brbeardm/PelletPirate/zzz_documentation/pcb_schematics/PCB_V0.png

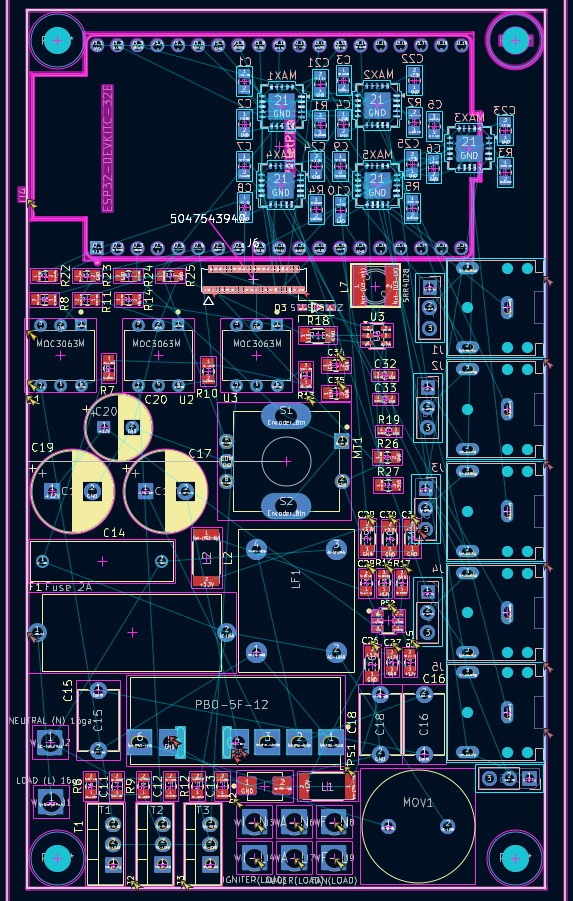
zzz_documentation/pcb_schematics/PCB_V0.png
