brbeardm/PelletPirate/KiCad/ESP_Breadboard/gerbers/PelletPirate_ESP-3D_views.pdf

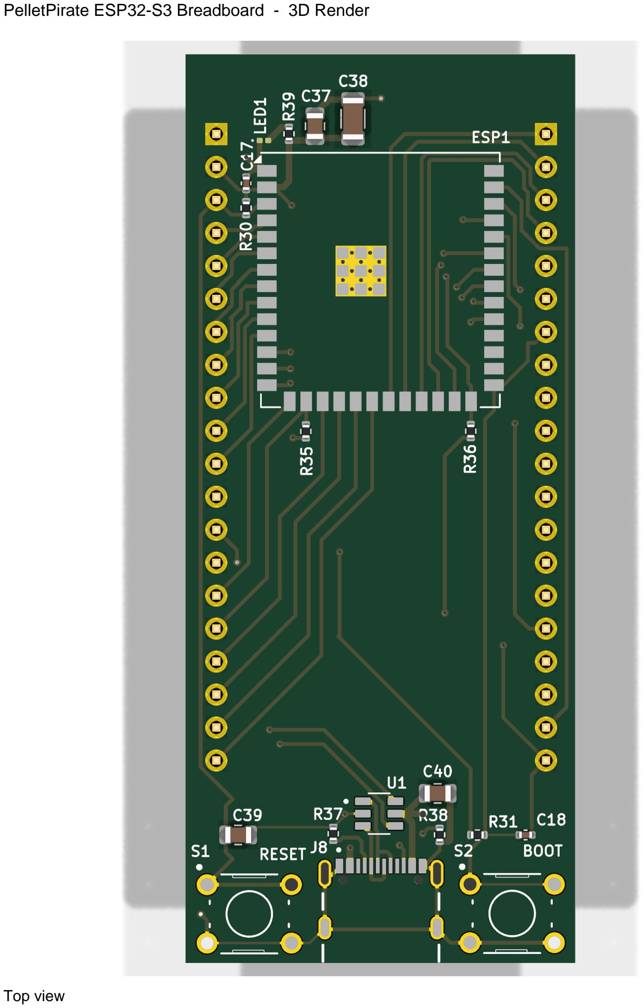
[picture p2: page 1]

PelletPirate ESP32-S3 Breadboard - 3D Render

Top view

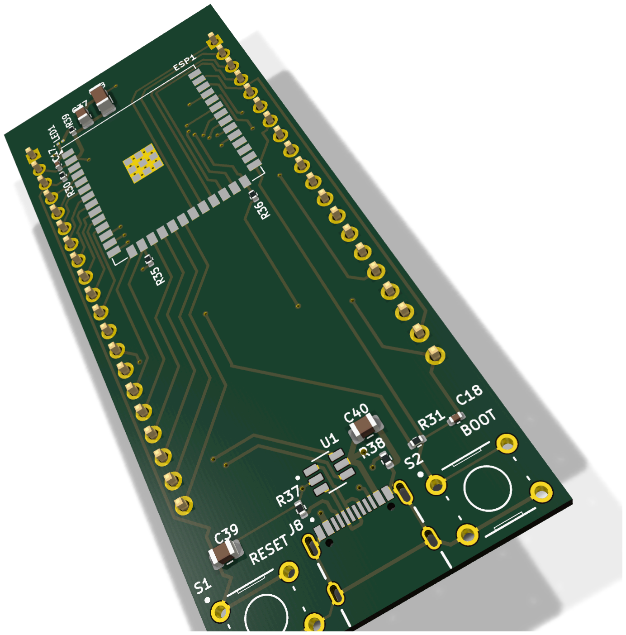
[picture p3: figure]

Perspective view

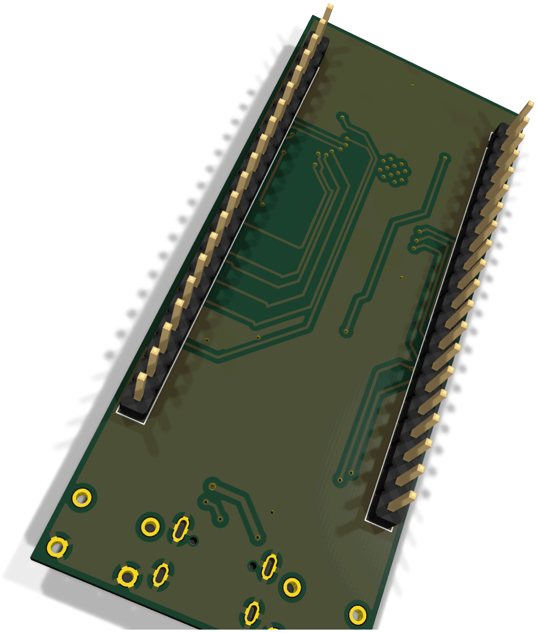
[picture p4: figure]

Bottom view - breadboard pin rails
