brbeardm/PelletPirate/KiCad/FPC_for_PCB_to_LCD_RevH/FPCWay_REV_H_Package/PCB_to_LCD_FPC_REV_H_DimensionSheet.pdf

FPC edge Y0

Finger profiles (mm) — Y0 = FPC edge, +Y toward ribbon | GOLDEN-FINGER SPECIFICATION
Connector | Hirose FH26W-39S-0.3SHW(60), bottom-contact ZIF
Positions / pitch | 39 / 0.30 mm (straight-through 1->1 .. 39->39)

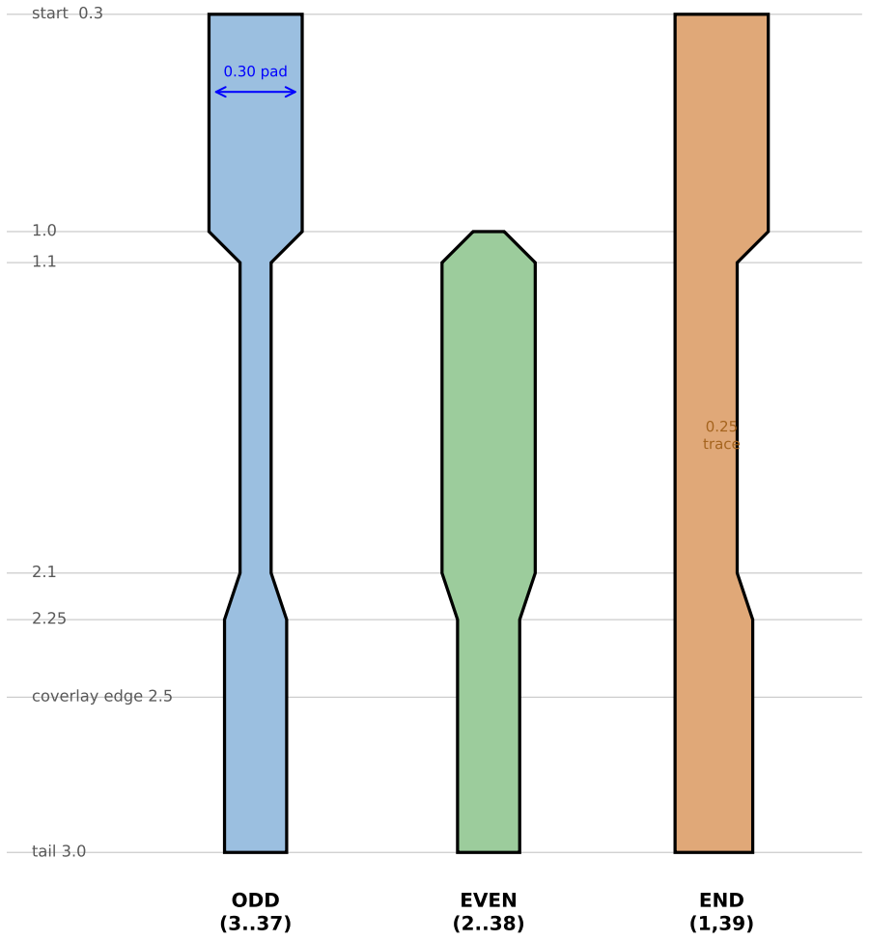
[picture p5: figure]
ODD (3..37); EVEN (2..38); END (1,39); start 0.3; coverlay edge 2.5; tail 3.0; 0.30 pad; 0.25 trace

Pattern | STAGGERED 2-row (odd short / even long) — matches datasheet
Odd (3..37) | exposed 1.1 mm; 0.30 pad -> 0.1 trace -> 0.2 ribbon
Even (2..38) | exposed 2.1 mm; 0.1 tip -> 0.30 pad -> 0.2 ribbon
Ends (1,39) | 0.30 pad -> 0.20 -> 0.25 outer trace, mirror pair
Finger setback | 0.30 mm from FPC leading edge
Edge margin | 0.15 mm (outer copper to FPC side edge)
Tongue F/C/B | 12.0 / 11.4 / 10.8 mm
Taper spacing | 0.0707 mm min (= 0.10 x cos45, per datasheet)
Tip relief | R0.2 max, two outer tongue corners
Coverlay | SINGLE window over finger bank, 12.0 x 2.5 mm (back)
Construction | 2-layer flex; 39 plated through-vias front->back
Finish / thick. | ENIG; mating thickness 0.20 +/-0.03 mm
Stiffener | 0.15 mm SUS under connector area

### NOTES

1. Finger rebuilt to Hirose Recommended-FPC STAGGERED pattern (prior comb wrong).
2. 0.0707 mm taper spacing is intentional (datasheet) — confirm process capability.
3. Coverlay = one window; per-pad mask openings in gerbers are indicative only.
PelletPirate LCD-to-Main FPC | Golden Finger — Hirose FH26W-39S-0.3SHW | REV H | 2026-08-16
