brbeardm/PelletPirate/zzz_documentation/pcb_schematics/ACtoDC.pdf

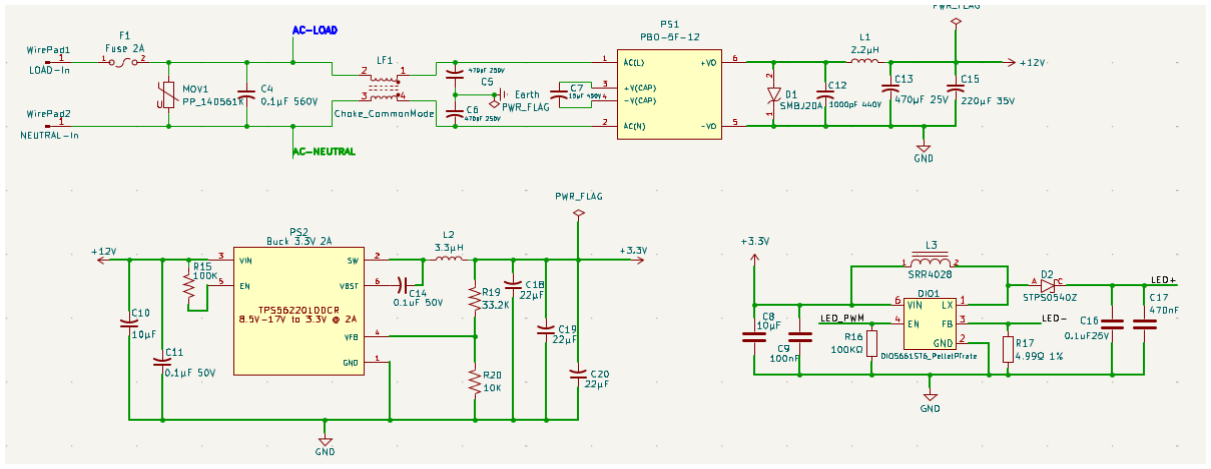
[picture p6: figure]
