brbeardm/PelletPirate/KiCad/FPC_for_PCB_to_LCD_RevF/report.txt

Info: Backing up file 'C:\DEVELOPMENT\pelletpirate\KiCad\FPC_for_PCB_to_LCD_RevF\sym-lib-table' to 'C:\DEVELOPMENT\pelletpirate\KiCad\FPC_for_PCB_to_LCD_RevF\rescue-backup\sym-lib-table-2026-08-14-11-17-50'.
Info: Backing up file '' to 'C:\DEVELOPMENT\pelletpirate\KiCad\FPC_for_PCB_to_LCD_RevF\rescue-backup\-2026-08-14-11-17-50'.
Info: Backing up file 'C:\DEVELOPMENT\pelletpirate\KiCad\FPC_for_PCB_to_LCD_RevF\PCB_to_LCD_FPC_REV_F.sch' to 'C:\DEVELOPMENT\pelletpirate\KiCad\FPC_for_PCB_to_LCD_RevF\rescue-backup\PCB_to_LCD_FPC_REV_F-2026-08-14-11-17-50.sch'.
Info: Backing up file 'C:\DEVELOPMENT\pelletpirate\KiCad\FPC_for_PCB_to_LCD_RevF\PCB_to_LCD_FPC_REV_F.kicad_pro' to 'C:\DEVELOPMENT\pelletpirate\KiCad\FPC_for_PCB_to_LCD_RevF\rescue-backup\PCB_to_LCD_FPC_REV_F-2026-08-14-11-17-50.kicad_pro'.
Info: Backing up file 'C:\DEVELOPMENT\pelletpirate\KiCad\FPC_for_PCB_to_LCD_RevF\PCB_to_LCD_FPC_REV_F-cache.lib' to 'C:\DEVELOPMENT\pelletpirate\KiCad\FPC_for_PCB_to_LCD_RevF\rescue-backup\PCB_to_LCD_FPC_REV_F-cache-2026-08-14-11-17-50.lib'.
Info: Backing up file 'C:\DEVELOPMENT\pelletpirate\KiCad\FPC_for_PCB_to_LCD_RevF\PCB_to_LCD_FPC_REV_F.cache.lib' to 'C:\DEVELOPMENT\pelletpirate\KiCad\FPC_for_PCB_to_LCD_RevF\rescue-backup\PCB_to_LCD_FPC_REV_F.cache-2026-08-14-11-17-50.lib'.
Info: Backing up file 'C:\DEVELOPMENT\pelletpirate\KiCad\FPC_for_PCB_to_LCD_RevF\PCB_to_LCD_FPC_REV_F-rescue.lib' to 'C:\DEVELOPMENT\pelletpirate\KiCad\FPC_for_PCB_to_LCD_RevF\rescue-backup\PCB_to_LCD_FPC_REV_F-rescue-2026-08-14-11-17-50.lib'.
Info: Backing up file 'C:\DEVELOPMENT\pelletpirate\KiCad\FPC_for_PCB_to_LCD_RevF\PCB_to_LCD_FPC_REV_F-rescue.dcm' to 'C:\DEVELOPMENT\pelletpirate\KiCad\FPC_for_PCB_to_LCD_RevF\rescue-backup\PCB_to_LCD_FPC_REV_F-rescue-2026-08-14-11-17-50.dcm'.
Info: Adding library 'PCB_to_LCD_FPC_REV_F-rescue', file '${KIPRJMOD}/PCB_to_LCD_FPC_REV_F-rescue.lib' to project symbol library table.
Symbol CONN_01X39 mapped to symbol library 'PCB_to_LCD_FPC_REV_F-rescue'.
Symbol CONN_01X39 mapped to symbol library 'PCB_to_LCD_FPC_REV_F-rescue'.
Info: Symbol library table mapping complete!
Info: Created project symbol library table.
