brbeardm/PelletPirate/KiCad/FPC_for_PCB_to_LCD_RevG/FPCWay_REV_H_Package/PCB_to_LCD_FPC_REV_H_DimensionSheet.pdf

FPC edge Y0

Finger profiles (mm) — Y0 = FPC edge, +Y toward ribbon | GOLDEN-FINGER SPECIFICATION
Connector | Hirose FH26W-39S-0.3SHW(60), bottom-contact ZIF

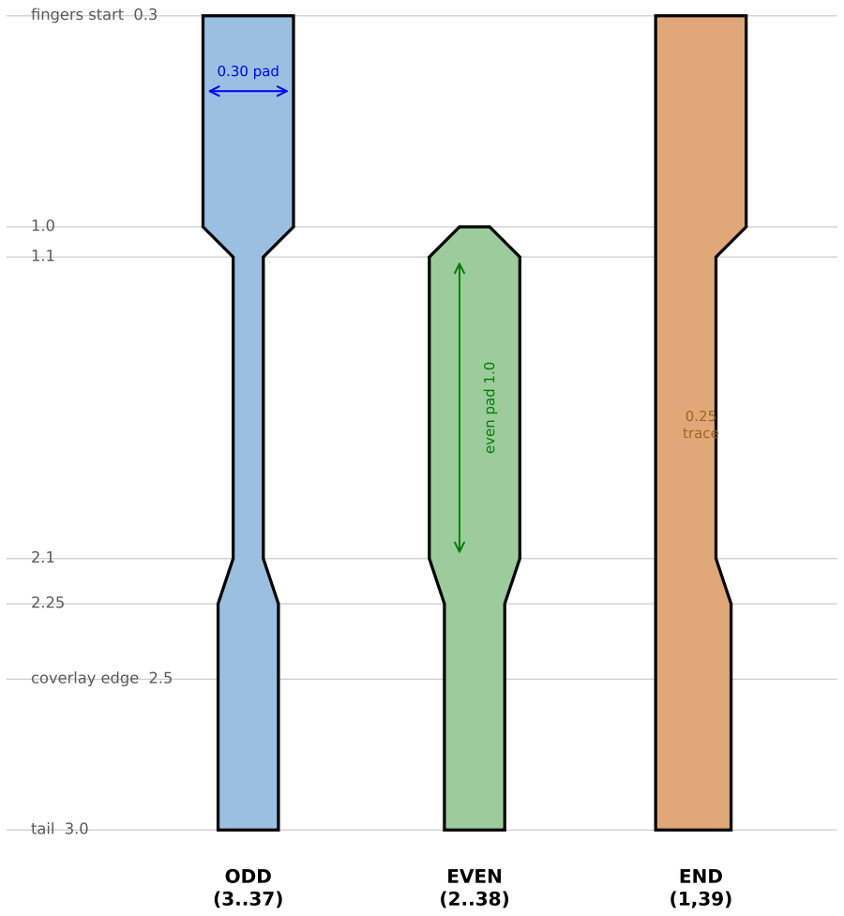
[picture p7: figure]
ODD (3..37); EVEN (2..38); END (1,39); fingers start 0.3; coverlay edge 2.5; tail 3.0; 0.30 pad; even pad 1.0; 0.25 trace

Positions / pitch | 39 / 0.30 mm (straight-through pin 1->1 .. 39->39)
Pattern | STAGGERED 2-row (odd short / even long) — matches datasheet Recommended FPC
Odd fingers (3..37) | exposed 1.1 mm; 0.30 pad -> 0.1 trace between evens -> 0.2 ribbon
Even fingers (2..38) | exposed 2.1 mm; 0.1 tip -> 0.30 pad -> 0.2 ribbon
End fingers (1,39) | 0.30 pad -> 0.20 (past finger 2) -> 0.25 outer trace, mirror pair
Finger start setback | 0.30 mm from FPC leading edge
Edge margin | 0.15 mm (outer finger copper to FPC side edge)
Tongue widths | F/C/B = 12.0 / 11.4 / 10.8 mm
Taper-zone spacing | 0.0707 mm min (= 0.10 x cos45, per datasheet geometry)
Tip relief | R0.2 max at the two outer tongue corners
Coverlay window | SINGLE opening over finger bank, 12.0 x 2.5 mm (back side)
Construction | 2-layer double-sided flex; 39 plated through-vias front->back
Finish / thickness | ENIG; finished mating thickness 0.20 +/-0.03 mm
Stiffener | 0.15 mm SUS under connector mounting area

### NOTES

1. Golden finger rebuilt to the Hirose Recommended-FPC STAGGERED pattern (prior

uniform-comb versions were incorrect).

2. The 0.0707 mm taper-zone copper spacing is intentional (datasheet geometry) —
PelletPirate LCD-to-Main FPC | Golden Finger — Hirose FH26W-39S-0.3SHW | REV H | 2026-08-16
