brbeardm/PelletPirate/KiCad/PelletPirate_V3/V3_Pinout_Conversion.xlsx

 | Left Bank of Pins |  |  |  |  | Right Bank of Pins
 | Pin | Current Function | Current I/O | New S3 I/O | Comment | Pin | Current Function | Current I/O | New S3 I/O | Comment
 | 1 | +3.3V-in / 10K-->EN | +3.3V | GND |  | 1 | GND | GND | GND
25.4 | 2 | 10KΩ-->EN-in | EN | +3.3V |  | 2 | ALL_SDI | 23 | 43 | move to pin19 - unused
-1.27 | 3 | Encoder_Btn | 36 | RST | move to pin16 - unused | 3 | -not used- | 22 | 44
-1.27 | 4 | -not used- | 39 | 4 |  | 4 | -not used- | TXDO | 1
 | 5 | Encoder_OutA | 34 | 5 |  | 5 | -not used- | RXDO | 2
 | 6 | Encoder_OutB | 35 | 6 |  | 6 | MAX5_CS | 21 | 42
 | 7 | IGNITER_IO | 32 | 7 |  | 7 | GND | GND | 41
 | 8 | AUGER_IO | 33 | 15 |  | 8 | MAX_SDO | 19 | 40
 | 9 | LCD_CS | 25 | 16 |  | 9 | ALL_SCLK | 18 | 39
 | 10 | MAX4_CS | 26 | 17 |  | 10 | MAX3_CS | 5 | 38
 | 11 | MAX1_CS | 27 | 18 |  | 11 | LED_PWM | 17 | 37
 | 12 | LCD_DC | 14 | 8 |  | 12 | LCS_RST | 16 | 36
 | 13 | 10KΩ->GND | 12 | 3 | remove 10KΩ - unused | 13 | FAN_IO | 4 | 35
 | 14 | GND | GND | 46 |  | 14 | 10KΩ to +3.3V | 0 | 0 BOOT | correct for S3 too
 | 15 | MAX2_CS | 13 | 9 |  | 15 | new 10KΩ --> GND pulldown | 2 | 45 VSPI | new 10KΩ->GND
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
