brbeardm/PelletPirate/KiCad/ESP_Breadboard/gerbers/PelletPirate_ESP-3D_top.png

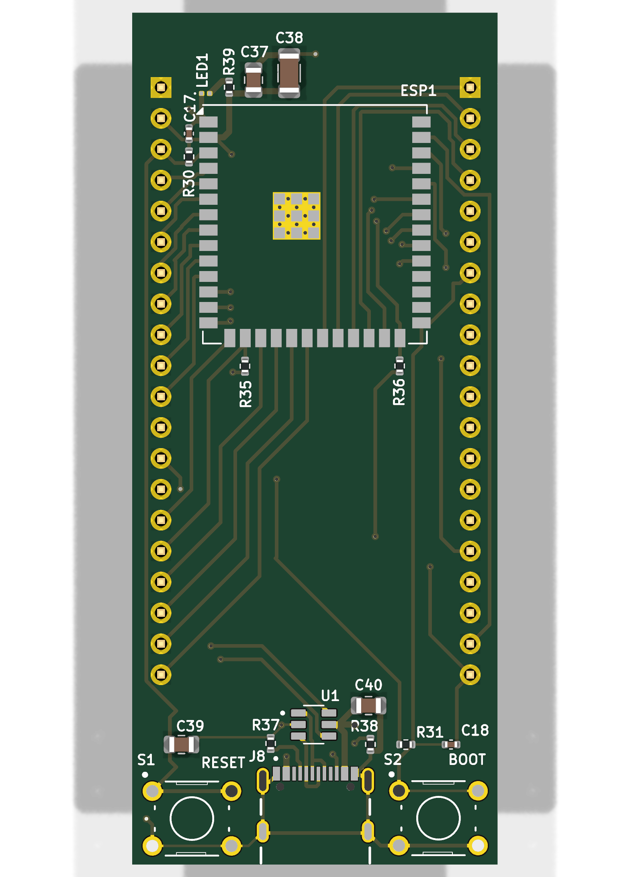
KiCad/ESP_Breadboard/gerbers/PelletPirate_ESP-3D_top.png
