brbeardm/PelletPirate/KiCad/FPC_for_PCB_to_LCD_RevH/_back_pin1top_check.png

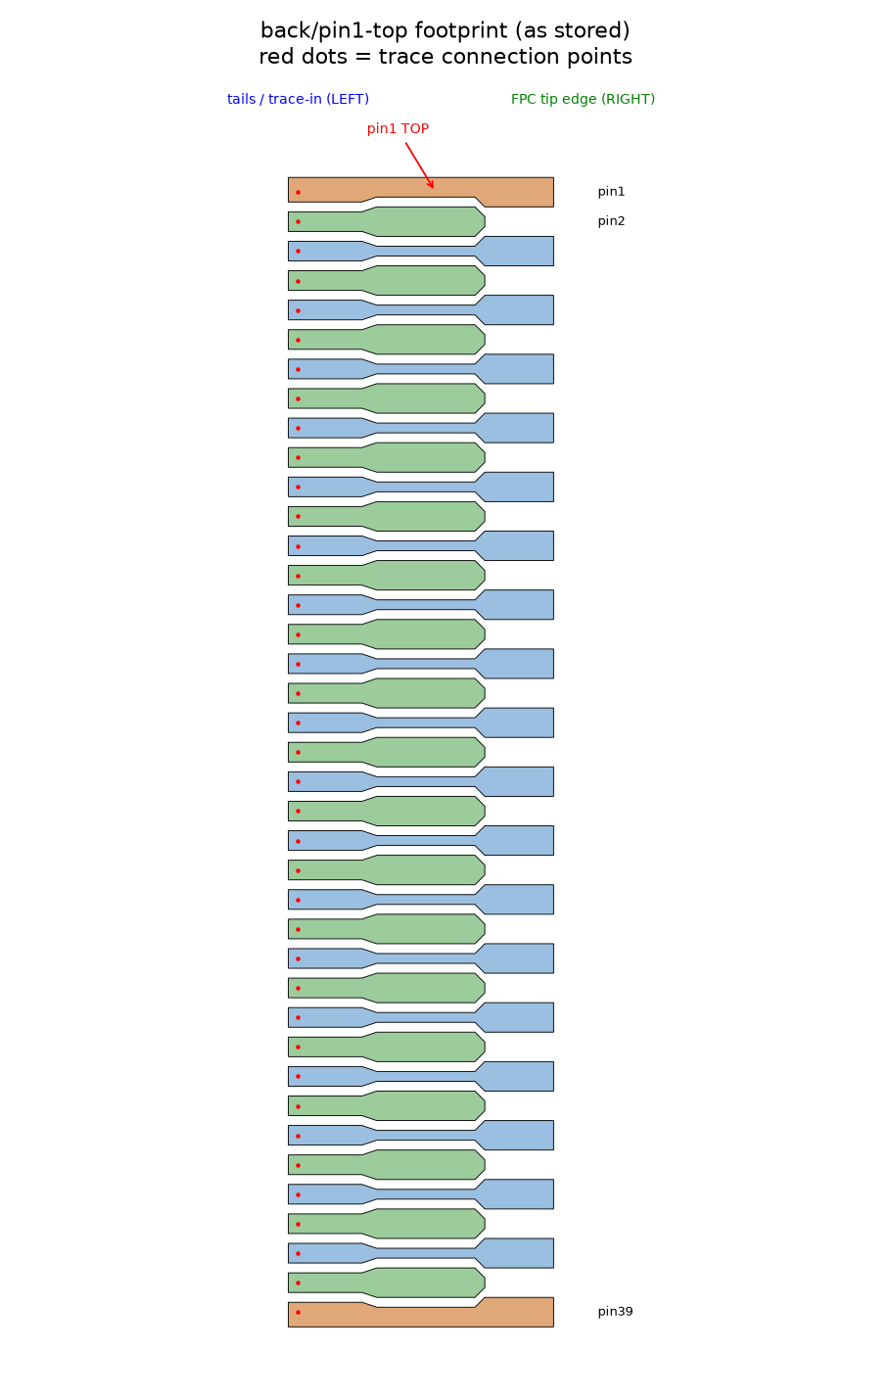
KiCad/FPC_for_PCB_to_LCD_RevH/_back_pin1top_check.png
