brbeardm/PelletPirate/KiCad/FPC_for_PCB_to_LCD_RevH/FPCWay_REV_H_Package/PCB_to_LCD_FPC_REV_H_DimensionSheet.png

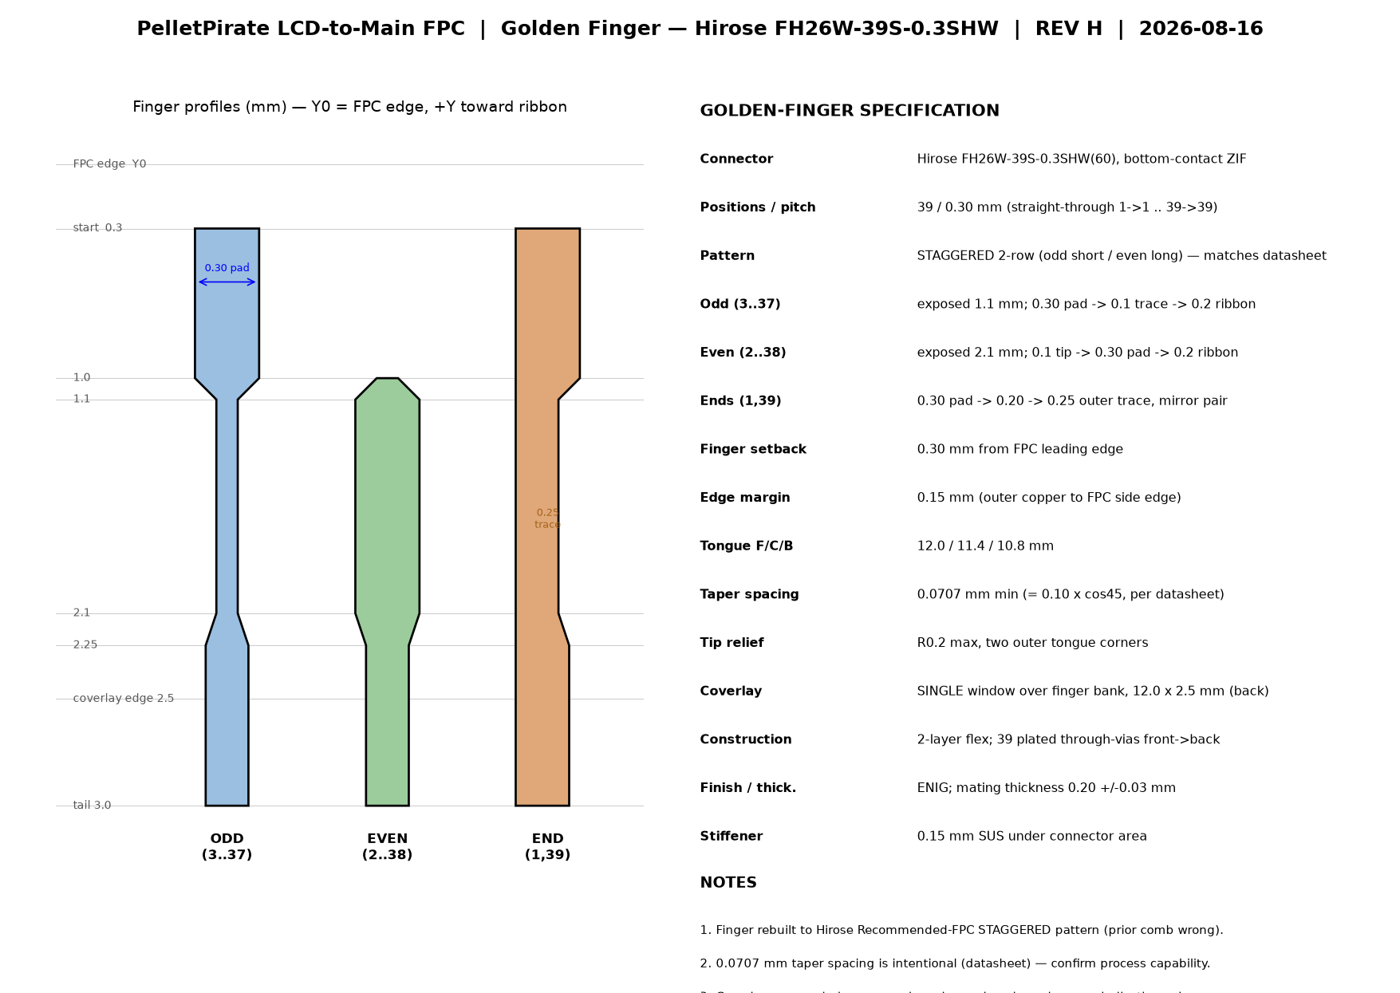
KiCad/FPC_for_PCB_to_LCD_RevH/FPCWay_REV_H_Package/PCB_to_LCD_FPC_REV_H_DimensionSheet.png
