brbeardm/PelletPirate/KiCad/pelletpirate_V5v1/PelletPirate_V5_topside_placement_sketch.png

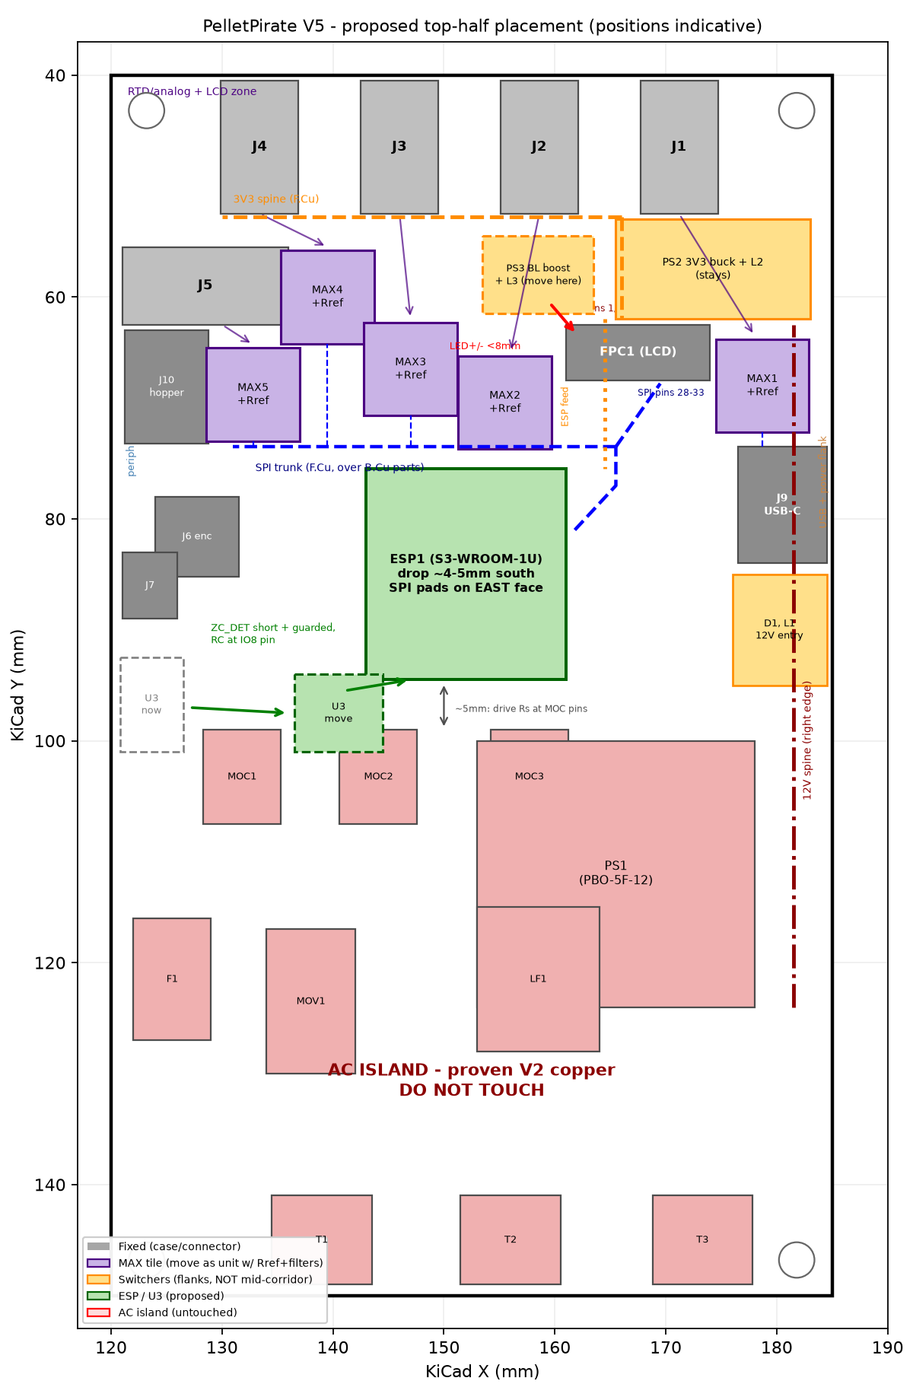
KiCad/pelletpirate_V5v1/PelletPirate_V5_topside_placement_sketch.png
