brbeardm/PelletPirate/pelletpirate_ESP/images/dashboard.png

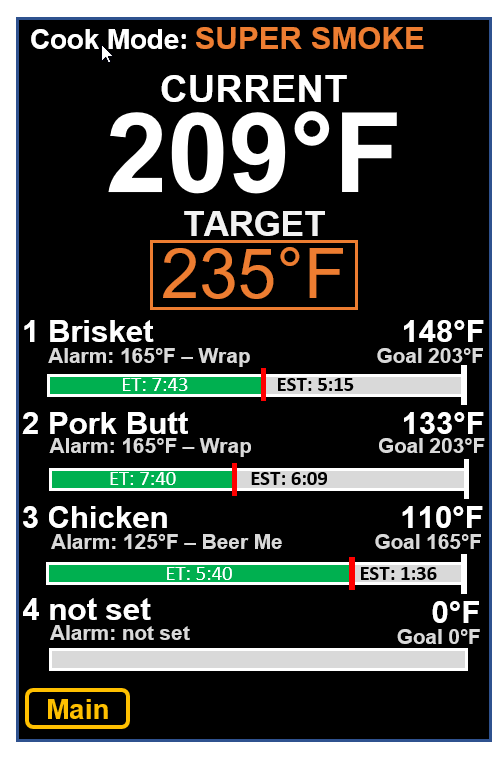
pelletpirate_ESP/images/dashboard.png
