brbeardm/PelletPirate/pelletpirate_ESP/images/MenuSystem.png

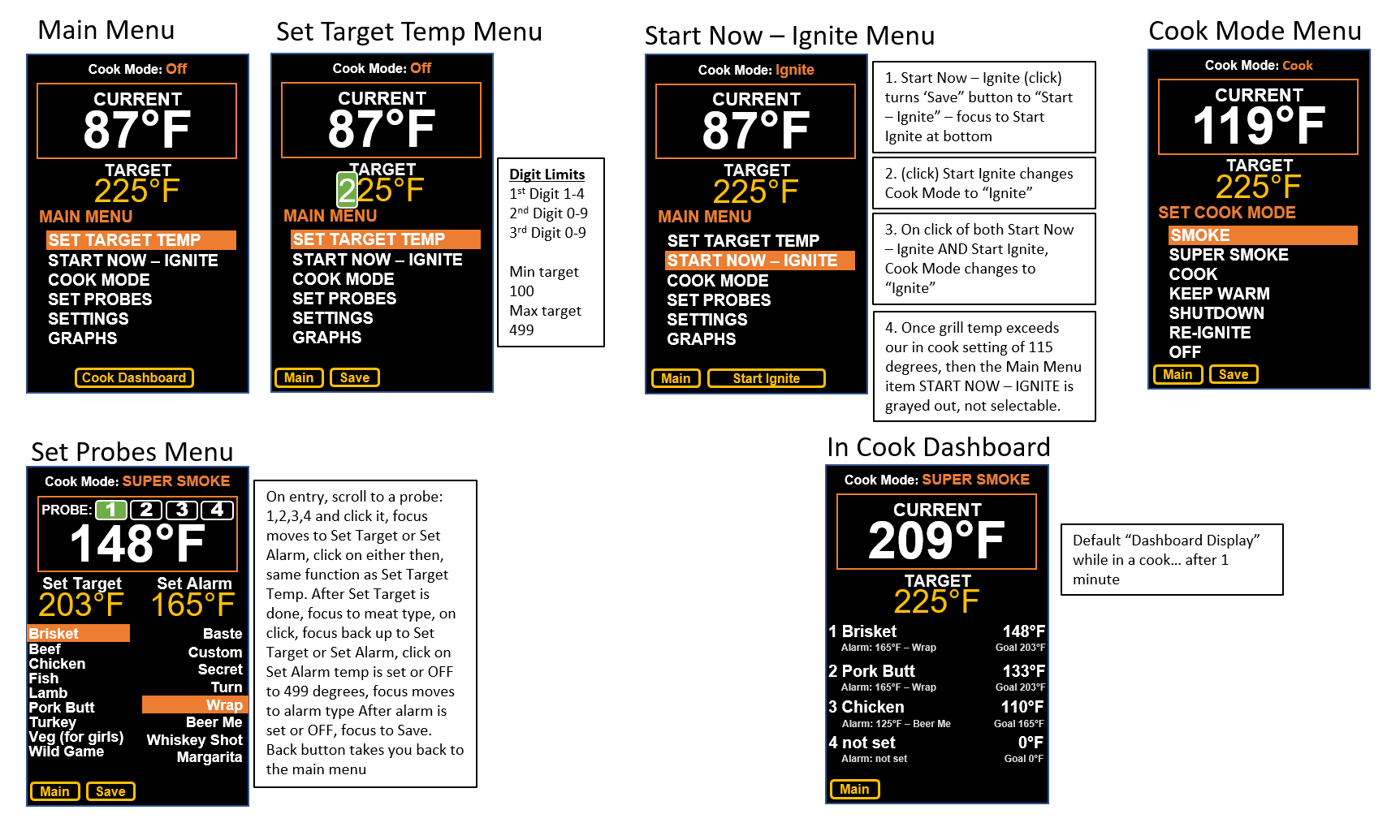
pelletpirate_ESP/images/MenuSystem.png
