brbeardm/PelletPirate/pelletpirate_ESP/images/Probe_Menu.png

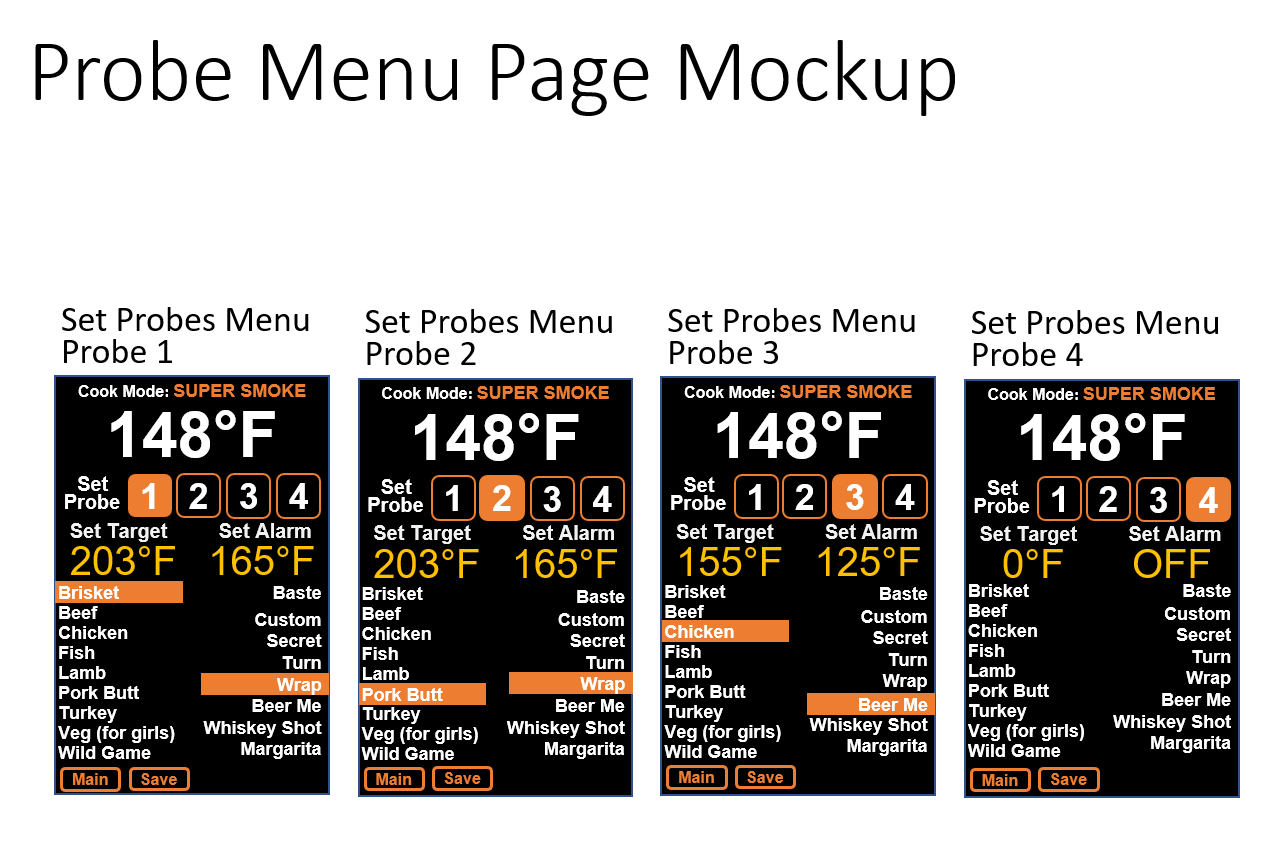
pelletpirate_ESP/images/Probe_Menu.png
