brbeardm/PelletPirate/rainbow_hunt/captures/ac10x_hunt_view.png

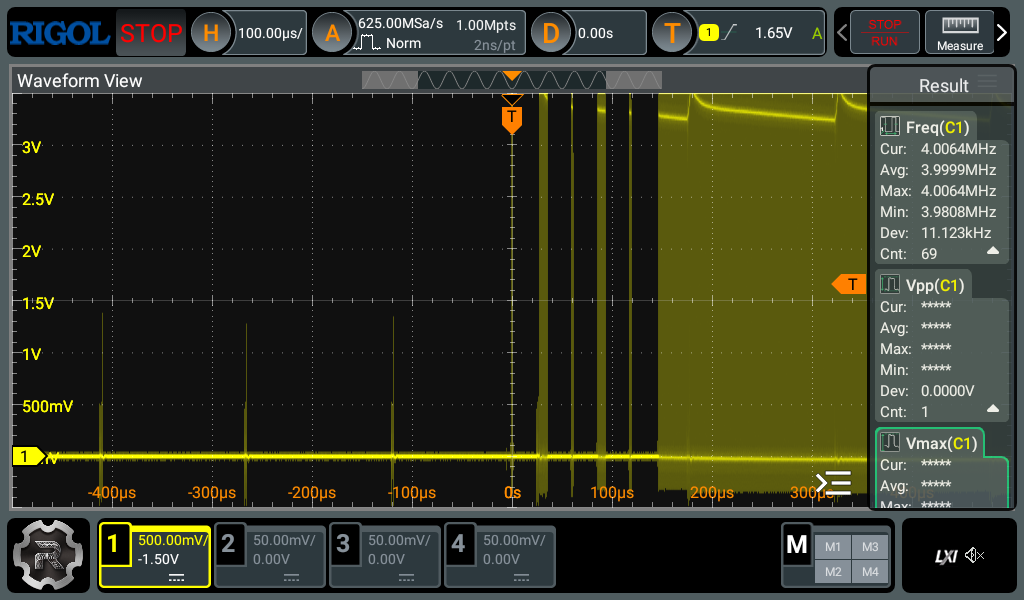
rainbow_hunt/captures/ac10x_hunt_view.png
