brbeardm/PelletPirate/rainbow_hunt/captures/AC_3rail_envelope.png

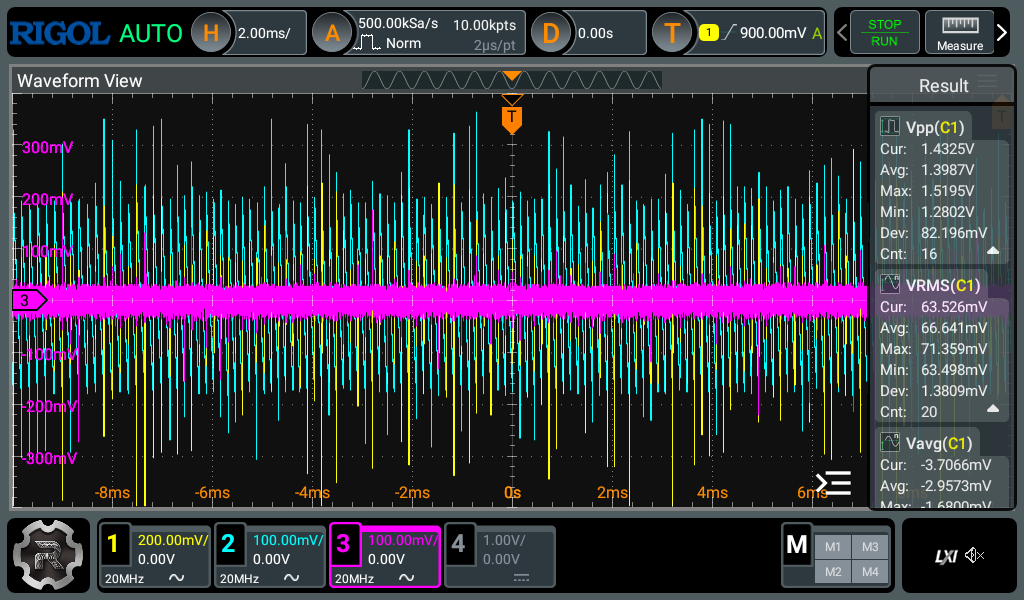
rainbow_hunt/captures/AC_3rail_envelope.png
