brbeardm/PelletPirate/rainbow_hunt/captures/AC_3rail_hash.png

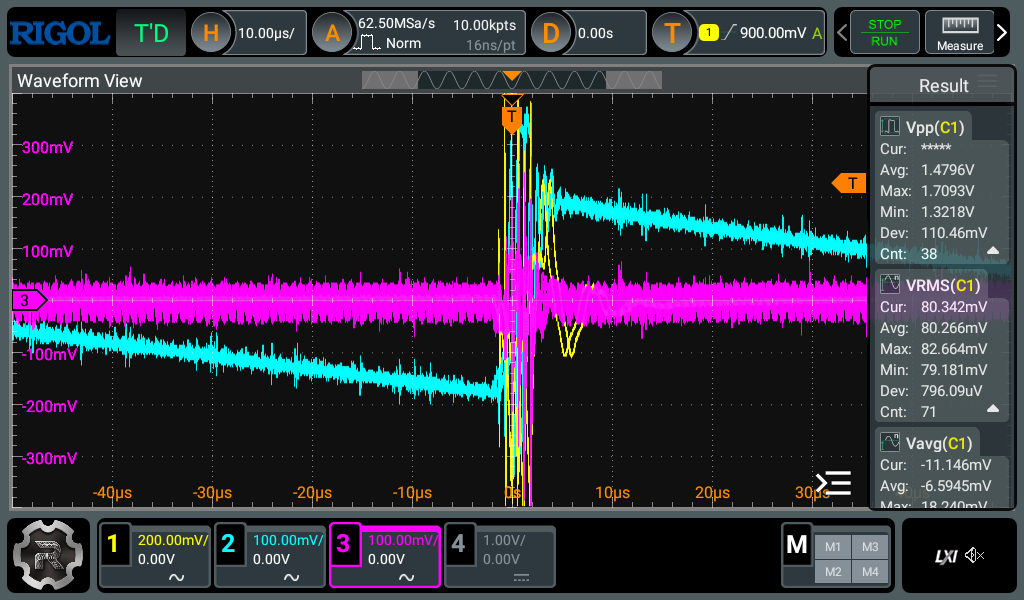
rainbow_hunt/captures/AC_3rail_hash.png
