brbeardm/PelletPirate/rainbow_hunt/captures/AC_3V3_burst_interior_20us.png

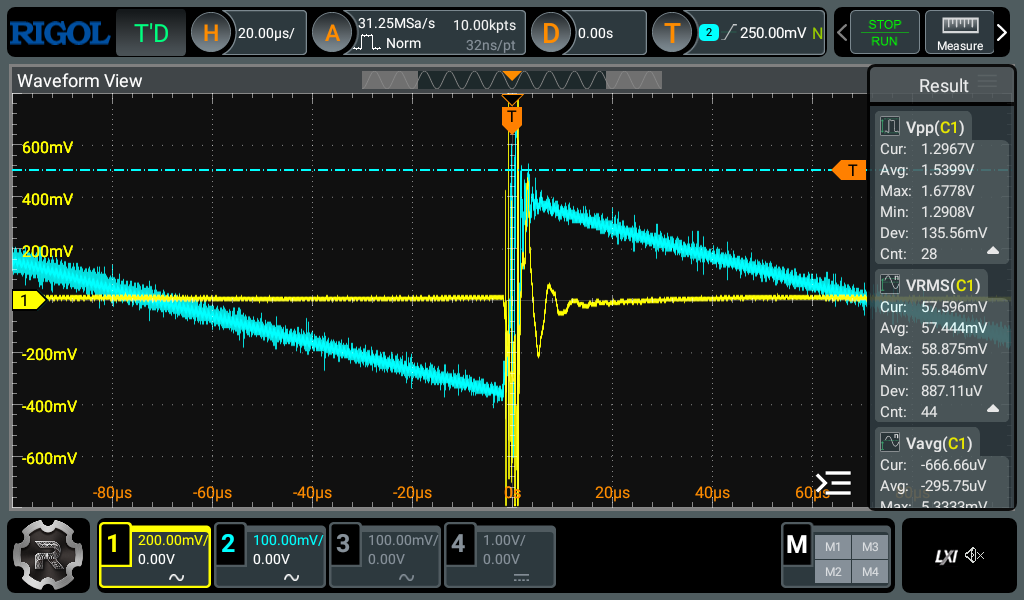
rainbow_hunt/captures/AC_3V3_burst_interior_20us.png
