brbeardm/PelletPirate/rainbow_hunt/captures/AC_3V3_burst_spacing_5ms.png

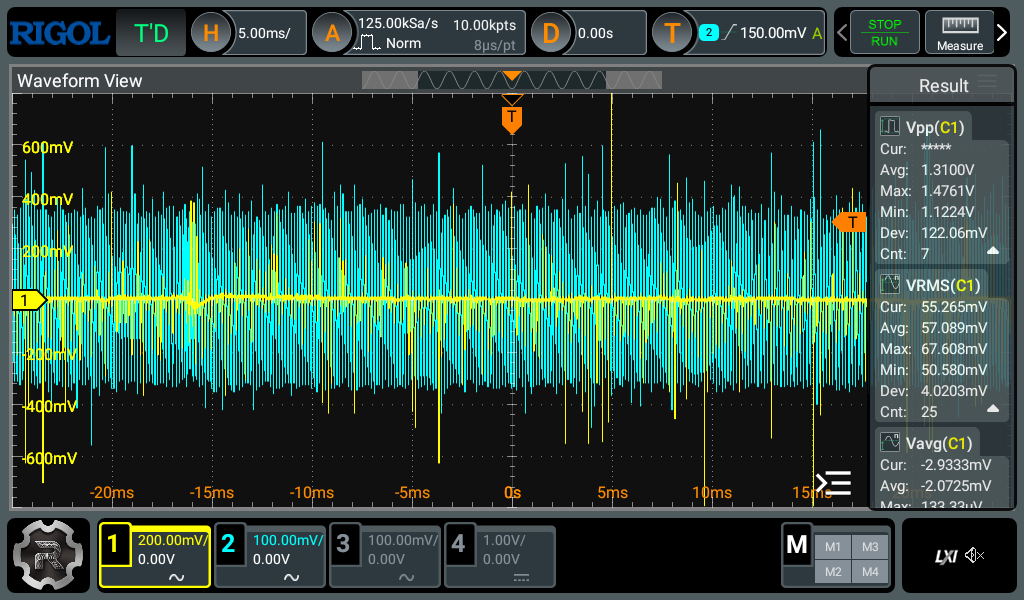
rainbow_hunt/captures/AC_3V3_burst_spacing_5ms.png
