brbeardm/PelletPirate/rainbow_hunt/captures/AC_3V3_linetrigger_frame1.png

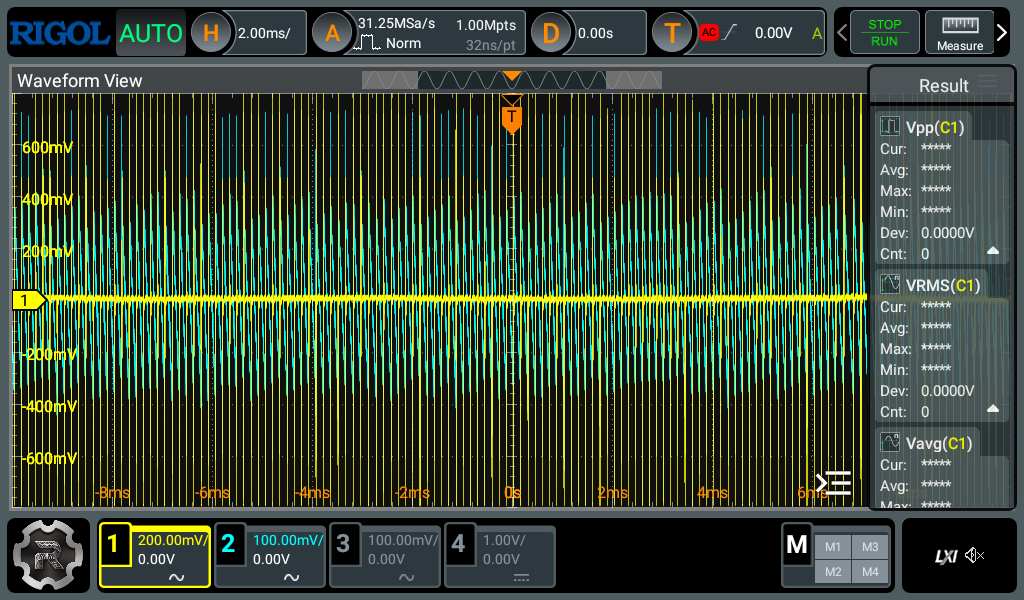
rainbow_hunt/captures/AC_3V3_linetrigger_frame1.png
