brbeardm/PelletPirate/rainbow_hunt/captures/AC_correlate_12V_vs_3V3_2ms.png

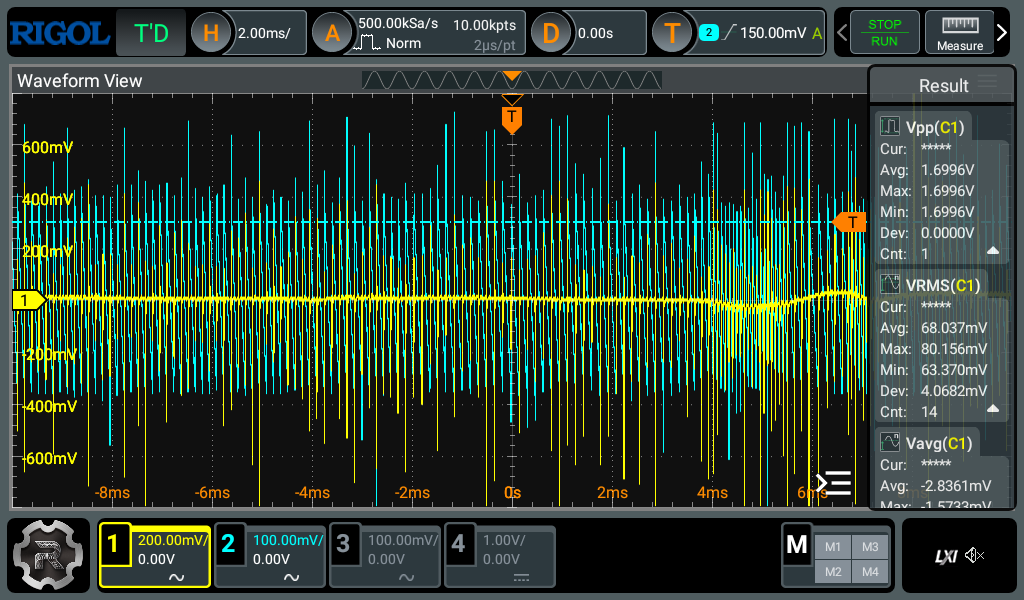
rainbow_hunt/captures/AC_correlate_12V_vs_3V3_2ms.png
