brbeardm/PelletPirate/rainbow_hunt/captures/AC_correlate_12V_vs_3V3_200us.png

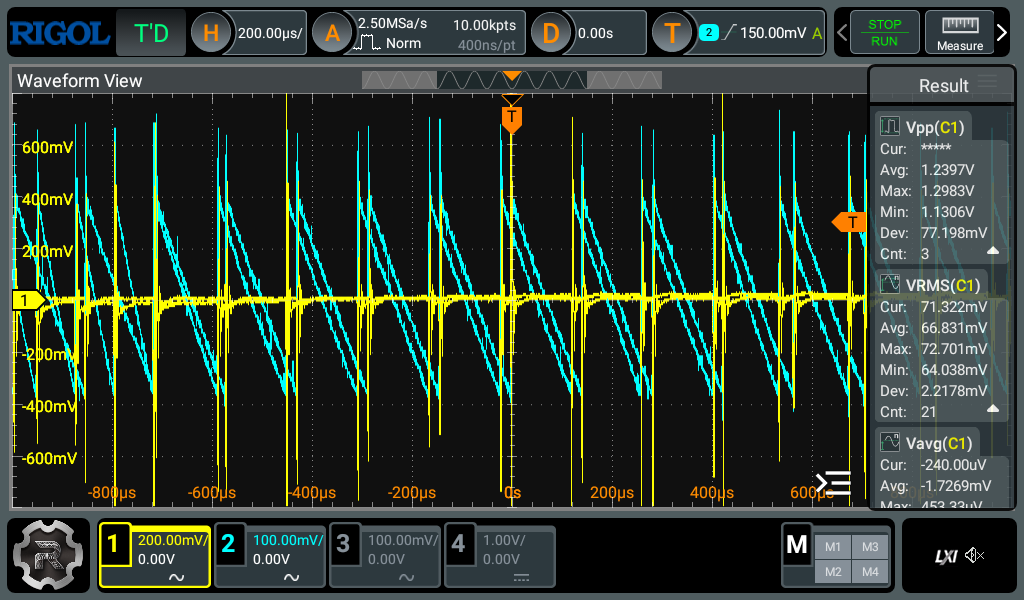
rainbow_hunt/captures/AC_correlate_12V_vs_3V3_200us.png
