brbeardm/PelletPirate/rainbow_hunt/captures/bench_3rail_envelope.png

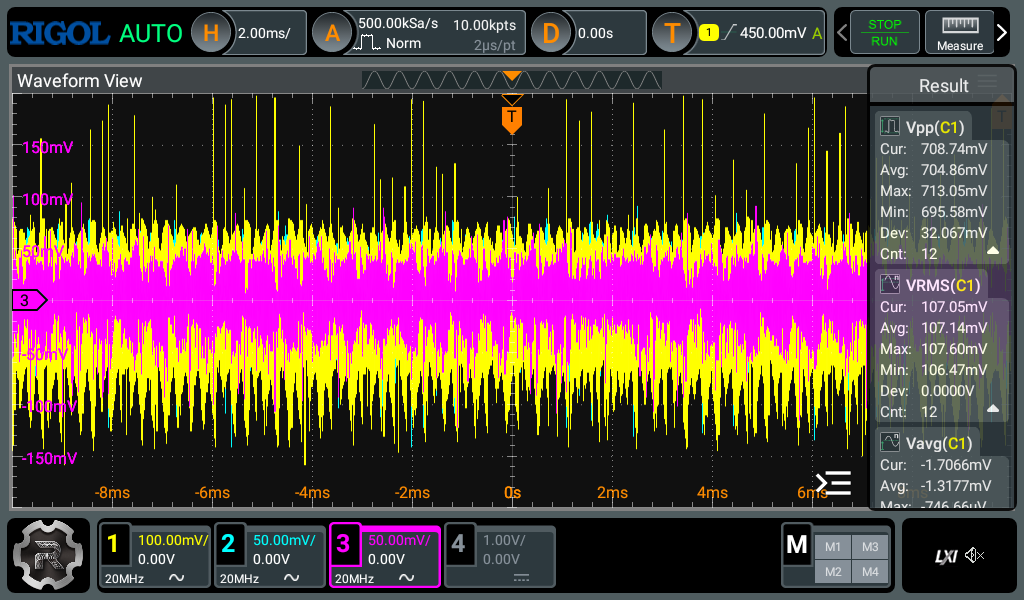
rainbow_hunt/captures/bench_3rail_envelope.png
