brbeardm/PelletPirate/rainbow_hunt/captures/bench_3rail_hash.png

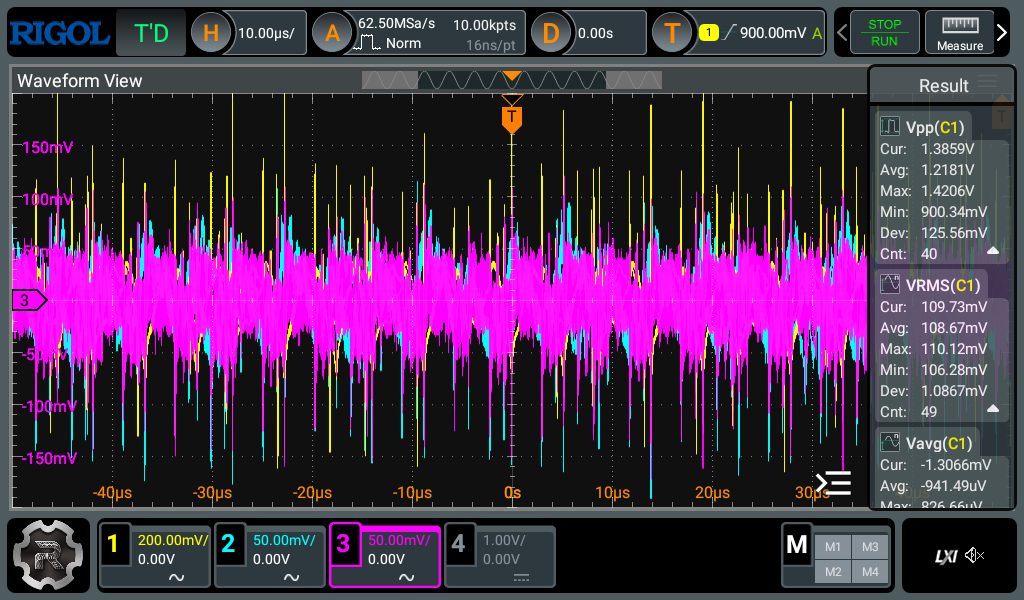
rainbow_hunt/captures/bench_3rail_hash.png
