brbeardm/PelletPirate/rainbow_hunt/captures/bench_12V_envelope_ranged.png

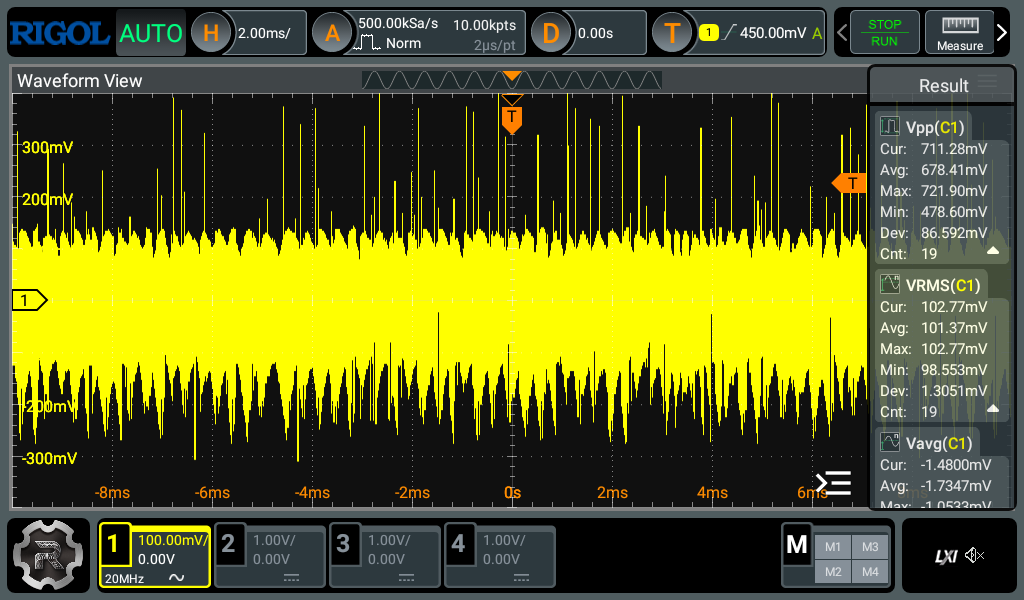
rainbow_hunt/captures/bench_12V_envelope_ranged.png
