brbeardm/PelletPirate/rainbow_hunt/captures/bench_12V_envelope_v2.png

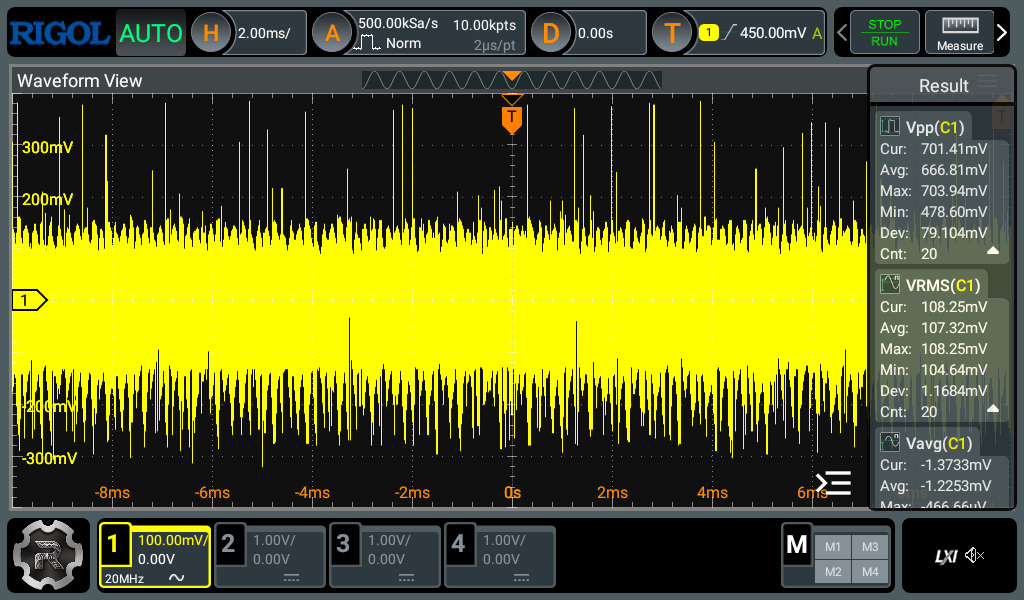
rainbow_hunt/captures/bench_12V_envelope_v2.png
