brbeardm/PelletPirate/rainbow_hunt/captures/bench_12V_hash_ranged.png

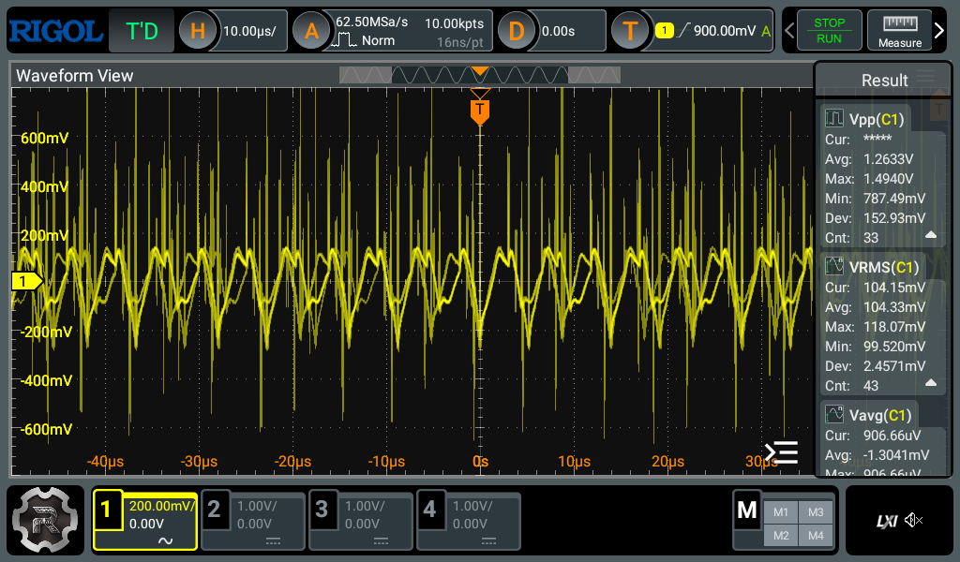
rainbow_hunt/captures/bench_12V_hash_ranged.png
