brbeardm/PelletPirate/rainbow_hunt/captures/bench_12V_hash_v2.png

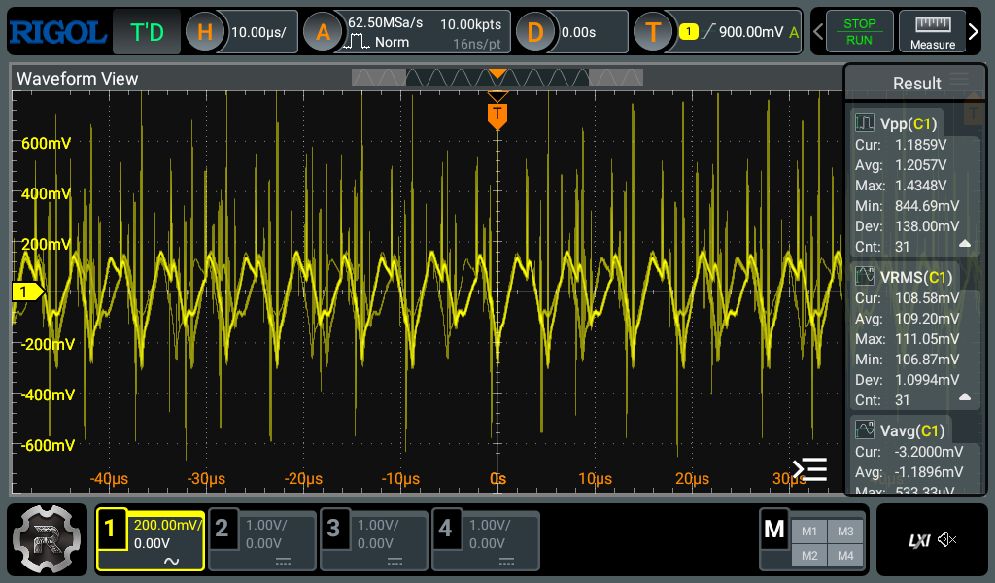
rainbow_hunt/captures/bench_12V_hash_v2.png
