brbeardm/PelletPirate/rainbow_hunt/captures/board2_bodge100u_AC.png

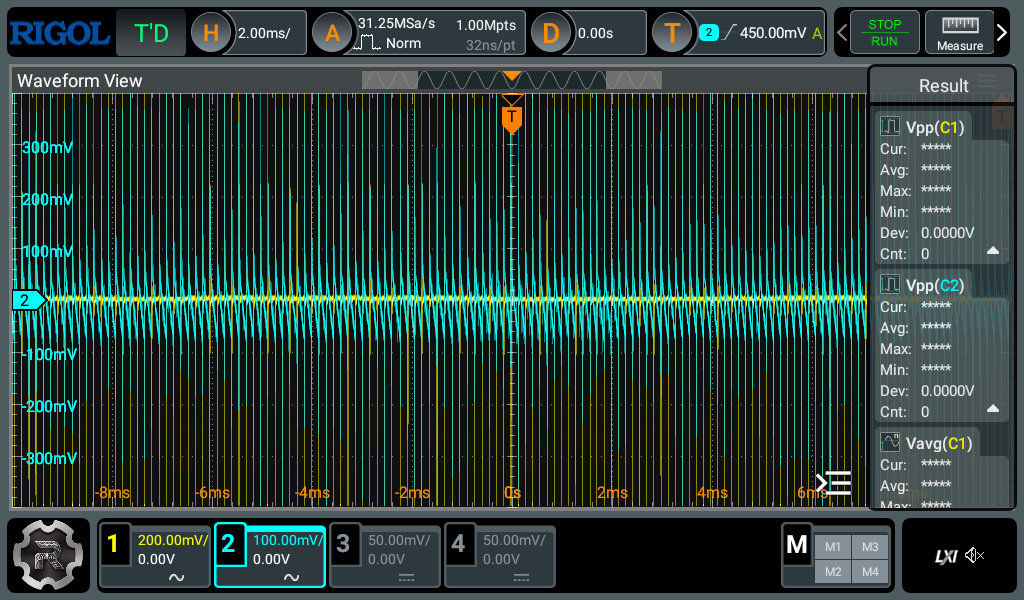
rainbow_hunt/captures/board2_bodge100u_AC.png
