brbeardm/PelletPirate/rainbow_hunt/captures/board2_bodge100u_AC_v2.png

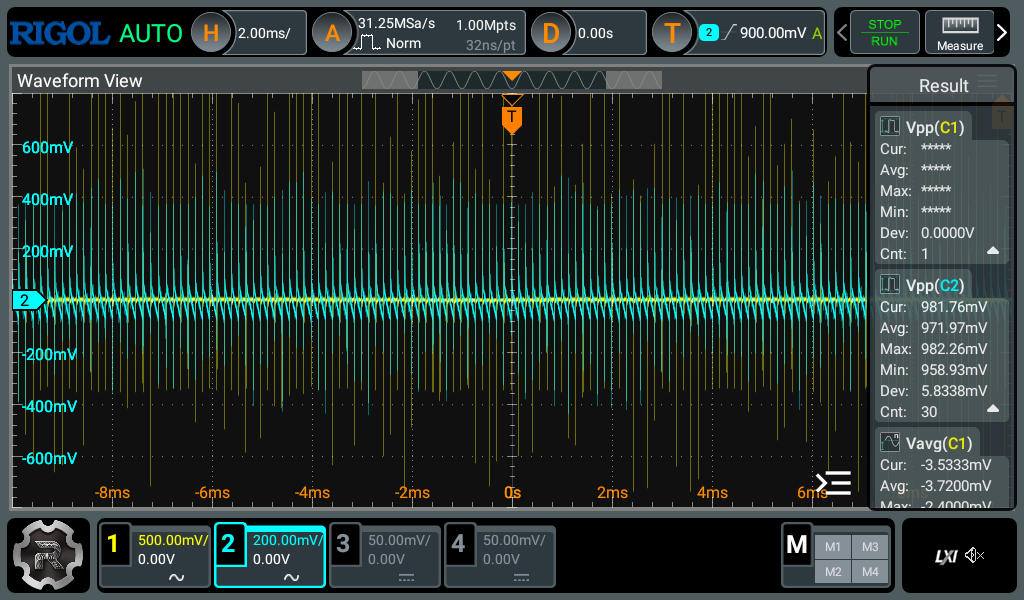
rainbow_hunt/captures/board2_bodge100u_AC_v2.png
