brbeardm/PelletPirate/rainbow_hunt/captures/board2_c13_220u_AC_rails.png

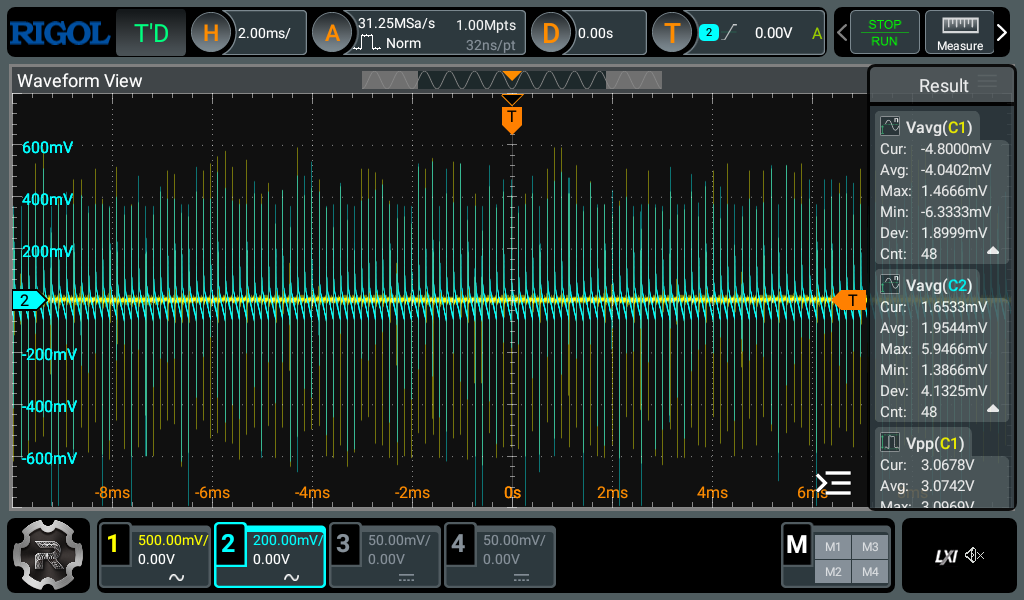
rainbow_hunt/captures/board2_c13_220u_AC_rails.png
