brbeardm/PelletPirate/rainbow_hunt/captures/board2_rainbow_visible_AC_rails.png

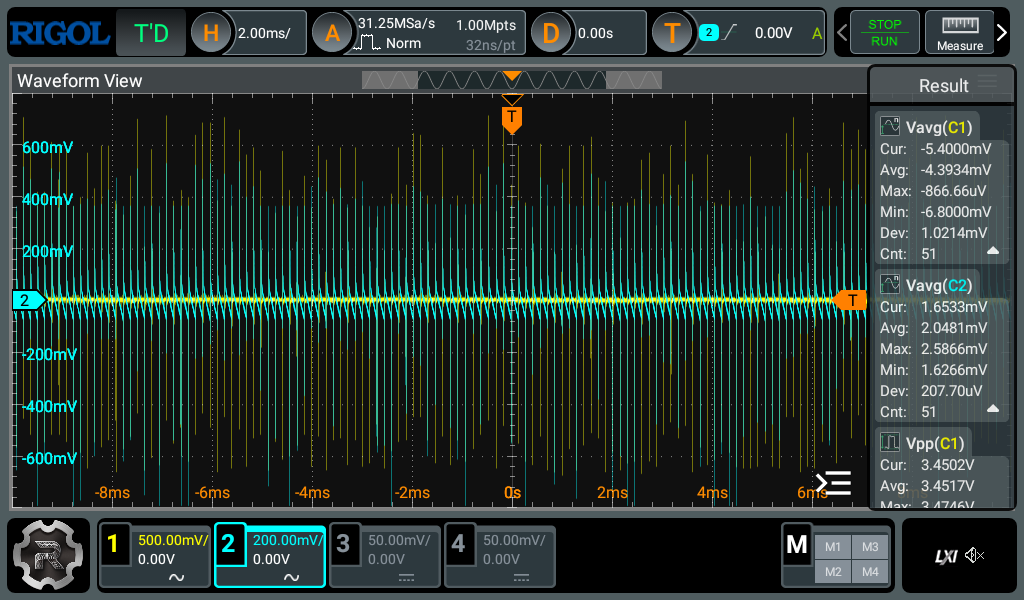
rainbow_hunt/captures/board2_rainbow_visible_AC_rails.png
