brbeardm/PelletPirate/rainbow_hunt/captures/board3_AC_rails.png

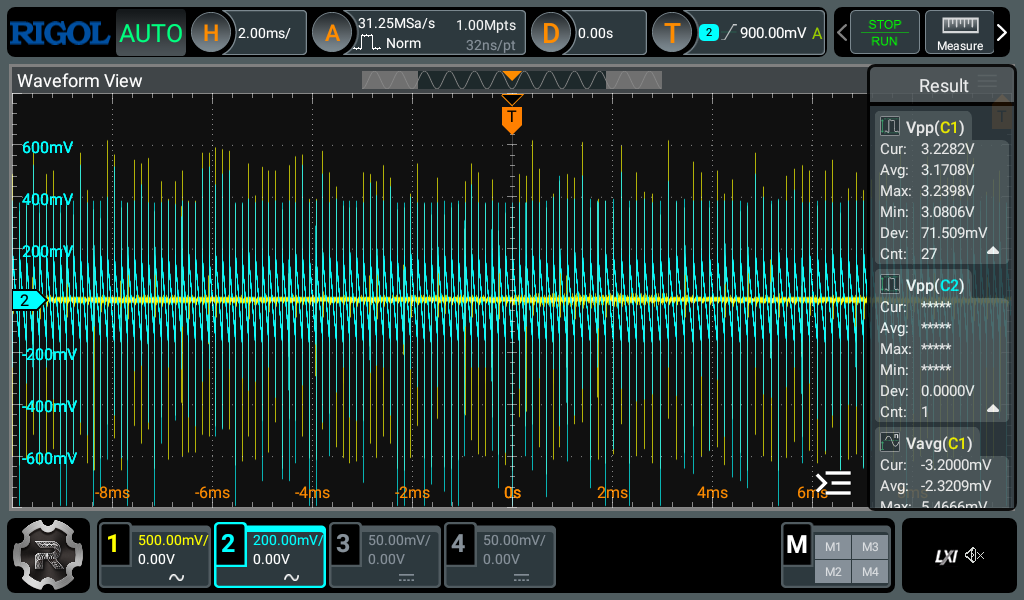
rainbow_hunt/captures/board3_AC_rails.png
