brbeardm/PelletPirate/rainbow_hunt/captures/board4_AC_rails.png

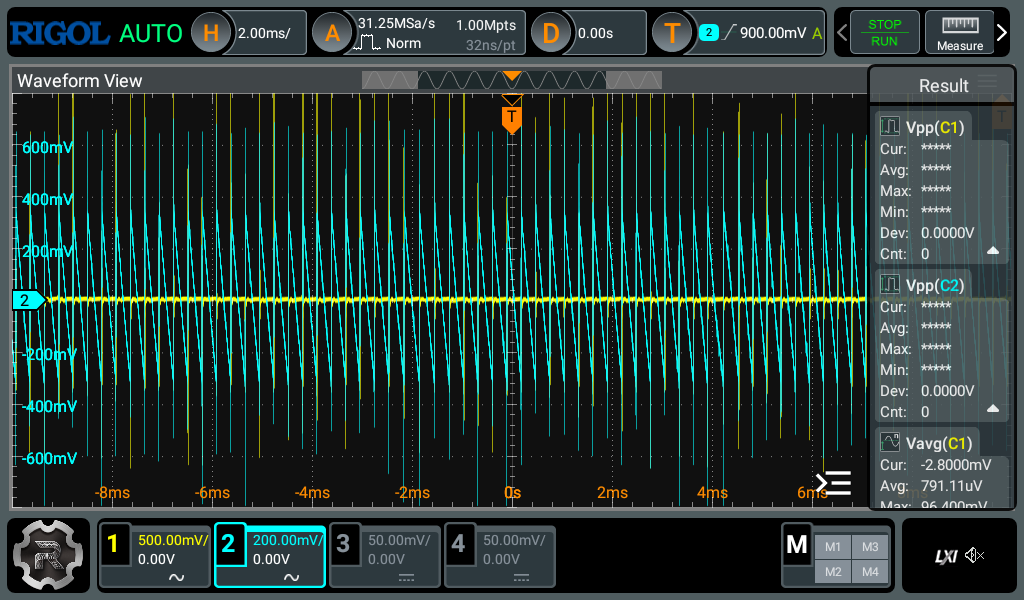
rainbow_hunt/captures/board4_AC_rails.png
