brbeardm/PelletPirate/rainbow_hunt/captures/board5_bench_dc.png

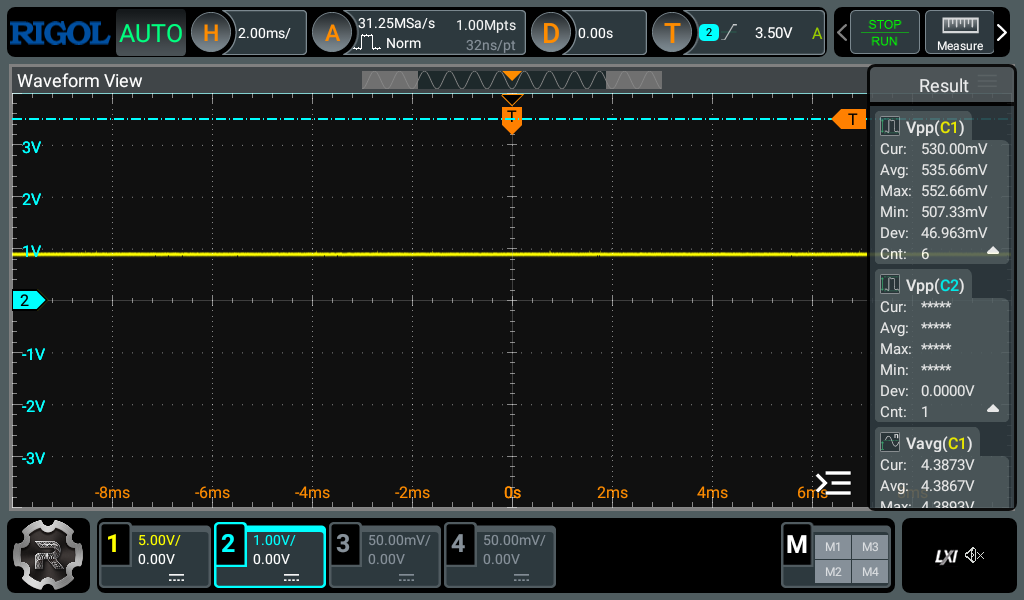
rainbow_hunt/captures/board5_bench_dc.png
