brbeardm/PelletPirate/rainbow_hunt/captures/board5_bodge_100uF.png

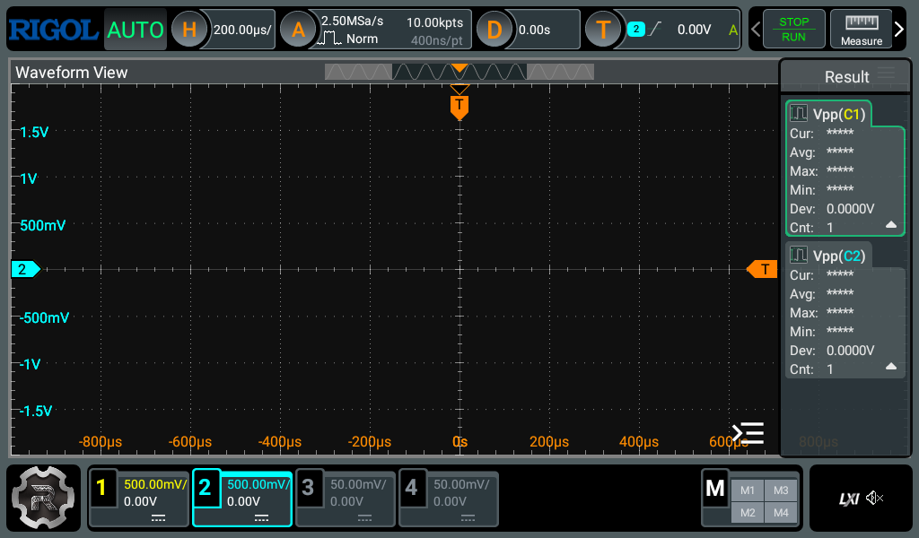
rainbow_hunt/captures/board5_bodge_100uF.png
