brbeardm/PelletPirate/rainbow_hunt/captures/board5_dc_contact_check.png

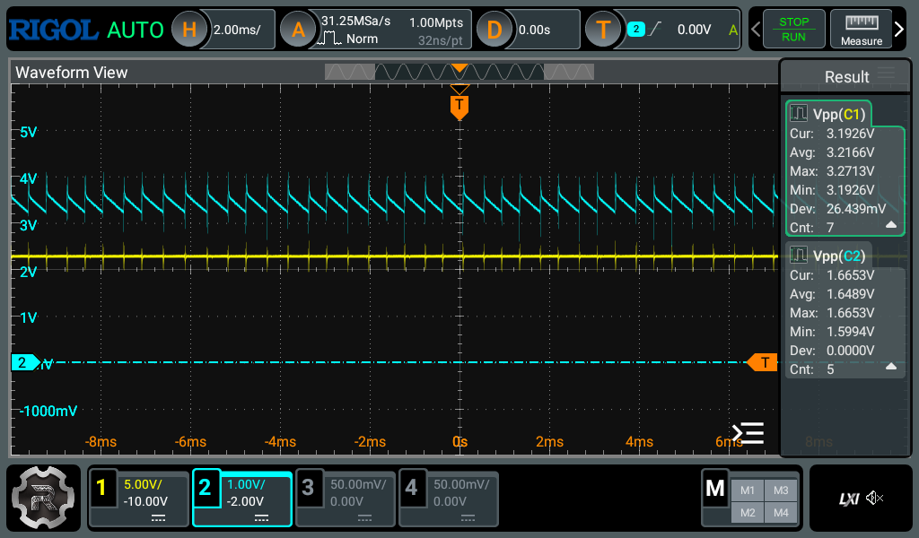
rainbow_hunt/captures/board5_dc_contact_check.png
