brbeardm/PelletPirate/rainbow_hunt/captures/dho814_ac_hunt_view.png

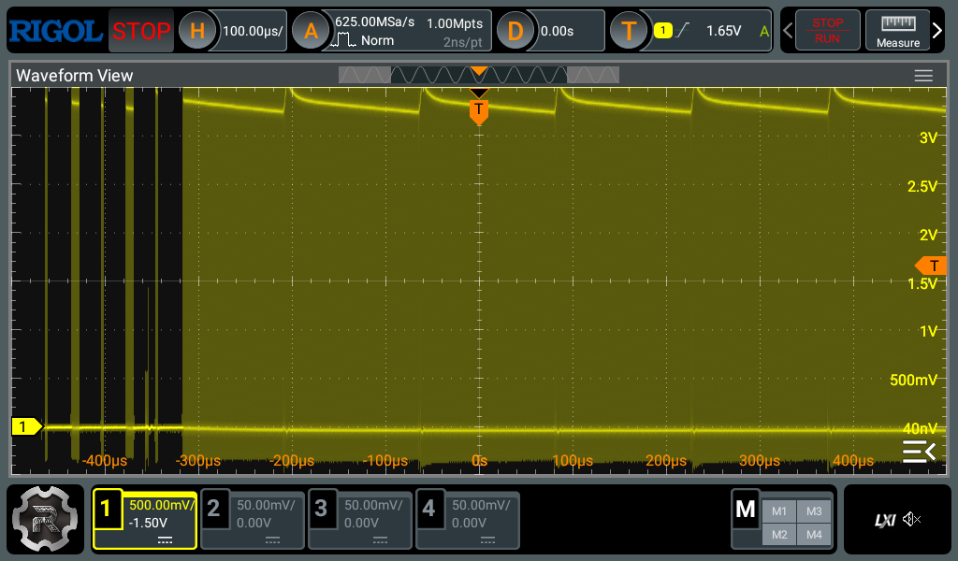
rainbow_hunt/captures/dho814_ac_hunt_view.png
