brbeardm/PelletPirate/rainbow_hunt/captures/dho814_runt_1.png

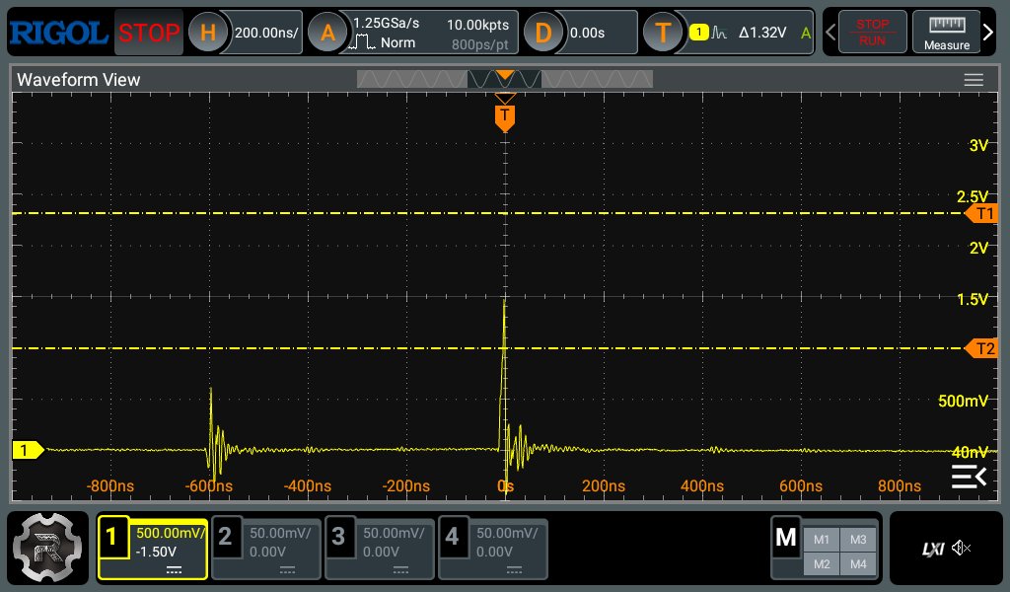
rainbow_hunt/captures/dho814_runt_1.png
