brbeardm/PelletPirate/rainbow_hunt/captures/dho814_runt_3.png

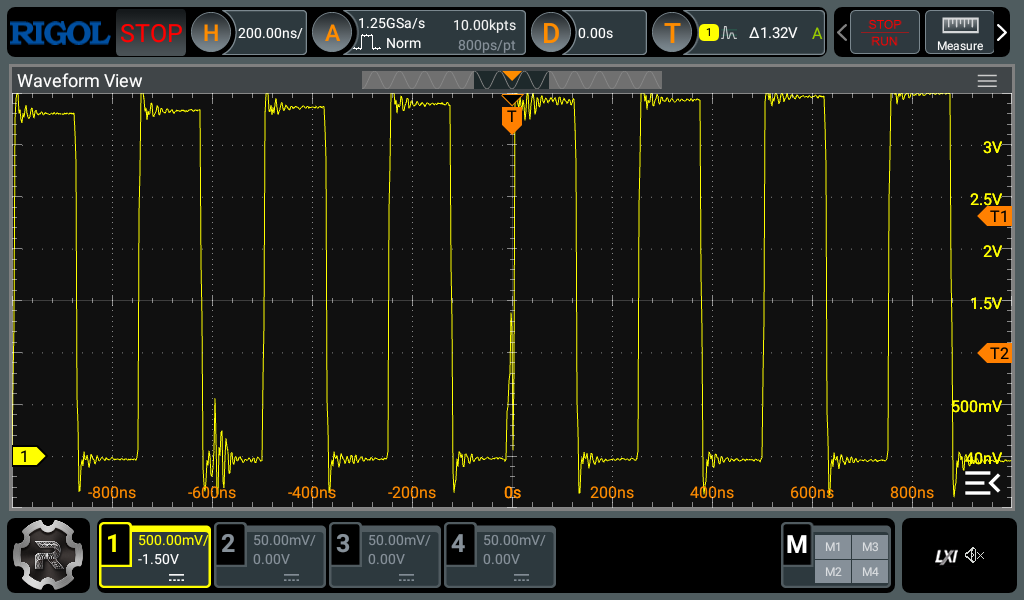
rainbow_hunt/captures/dho814_runt_3.png
