brbeardm/PelletPirate/rainbow_hunt/captures/dho814_runt_4.png

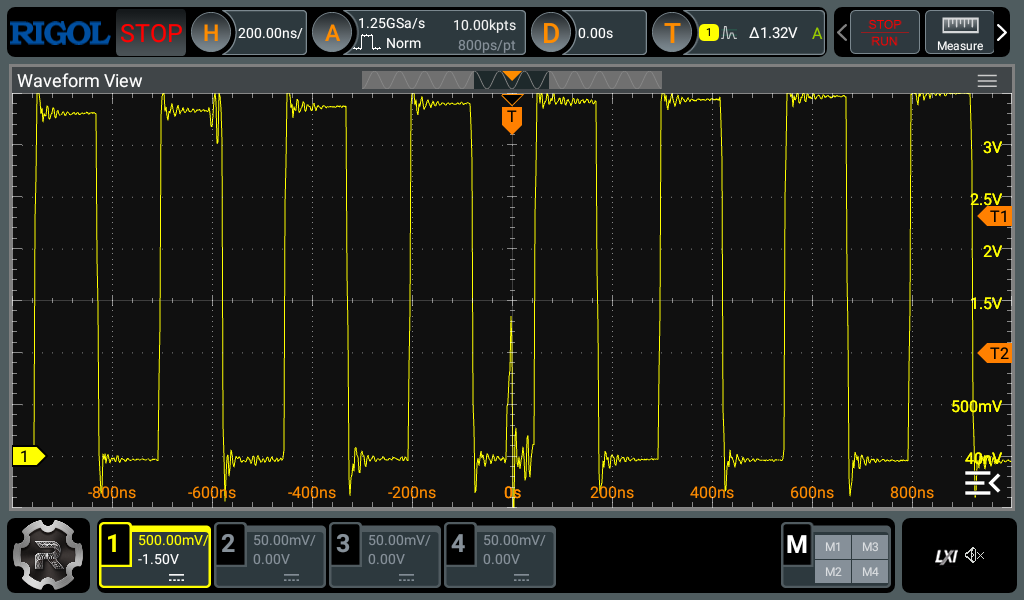
rainbow_hunt/captures/dho814_runt_4.png
