brbeardm/PelletPirate/rainbow_hunt/captures/dho814_runt_5.png

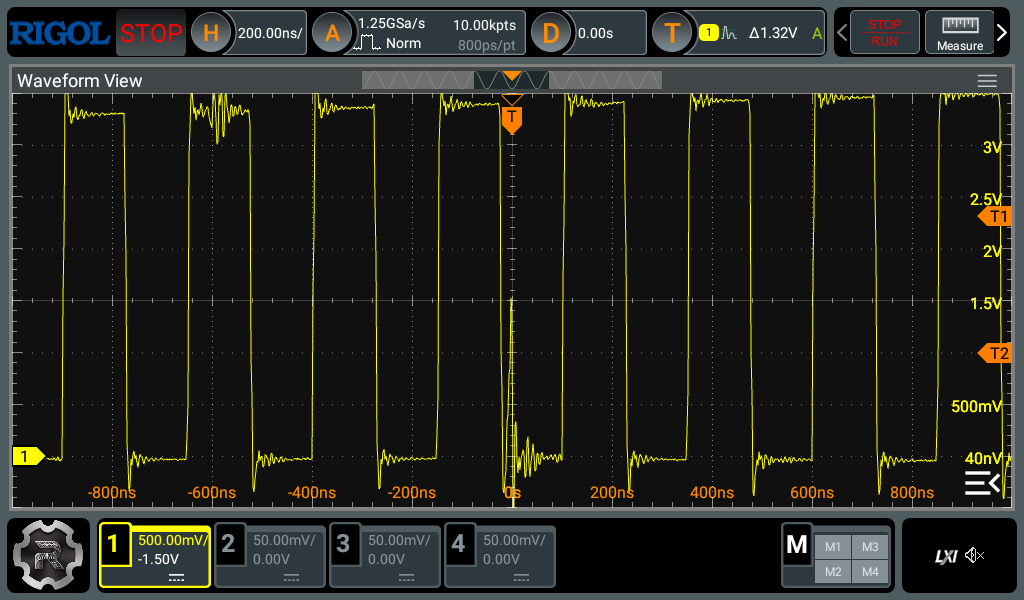
rainbow_hunt/captures/dho814_runt_5.png
