brbeardm/PelletPirate/rainbow_hunt/captures/dho814_runt_9.png

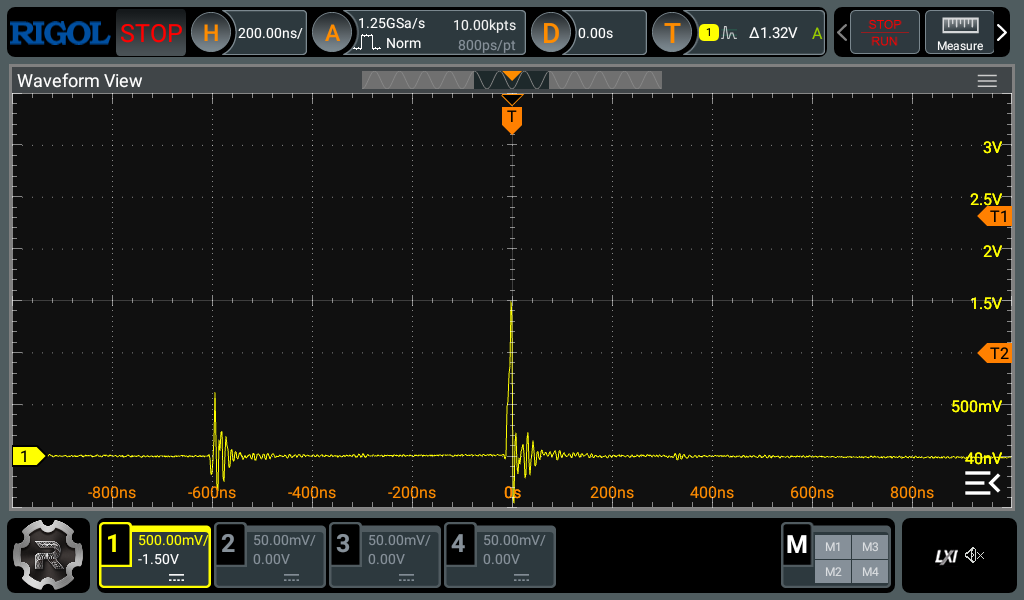
rainbow_hunt/captures/dho814_runt_9.png
