brbeardm/PelletPirate/rainbow_hunt/captures/dho814_runt_13.png

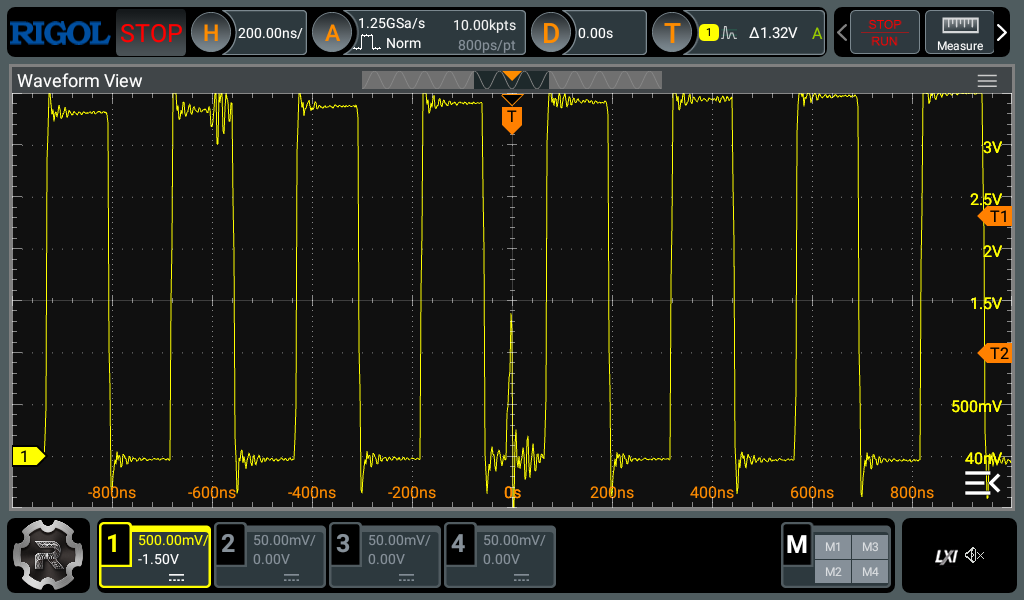
rainbow_hunt/captures/dho814_runt_13.png
