brbeardm/PelletPirate/rainbow_hunt/captures/dho814_runt_17.png

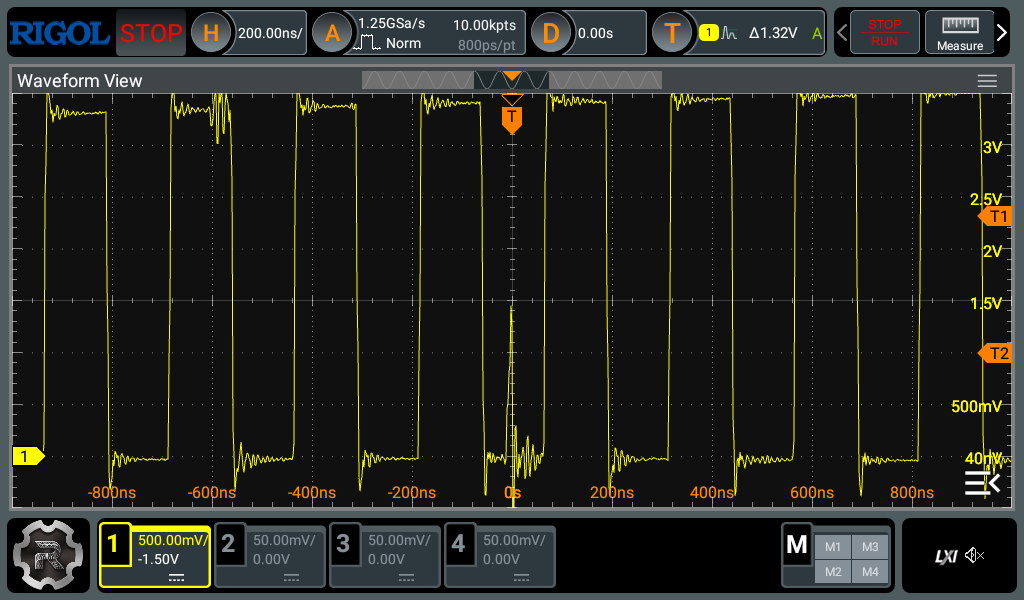
rainbow_hunt/captures/dho814_runt_17.png
