brbeardm/PelletPirate/rainbow_hunt/captures/dho814_runt_20.png

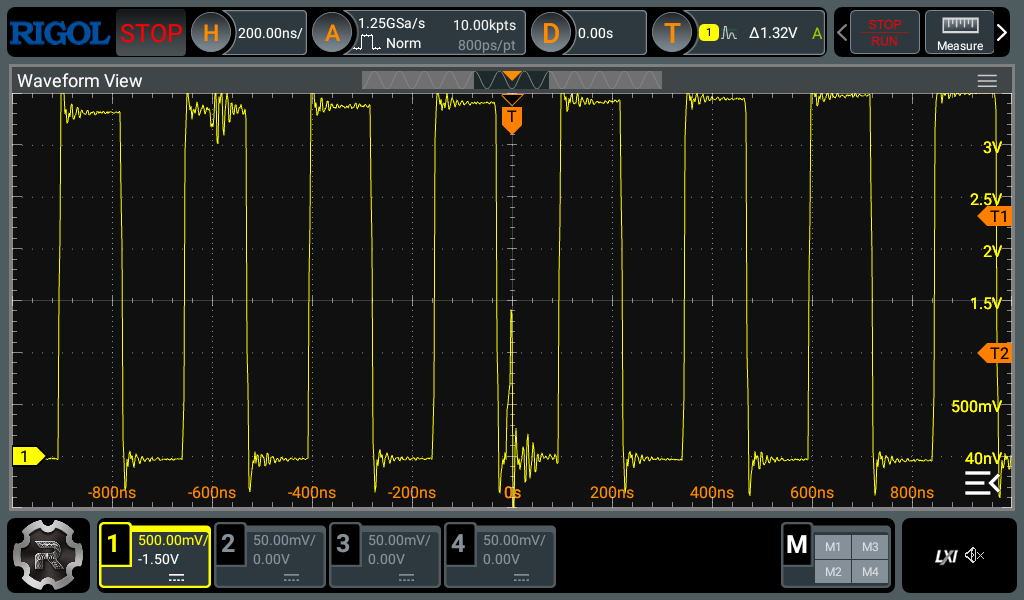
rainbow_hunt/captures/dho814_runt_20.png
