brbeardm/PelletPirate/rainbow_hunt/captures/dho814_runt_22.png

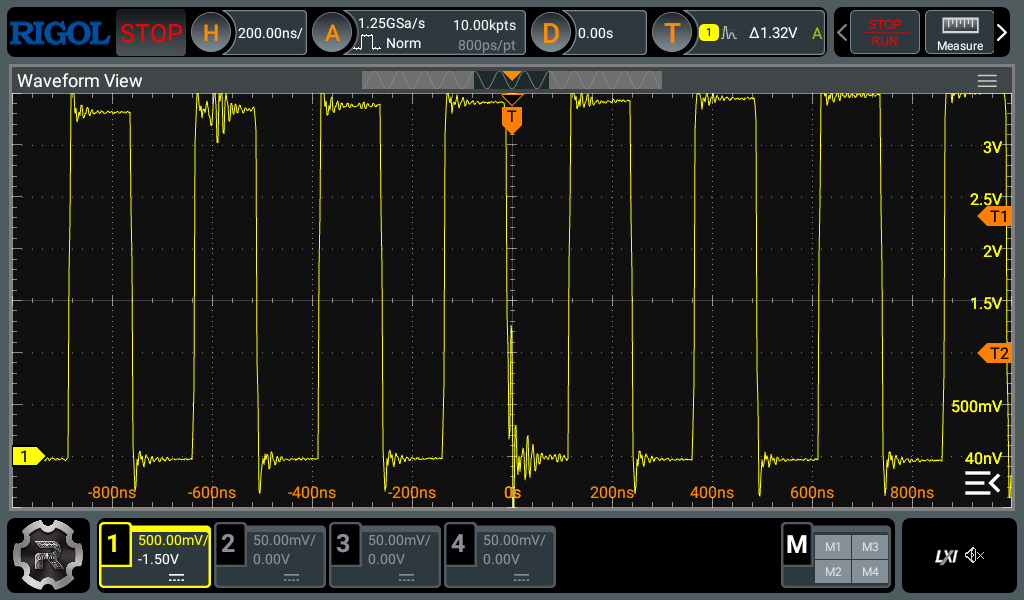
rainbow_hunt/captures/dho814_runt_22.png
