brbeardm/PelletPirate/rainbow_hunt/captures/dho814_runt_28.png

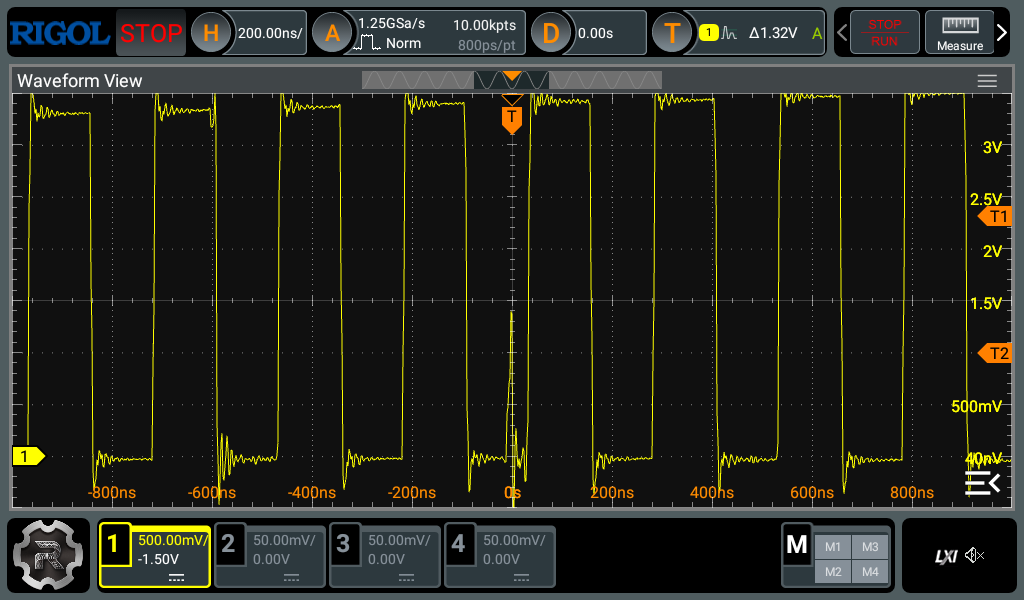
rainbow_hunt/captures/dho814_runt_28.png
