brbeardm/PelletPirate/rainbow_hunt/captures/dho814_runt_31.png

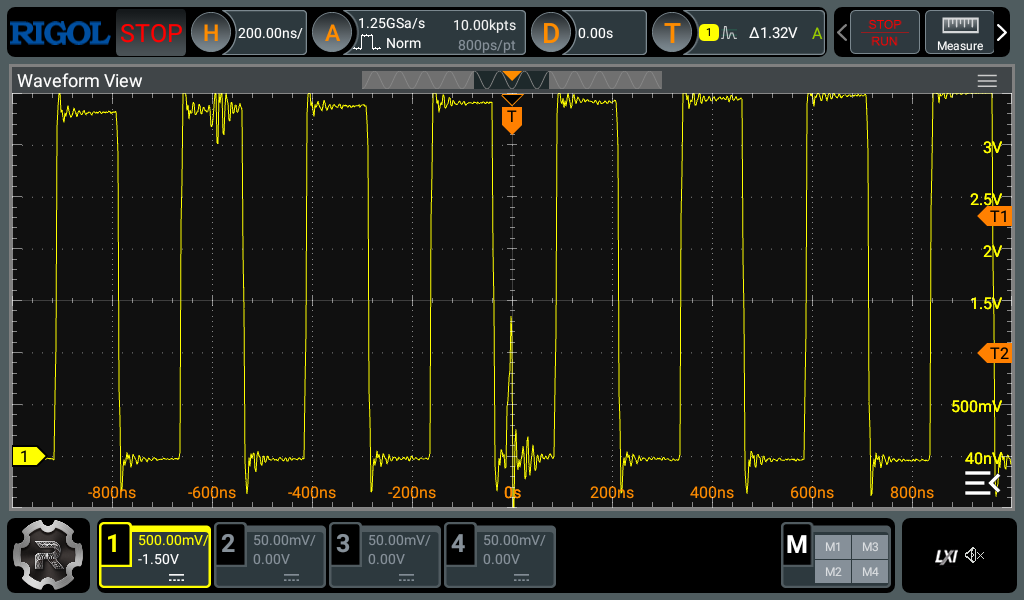
rainbow_hunt/captures/dho814_runt_31.png
