brbeardm/PelletPirate/rainbow_hunt/captures/dho814_runt_53.png

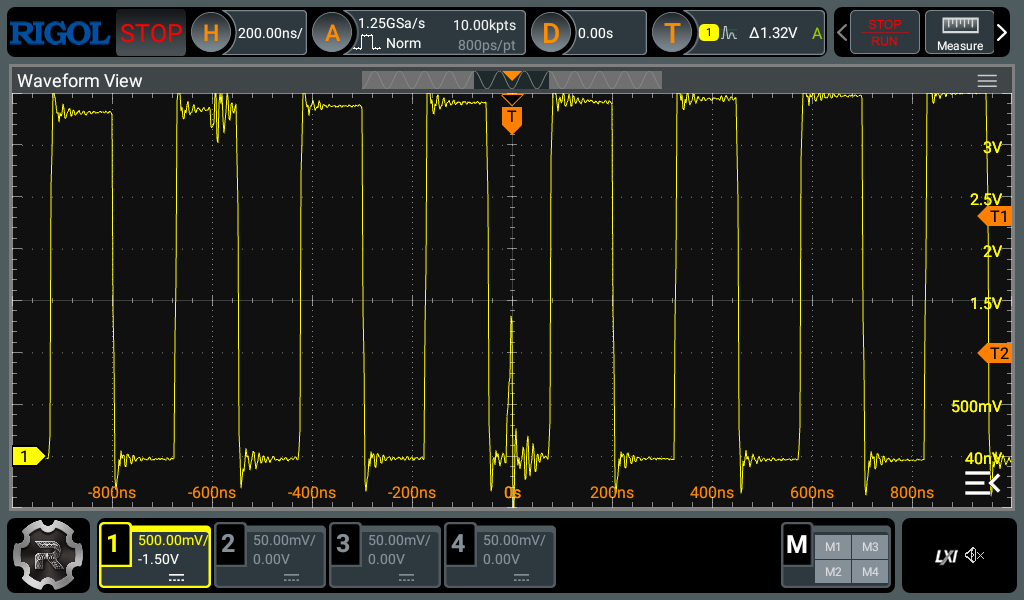
rainbow_hunt/captures/dho814_runt_53.png
