brbeardm/PelletPirate/rainbow_hunt/captures/dho814_runt_58.png

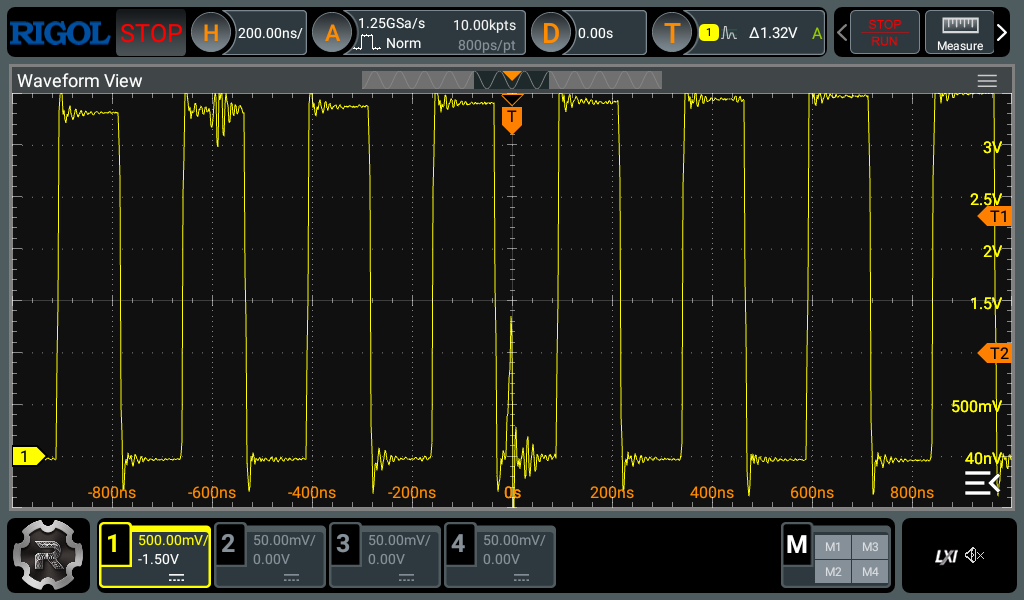
rainbow_hunt/captures/dho814_runt_58.png
