brbeardm/PelletPirate/rainbow_hunt/captures/dho814_runt_62.png

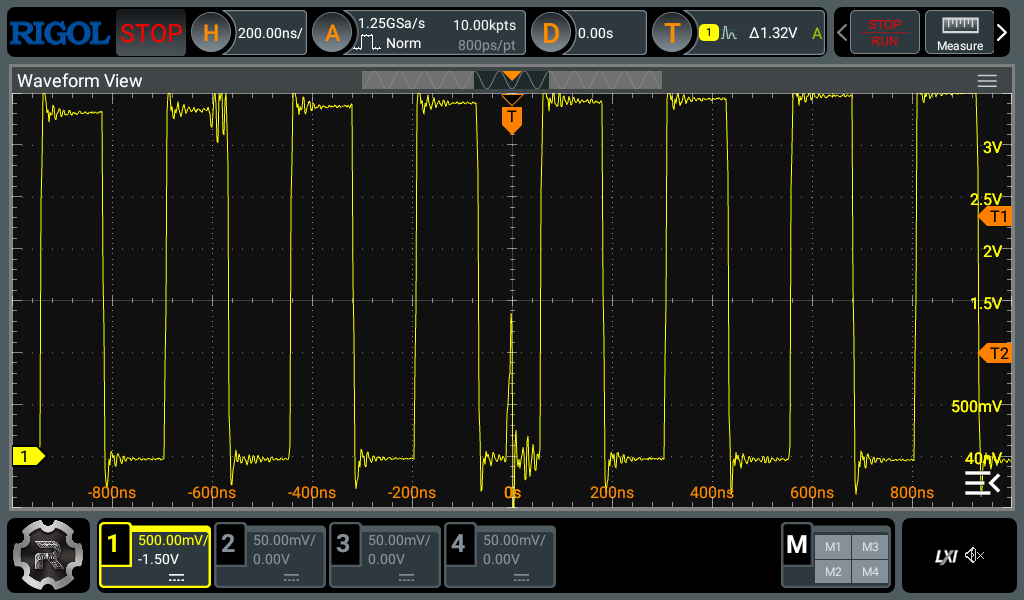
rainbow_hunt/captures/dho814_runt_62.png
