brbeardm/PelletPirate/rainbow_hunt/captures/dho814_runt_66.png

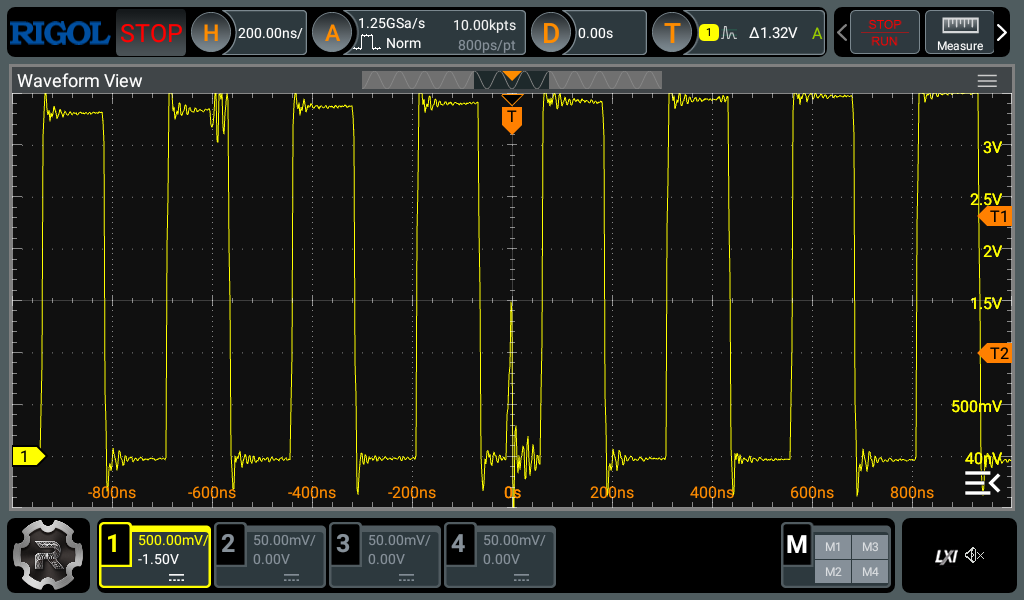
rainbow_hunt/captures/dho814_runt_66.png
