brbeardm/PelletPirate/rainbow_hunt/captures/dho814_runt_86.png

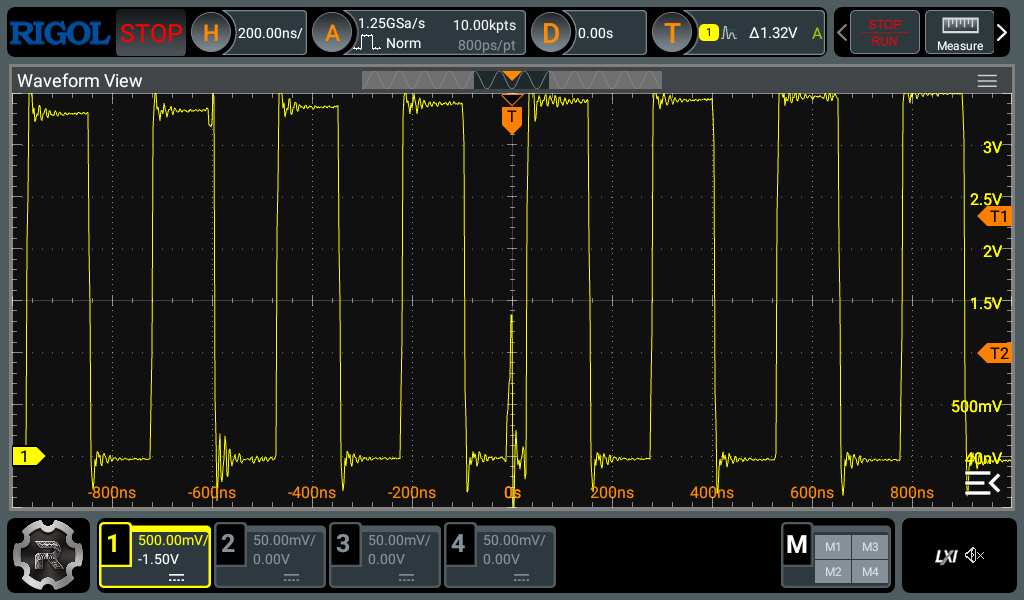
rainbow_hunt/captures/dho814_runt_86.png
