brbeardm/PelletPirate/rainbow_hunt/captures/dho814_runt_108.png

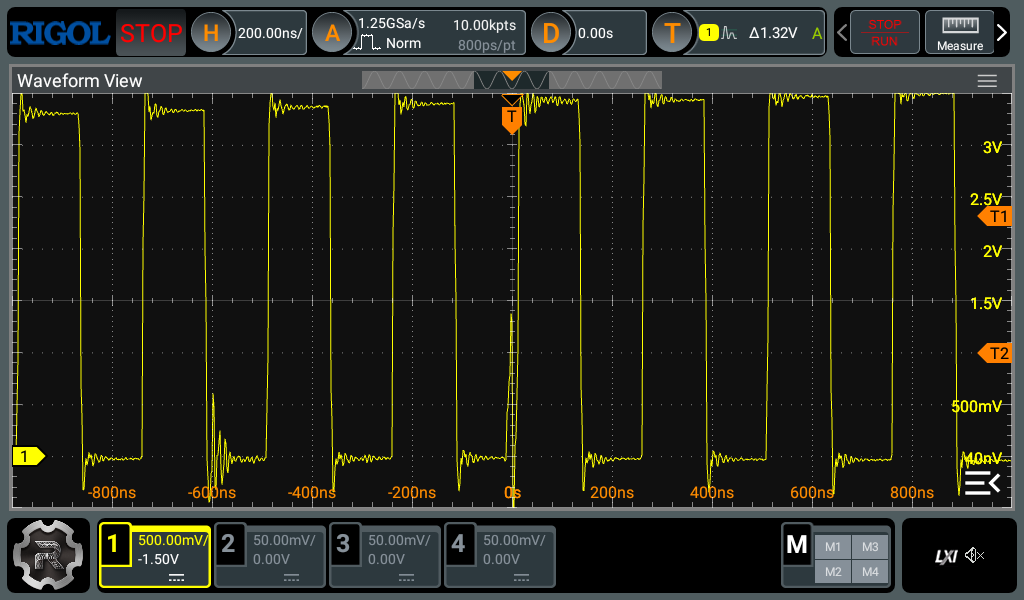
rainbow_hunt/captures/dho814_runt_108.png
