brbeardm/PelletPirate/rainbow_hunt/captures/mho954_ac_hunt_view.png

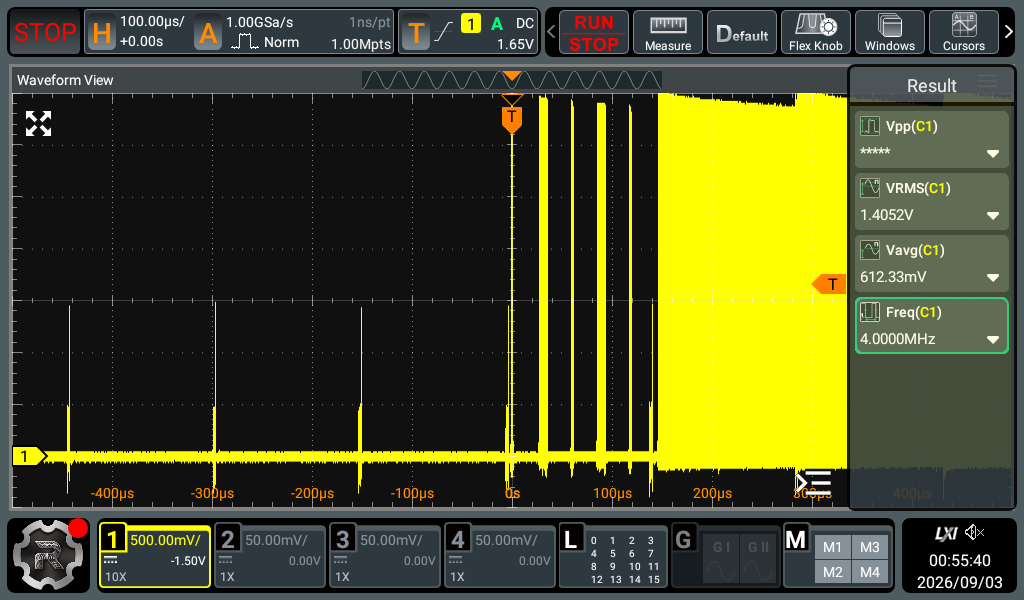
rainbow_hunt/captures/mho954_ac_hunt_view.png
