brbeardm/PelletPirate/rainbow_hunt/captures/mho954_probe_comp_ch1.png

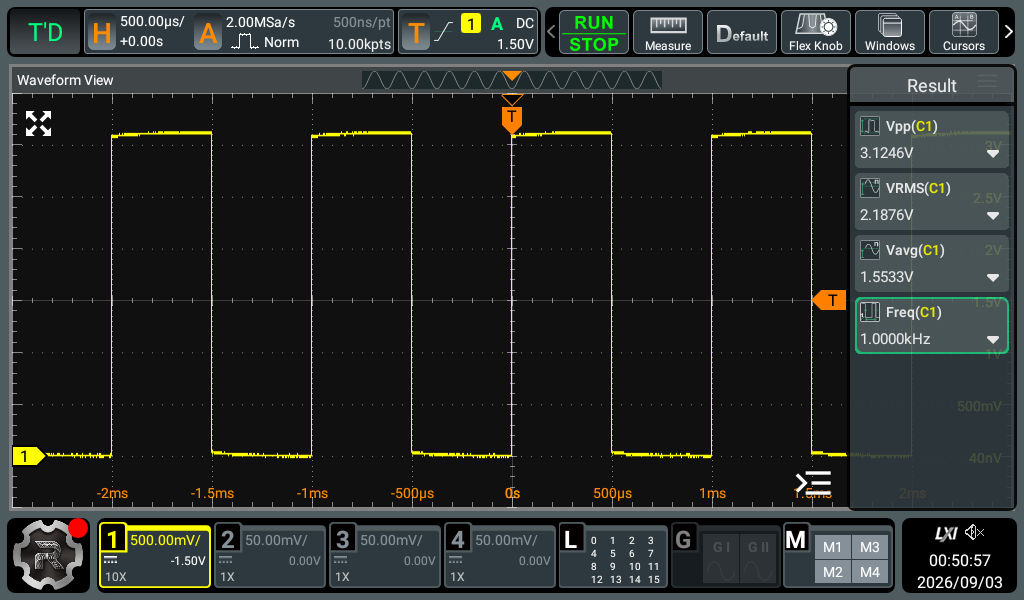
rainbow_hunt/captures/mho954_probe_comp_ch1.png
