brbeardm/PelletPirate/rainbow_hunt/captures/mho954_probe_comp_corner2.png

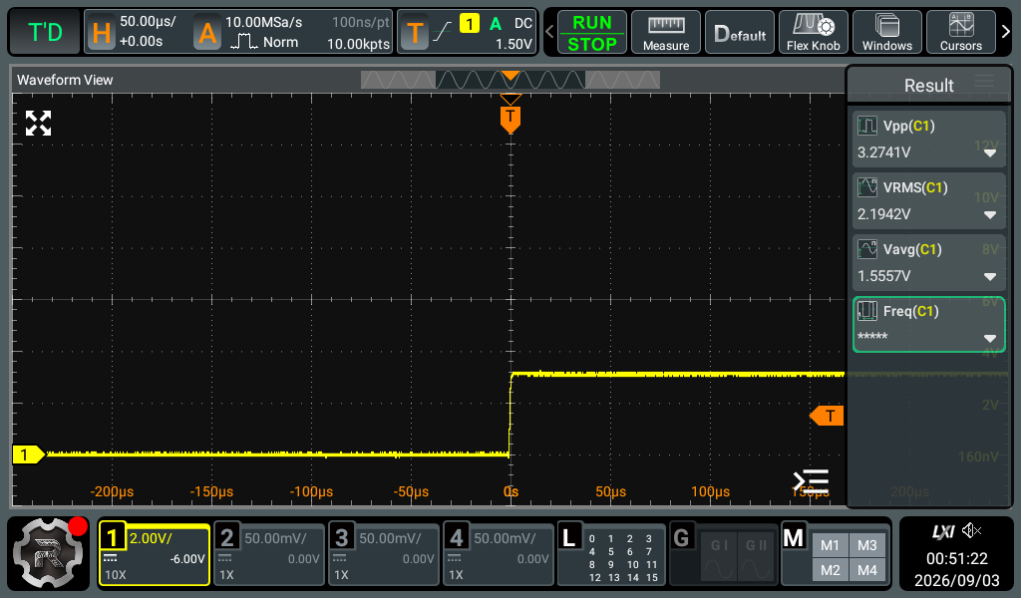
rainbow_hunt/captures/mho954_probe_comp_corner2.png
