brbeardm/PelletPirate/rainbow_hunt/captures/probe_comp_take2.png

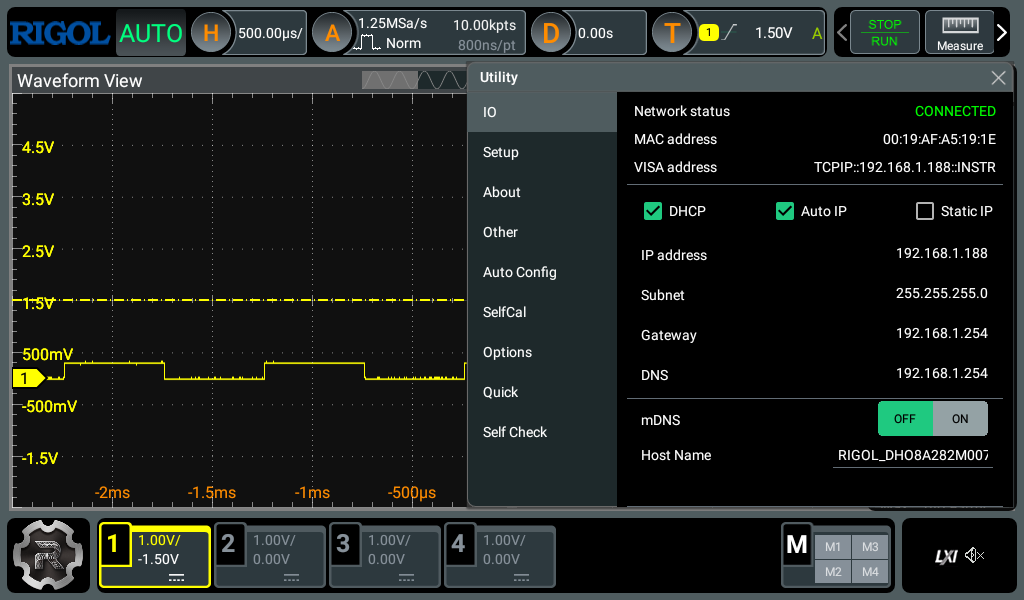
rainbow_hunt/captures/probe_comp_take2.png
