brbeardm/PelletPirate/rainbow_hunt/captures/probe_comp_take3.png

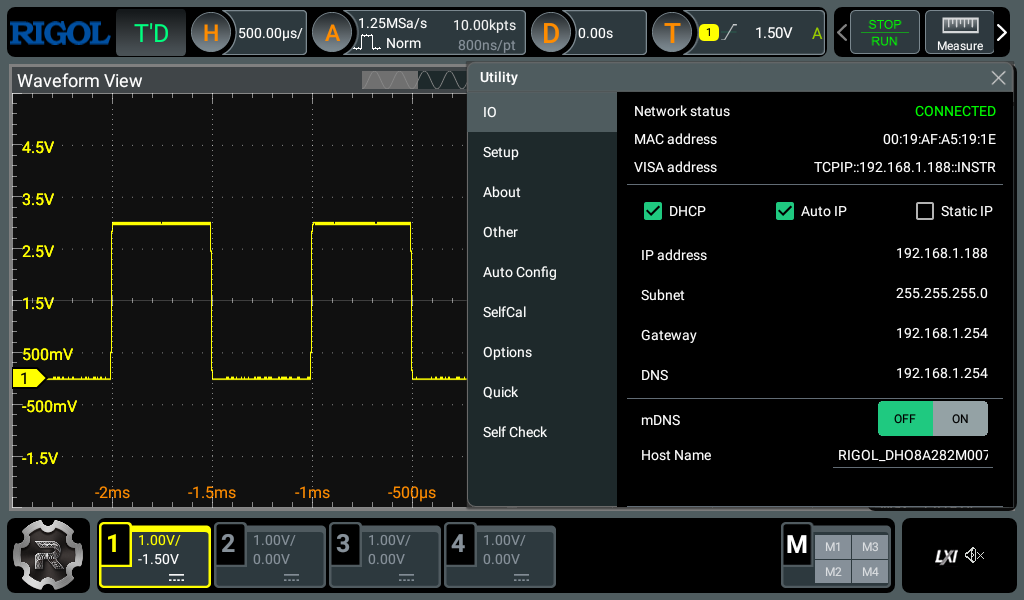
rainbow_hunt/captures/probe_comp_take3.png
