brbeardm/PelletPirate/rainbow_hunt/captures/runt_catch_1.png

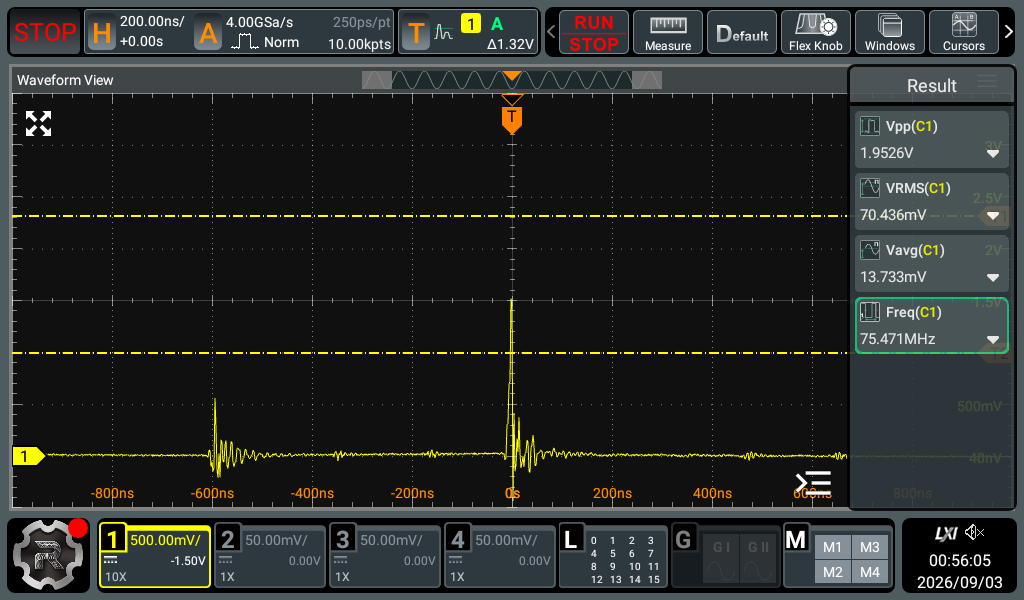
rainbow_hunt/captures/runt_catch_1.png
