brbeardm/PelletPirate/rainbow_hunt/captures/runt_catch_7.png

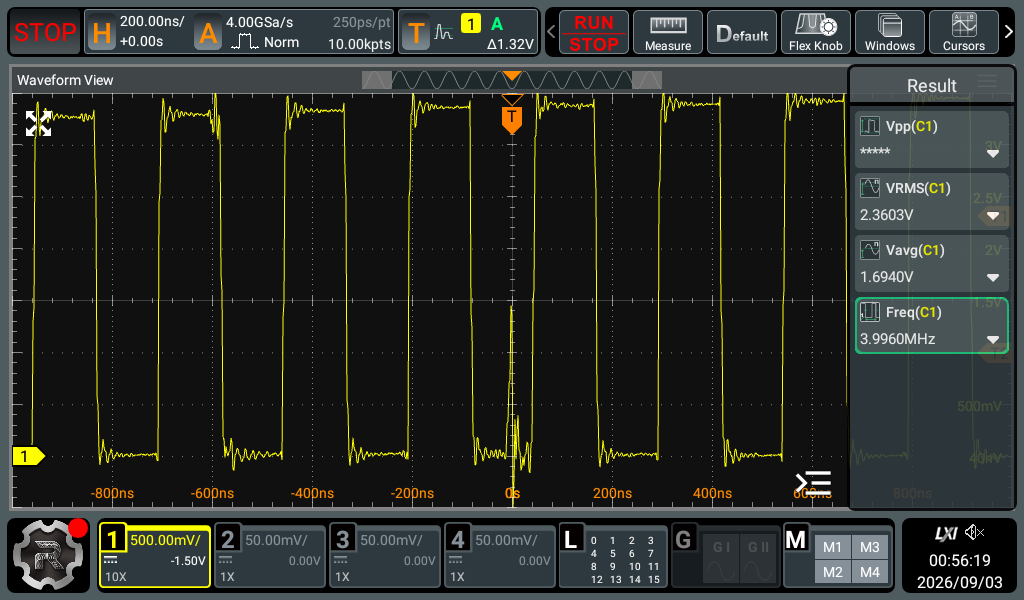
rainbow_hunt/captures/runt_catch_7.png
