brbeardm/PelletPirate/rainbow_hunt/captures/runt_catch_8.png

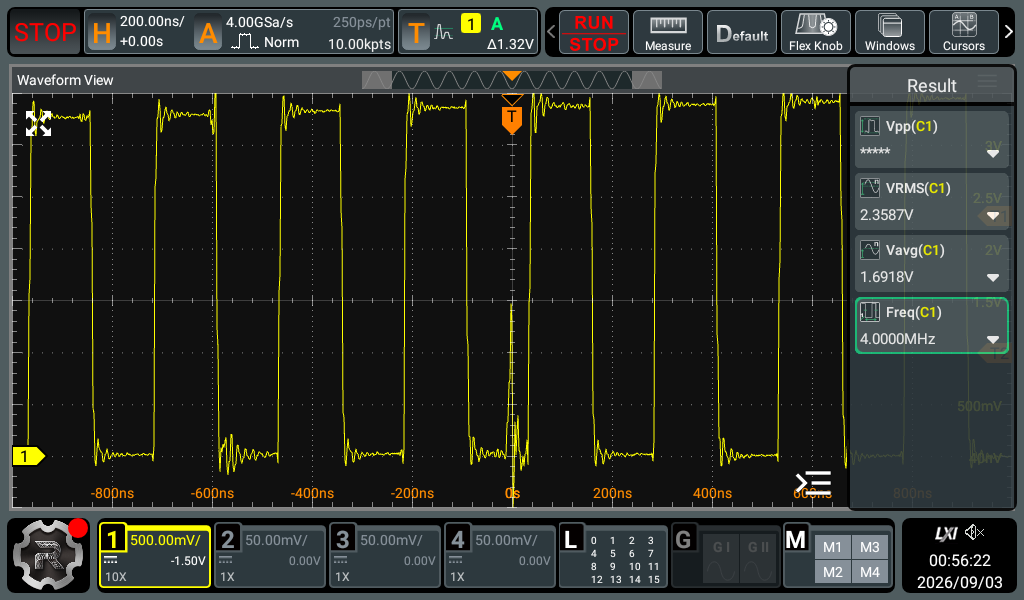
rainbow_hunt/captures/runt_catch_8.png
