brbeardm/PelletPirate/rainbow_hunt/captures/runt_catch_10.png

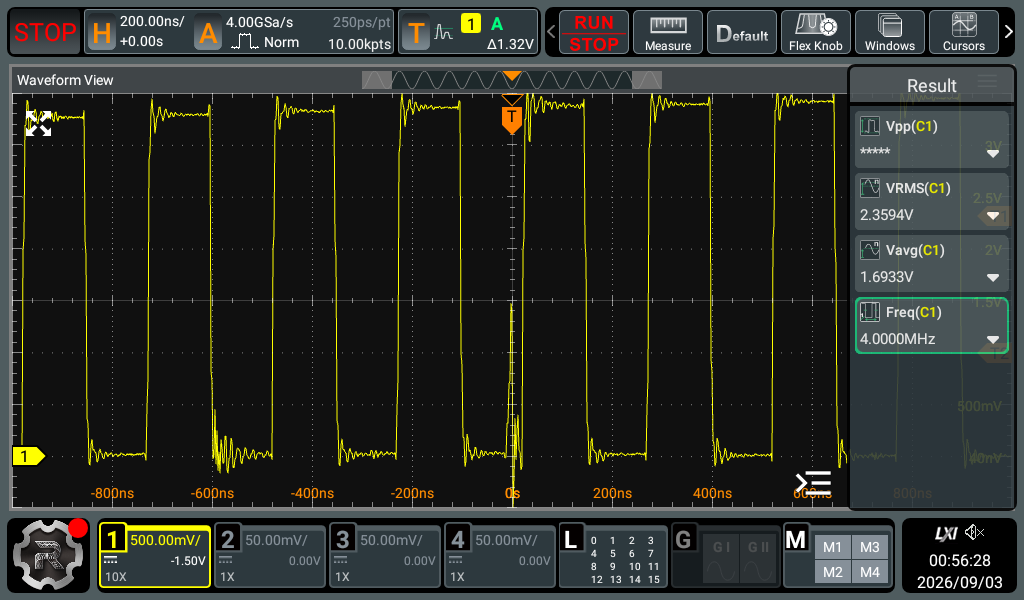
rainbow_hunt/captures/runt_catch_10.png
