brbeardm/PelletPirate/rainbow_hunt/captures/runt_catch_11.png

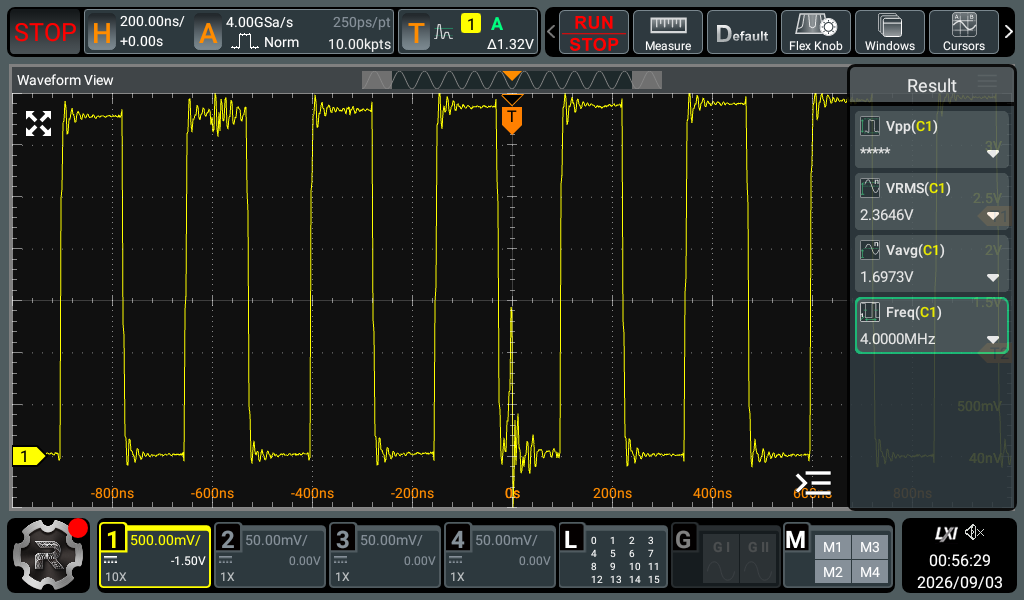
rainbow_hunt/captures/runt_catch_11.png
