brbeardm/PelletPirate/rainbow_hunt/captures/runt_catch_14.png

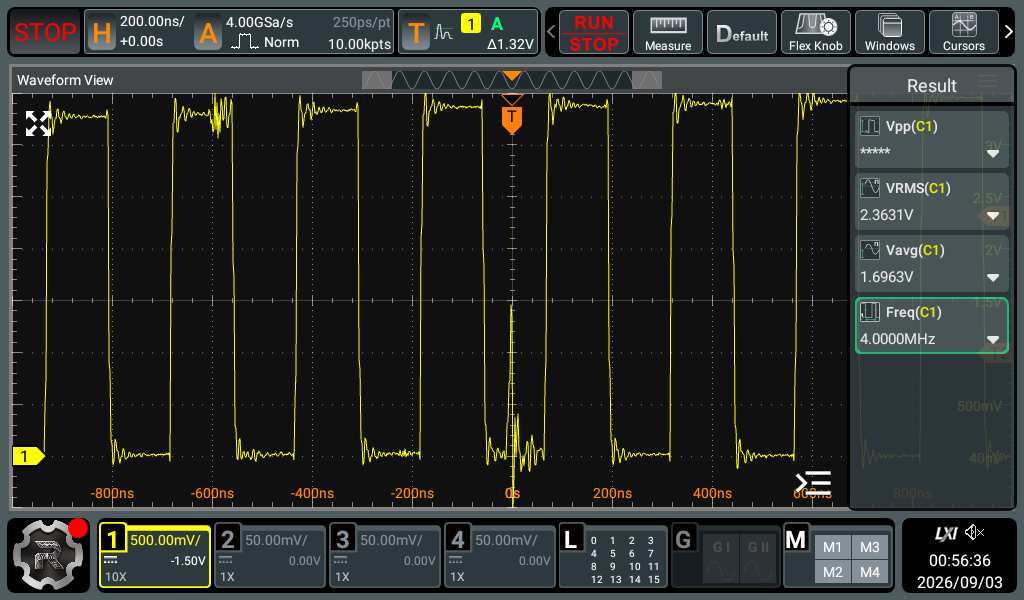
rainbow_hunt/captures/runt_catch_14.png
