brbeardm/PelletPirate/rainbow_hunt/captures/runt_catch_16.png

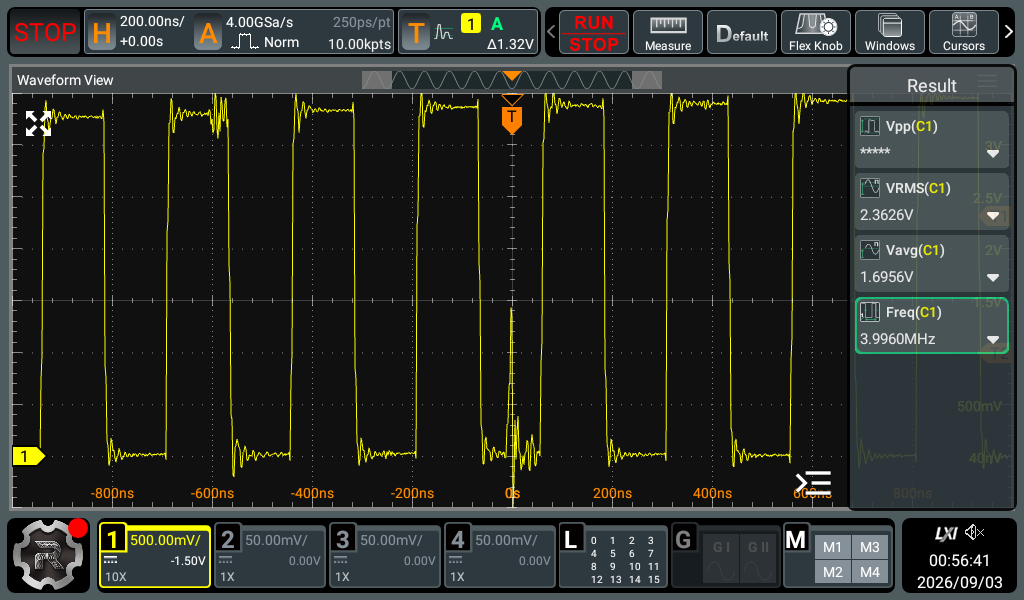
rainbow_hunt/captures/runt_catch_16.png
