brbeardm/PelletPirate/rainbow_hunt/captures/runt_catch_25.png

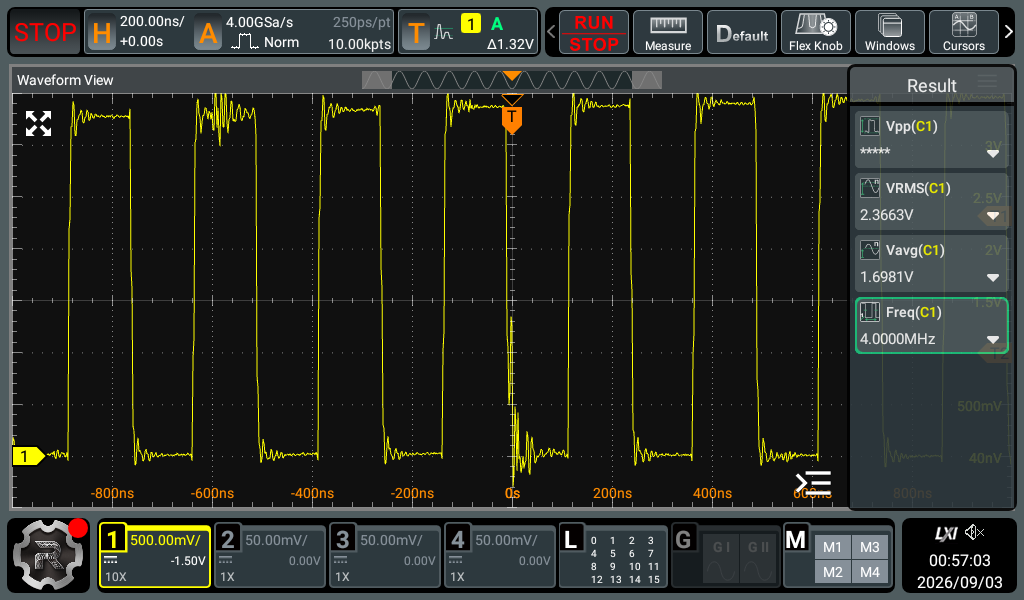
rainbow_hunt/captures/runt_catch_25.png
