brbeardm/PelletPirate/rainbow_hunt/captures/runt_catch_30.png

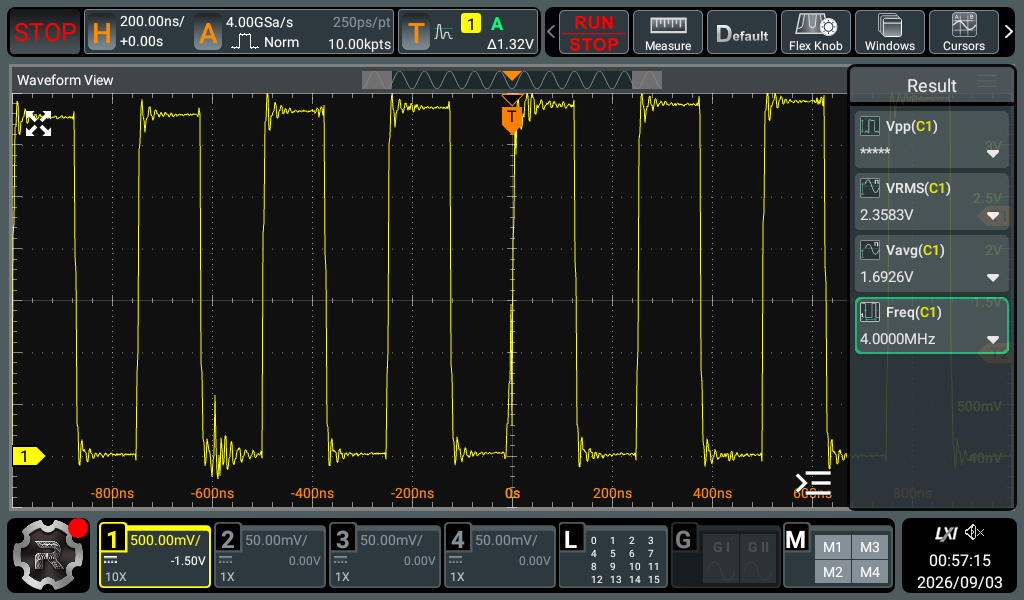
rainbow_hunt/captures/runt_catch_30.png
