brbeardm/PelletPirate/rainbow_hunt/captures/runt_catch_31.png

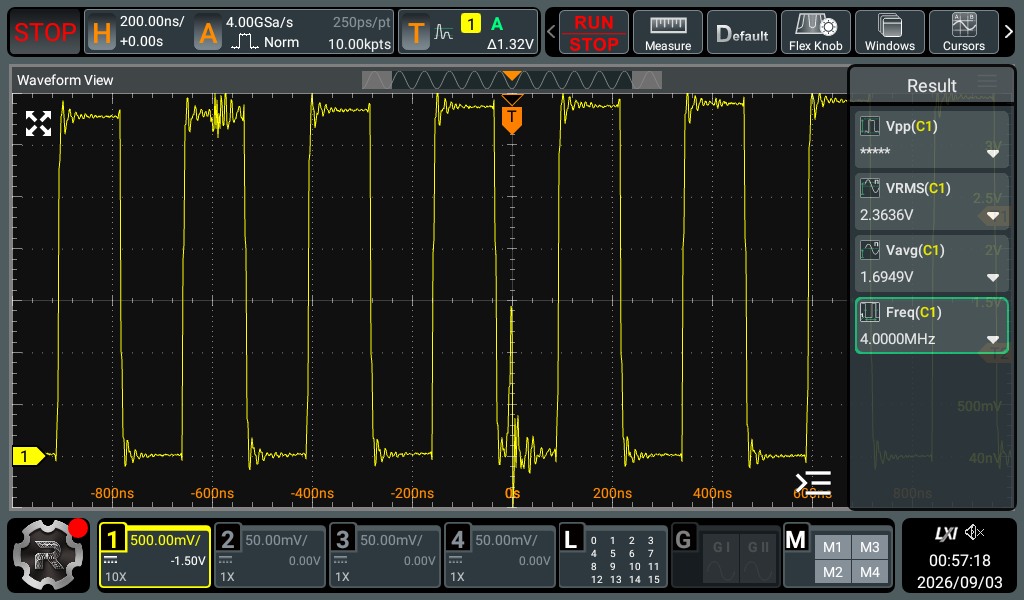
rainbow_hunt/captures/runt_catch_31.png
