brbeardm/PelletPirate/rainbow_hunt/captures/runt_catch_42.png

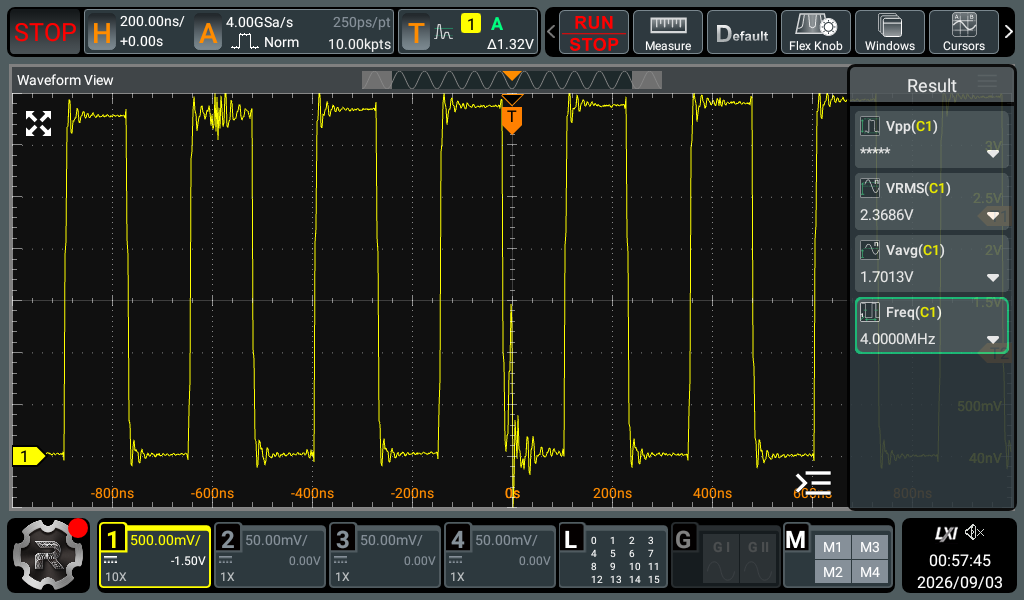
rainbow_hunt/captures/runt_catch_42.png
