brbeardm/PelletPirate/rainbow_hunt/captures/runt_catch_61.png

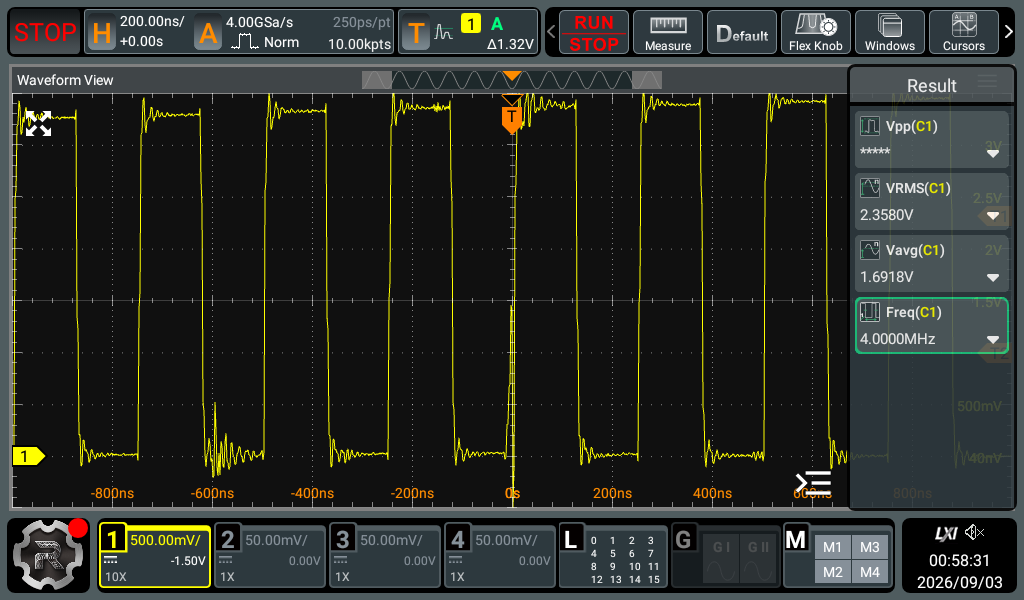
rainbow_hunt/captures/runt_catch_61.png
