brbeardm/PelletPirate/rainbow_hunt/captures/runt_catch_95.png

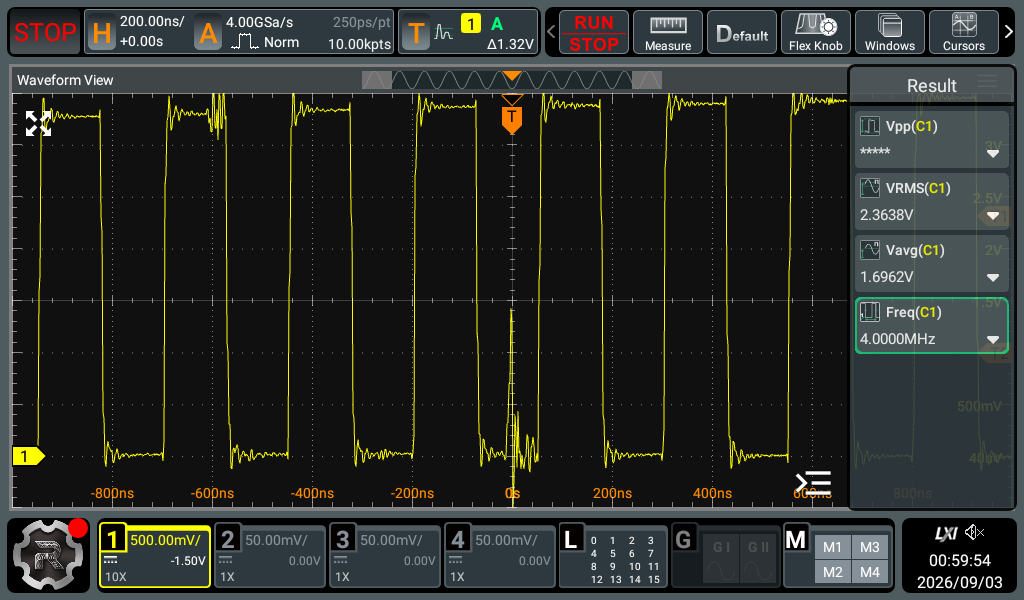
rainbow_hunt/captures/runt_catch_95.png
