brbeardm/PelletPirate/rainbow_hunt/captures/runt_catch_96.png

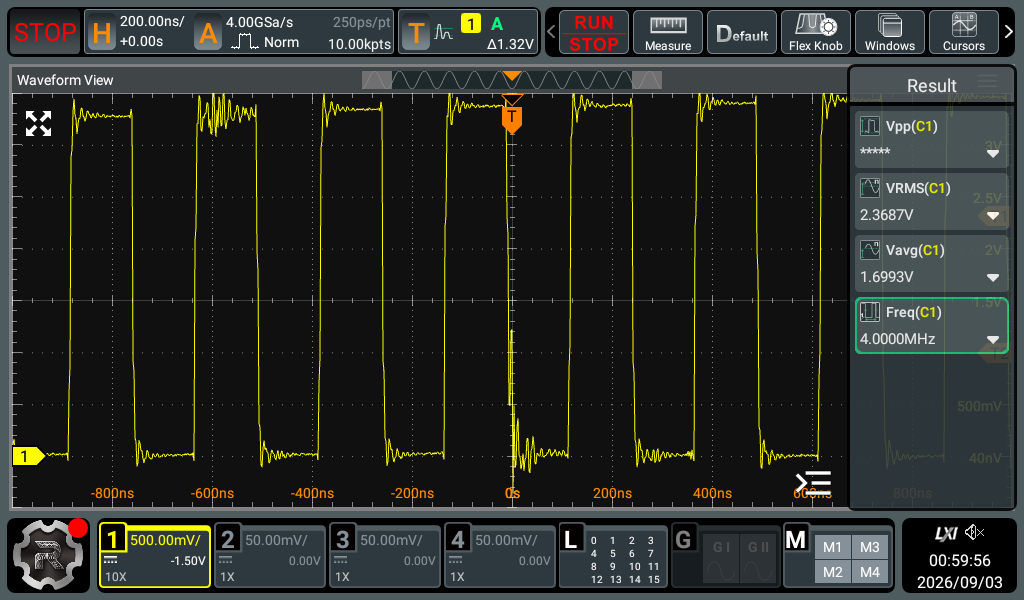
rainbow_hunt/captures/runt_catch_96.png
