brbeardm/PelletPirate/rainbow_hunt/captures/spike_context_view.png

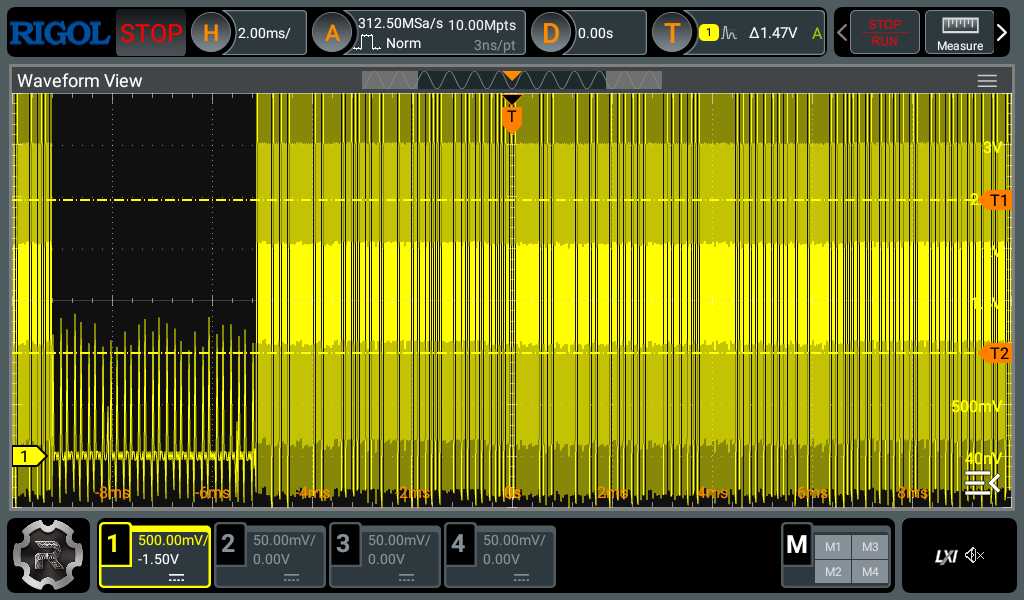
rainbow_hunt/captures/spike_context_view.png
