brbeardm/PelletPirate/rainbow_hunt/captures/tb002_p1.png

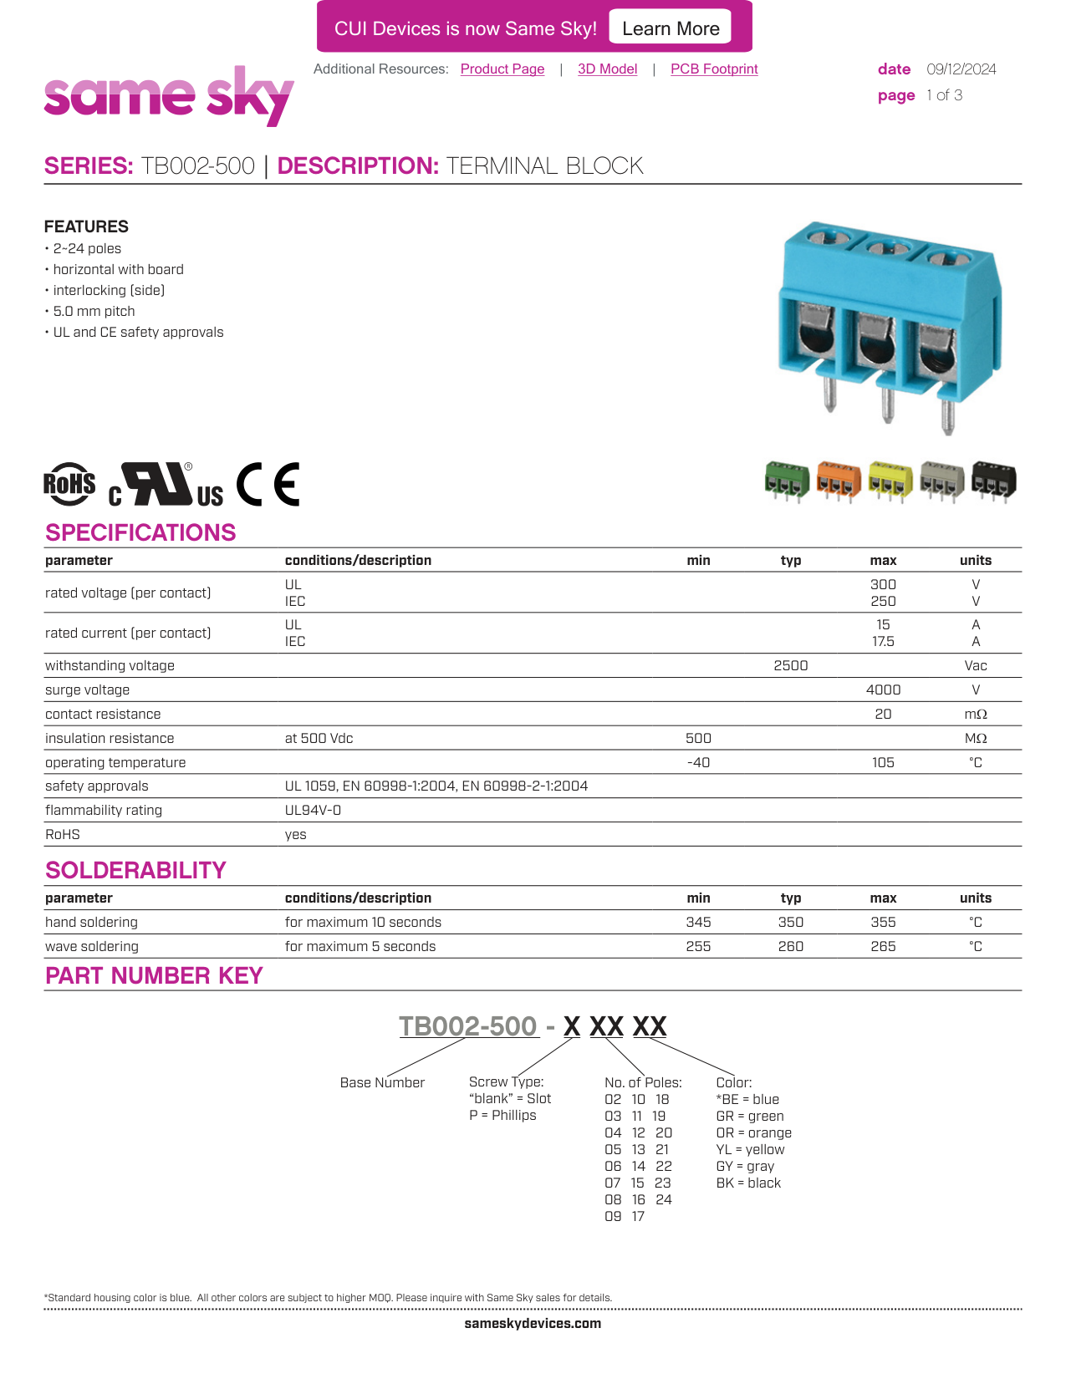
rainbow_hunt/captures/tb002_p1.png
