brbeardm/PelletPirate/rainbow_hunt/captures/tb002_p2.png

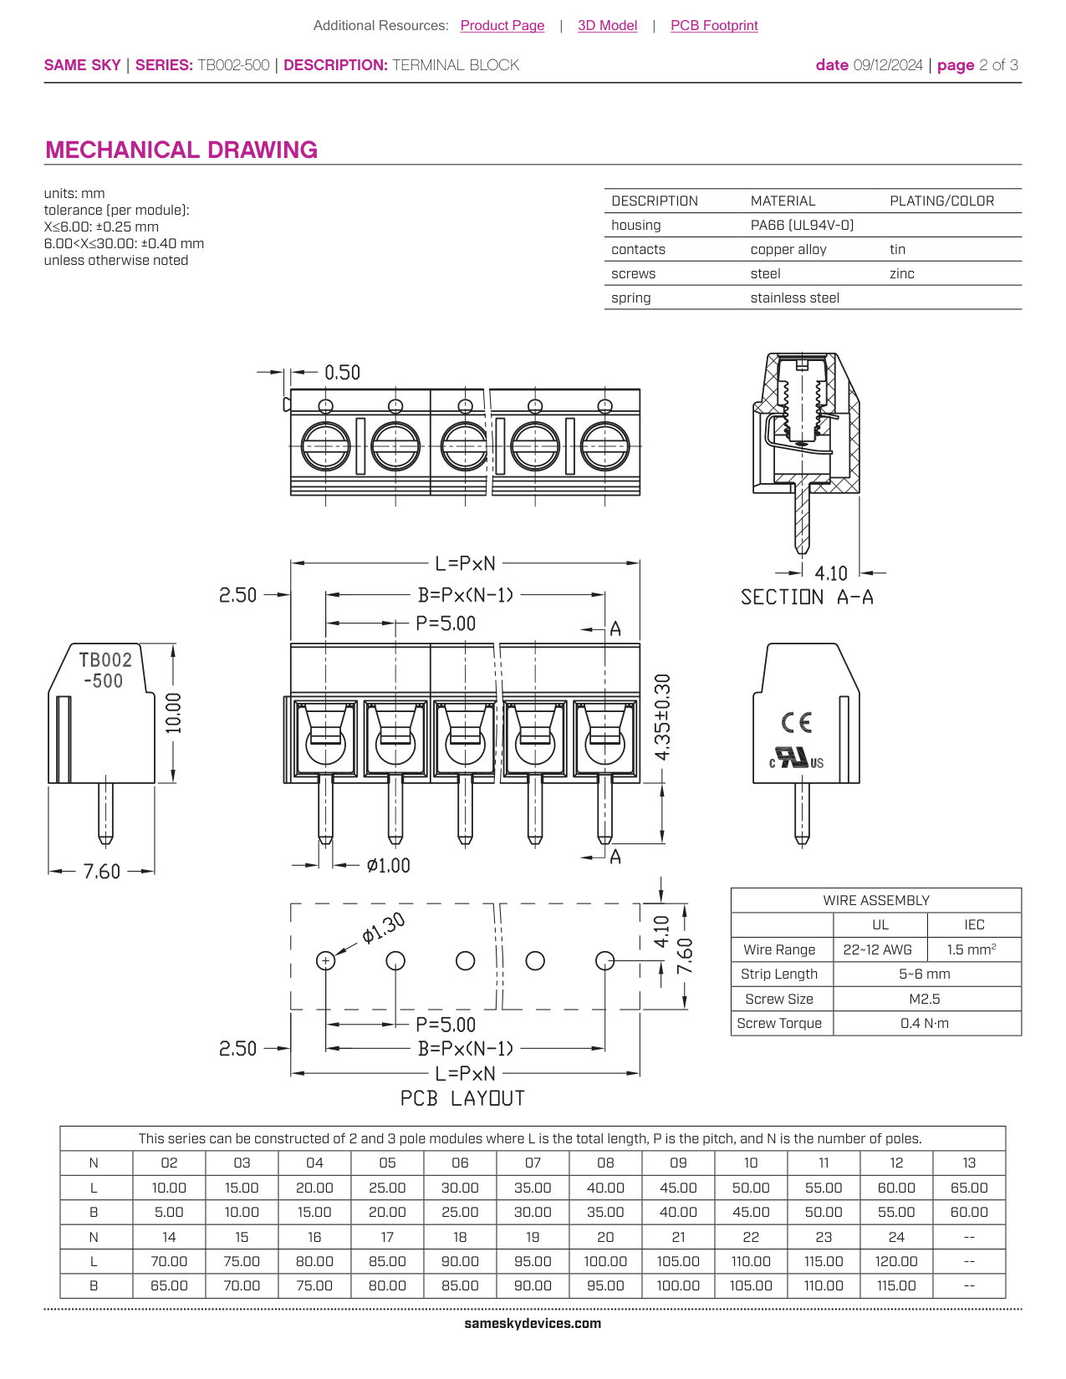
rainbow_hunt/captures/tb002_p2.png
