brbeardm/PelletPirate/rainbow_hunt/captures/tb002_sectionAA.png

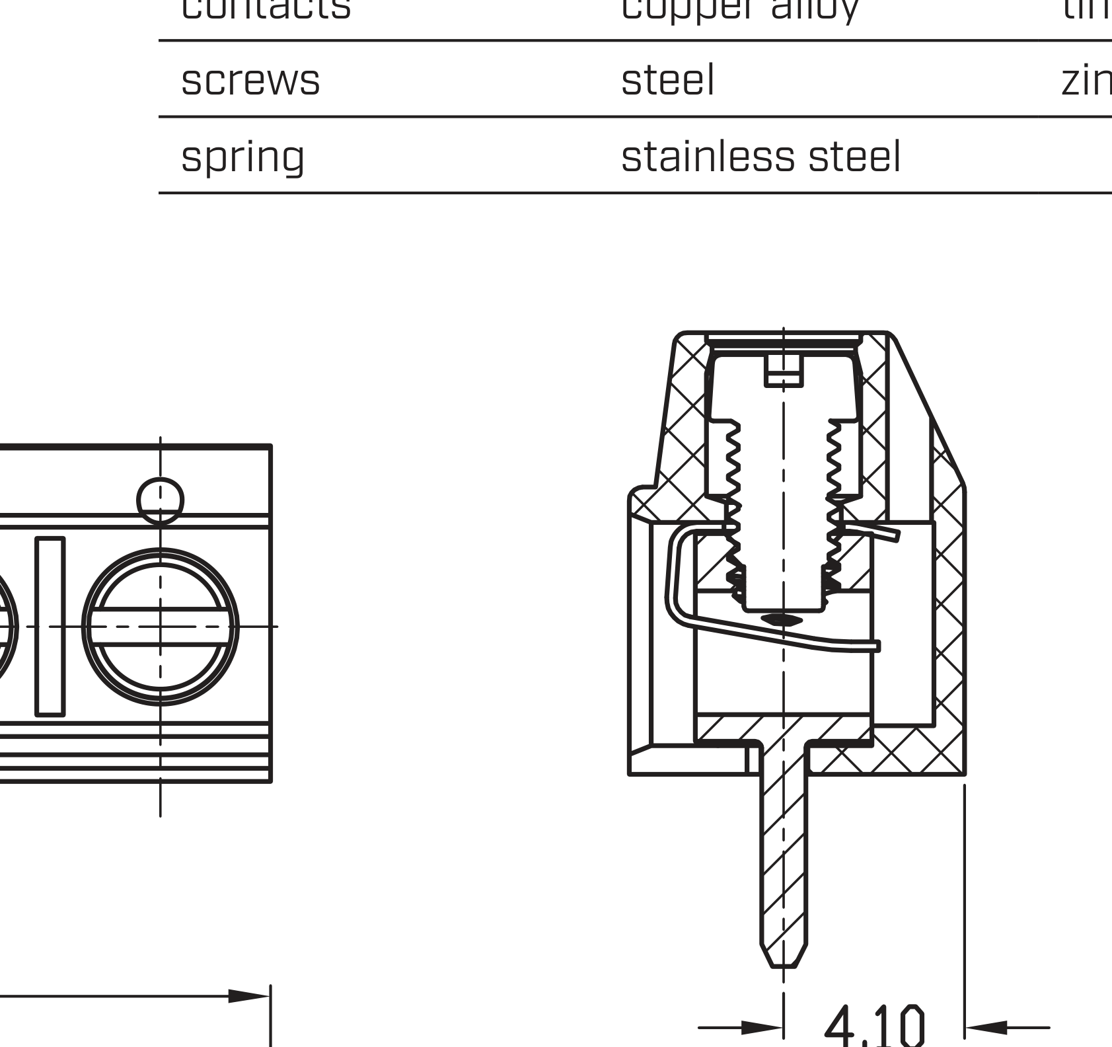
rainbow_hunt/captures/tb002_sectionAA.png
