brbeardm/PelletPirate/rainbow_hunt/captures/tb002_zoom.png

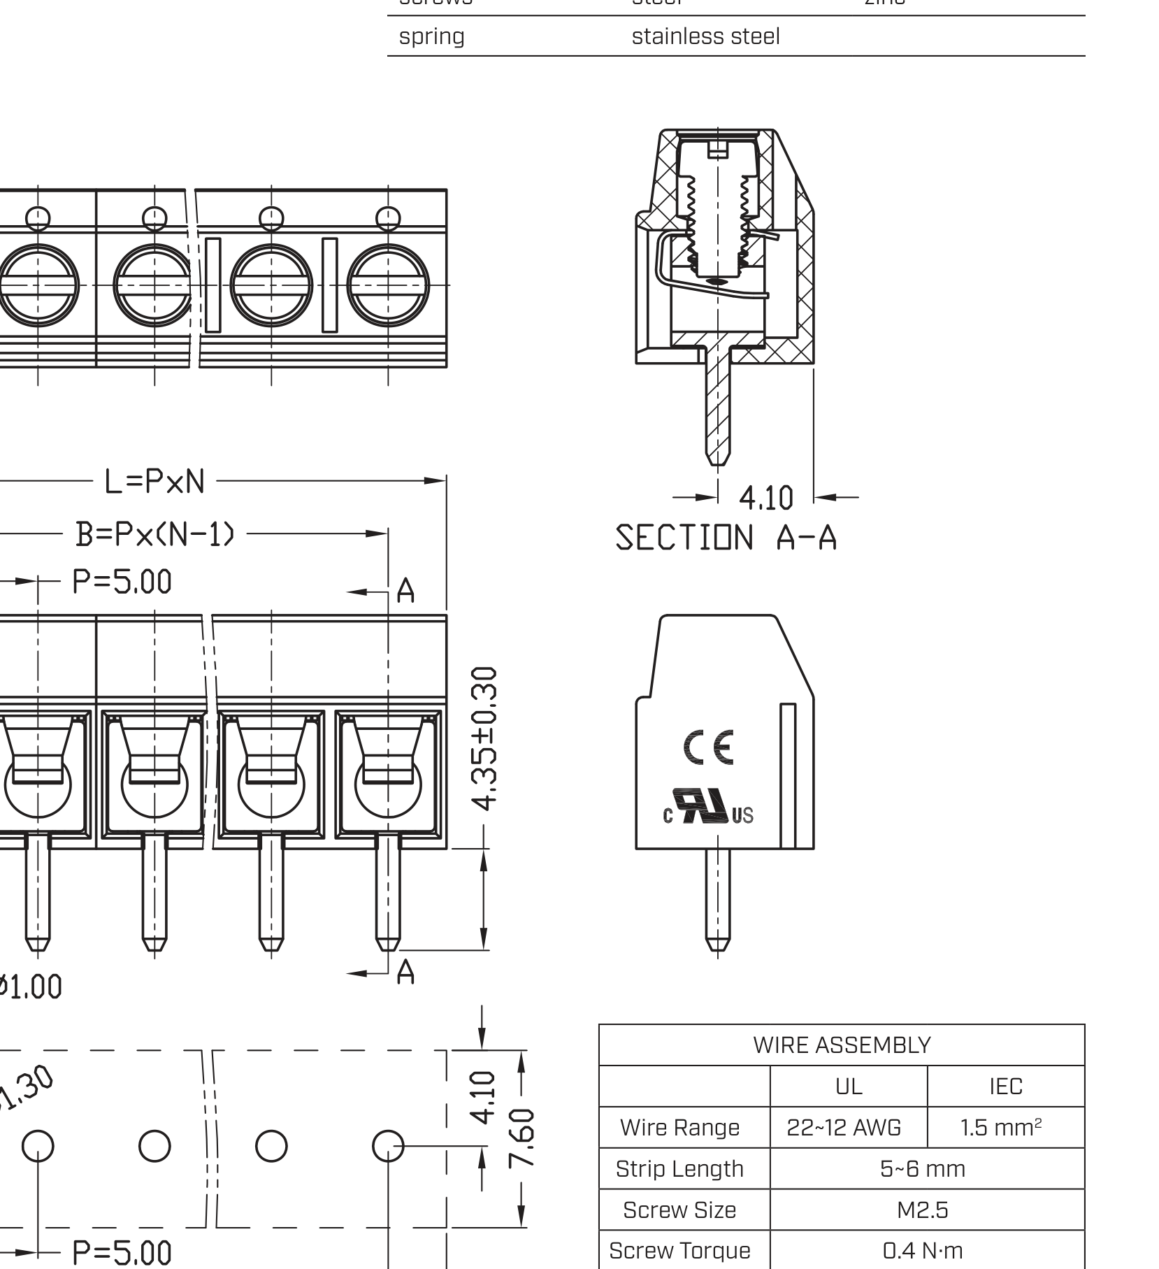
rainbow_hunt/captures/tb002_zoom.png
