brbeardm/PelletPirate/rainbow_hunt/captures/V2_AC_rails.png

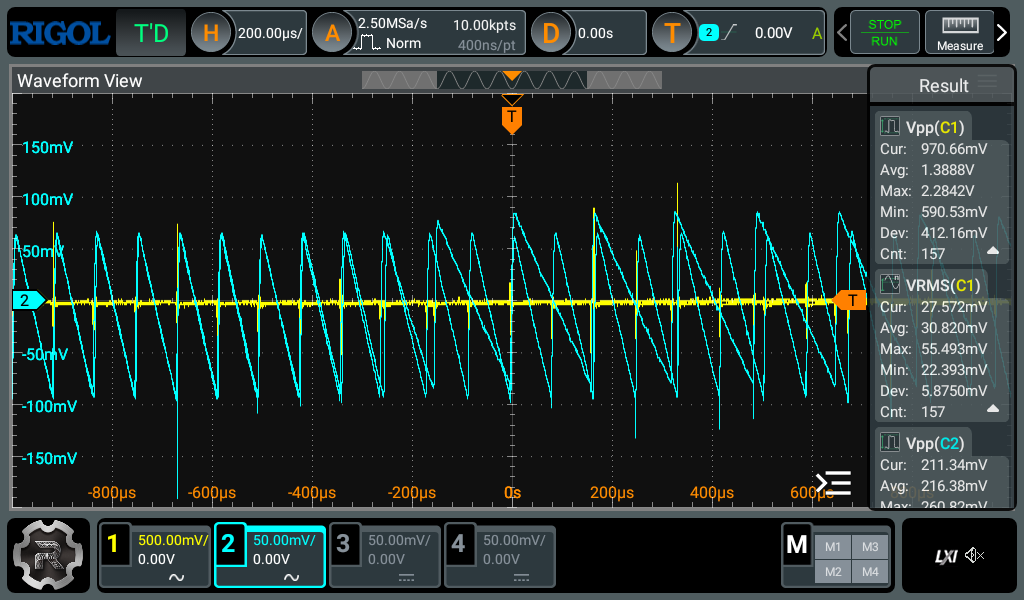
rainbow_hunt/captures/V2_AC_rails.png
