brbeardm/PelletPirate/rainbow_hunt/captures/V2_USB_baseline.png

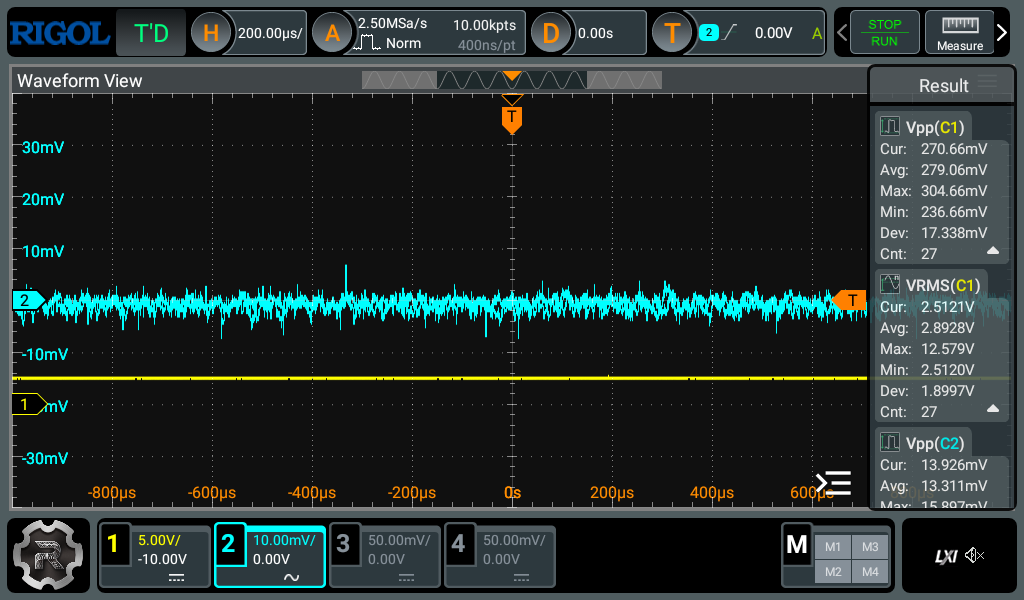
rainbow_hunt/captures/V2_USB_baseline.png
