brbeardm/PelletPirate/zzz_documentation/pcb_schematics/+3.3V-Rail.png

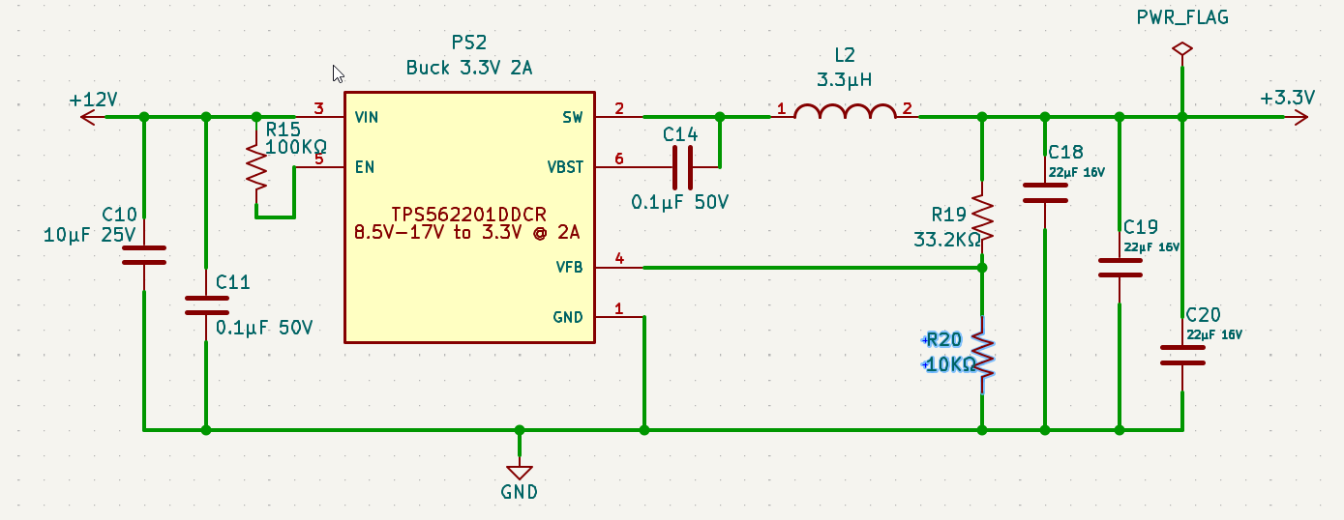
zzz_documentation/pcb_schematics/+3.3V-Rail.png
