brbeardm/PelletPirate/zzz_documentation/pcb_schematics/AC-Power.png

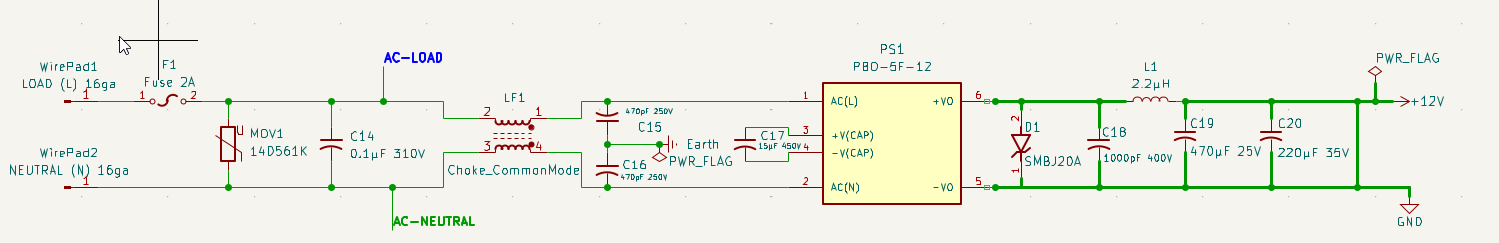
zzz_documentation/pcb_schematics/AC-Power.png
