brbeardm/PelletPirate/zzz_documentation/pcb_schematics/ESP32.png

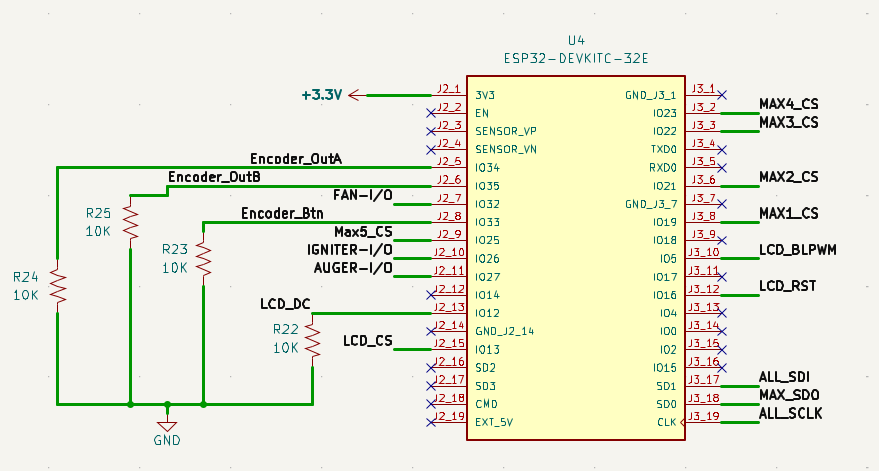
zzz_documentation/pcb_schematics/ESP32.png
