brbeardm/PelletPirate/zzz_documentation/pcb_schematics/ESP-LCD.png

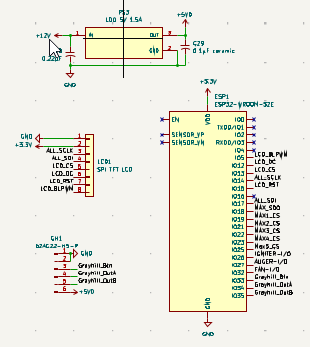
zzz_documentation/pcb_schematics/ESP-LCD.png
