brbeardm/PelletPirate/zzz_documentation/pcb_schematics/Grill.png

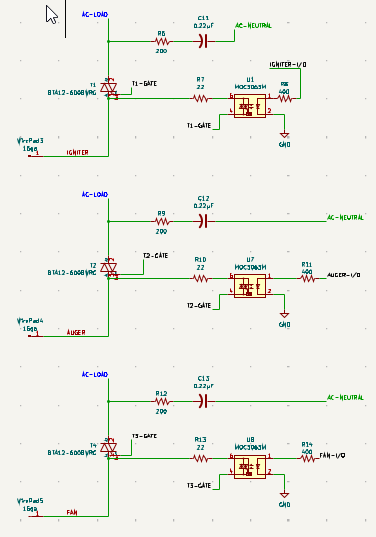
zzz_documentation/pcb_schematics/Grill.png
