brbeardm/PelletPirate/zzz_documentation/pcb_schematics/Igniter2.png

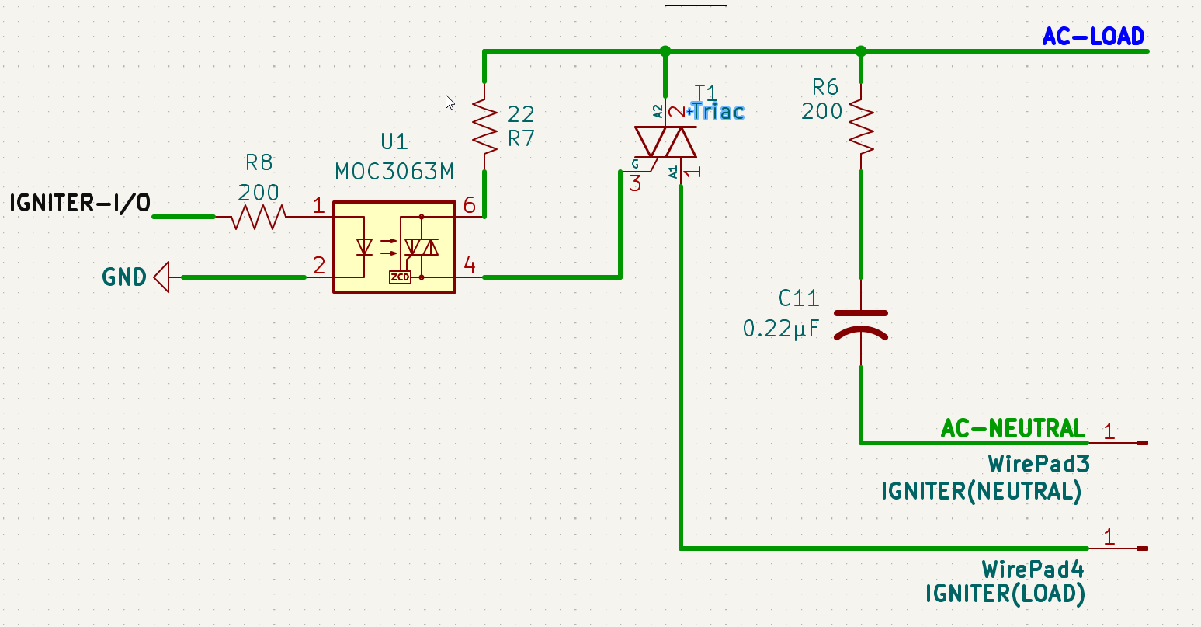
zzz_documentation/pcb_schematics/Igniter2.png
