brbeardm/PelletPirate/zzz_documentation/pcb_schematics/Igniter.png

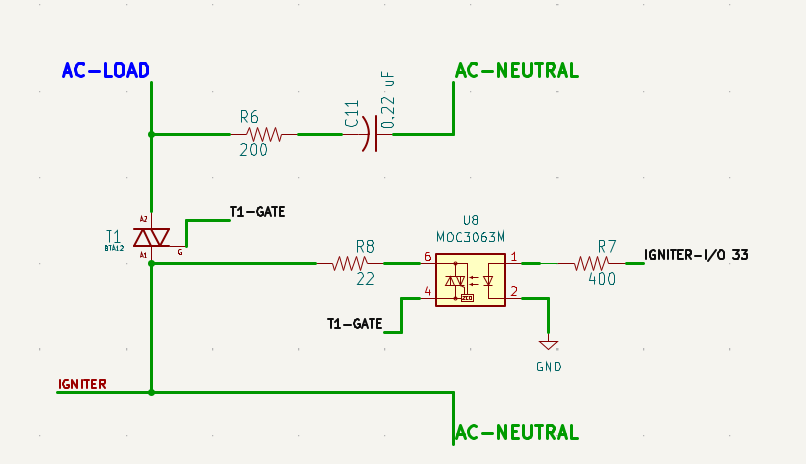
zzz_documentation/pcb_schematics/Igniter.png
