brbeardm/PelletPirate/zzz_documentation/pcb_schematics/lcd_dimensions.png

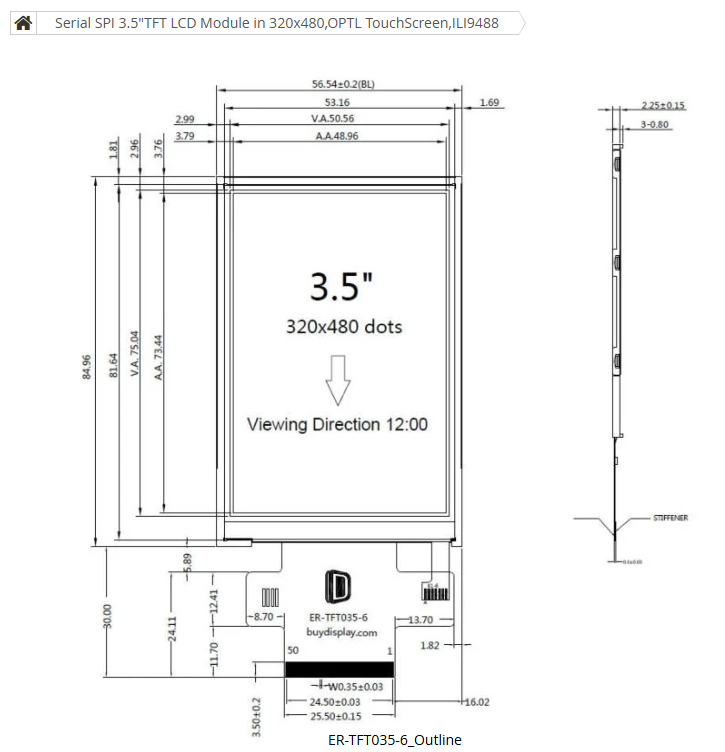
zzz_documentation/pcb_schematics/lcd_dimensions.png
