brbeardm/PelletPirate/zzz_documentation/pcb_schematics/LED-Backlight.png

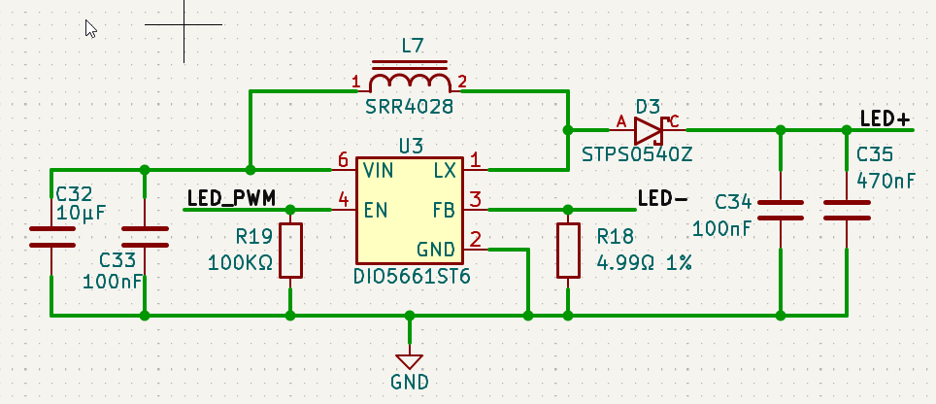
zzz_documentation/pcb_schematics/LED-Backlight.png
