brbeardm/PelletPirate/zzz_documentation/pcb_schematics/LED-Molex.png

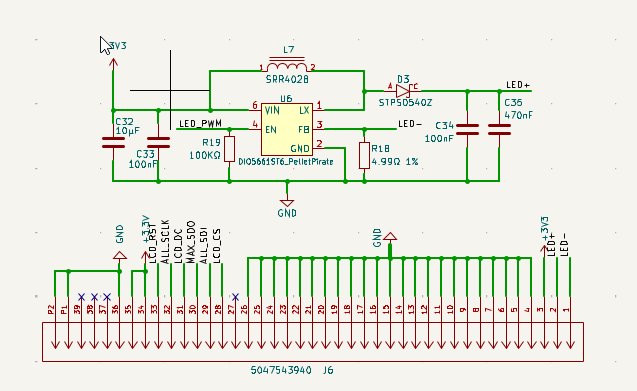
zzz_documentation/pcb_schematics/LED-Molex.png
