brbeardm/PelletPirate/zzz_documentation/pcb_schematics/LF1-out2.png

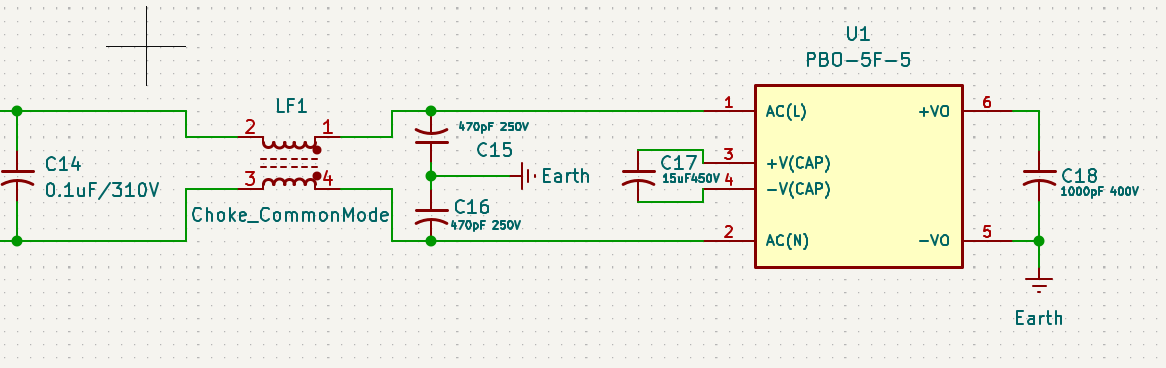
zzz_documentation/pcb_schematics/LF1-out2.png
