brbeardm/PelletPirate/zzz_documentation/pcb_schematics/LF1-out.png

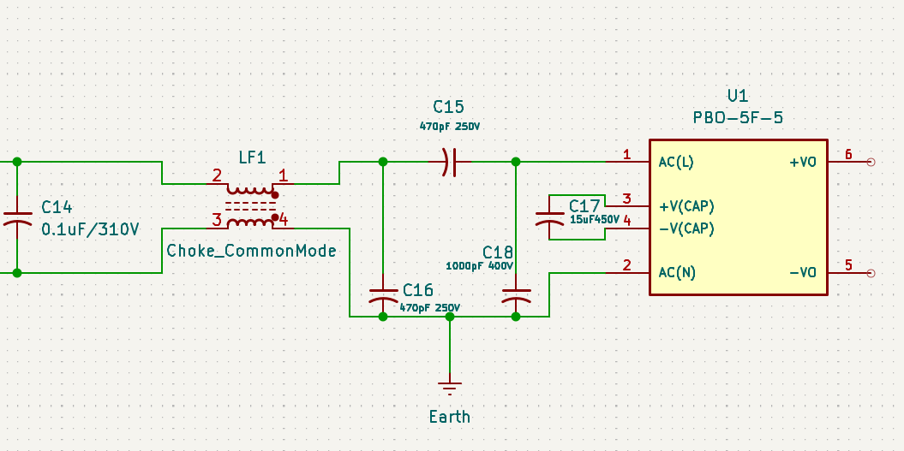
zzz_documentation/pcb_schematics/LF1-out.png
