brbeardm/PelletPirate/zzz_documentation/pcb_schematics/max31865.png

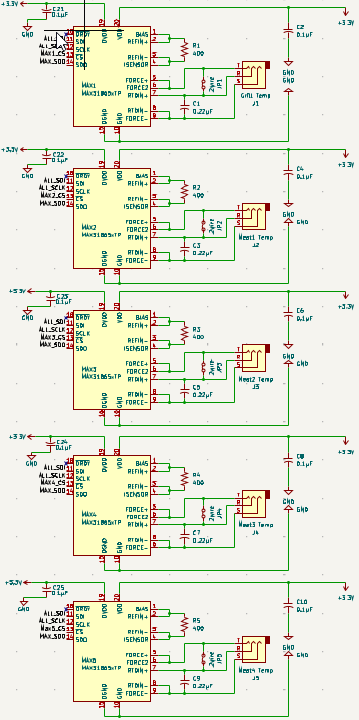
zzz_documentation/pcb_schematics/max31865.png
