brbeardm/PelletPirate/zzz_documentation/pcb_schematics/molex3940.png

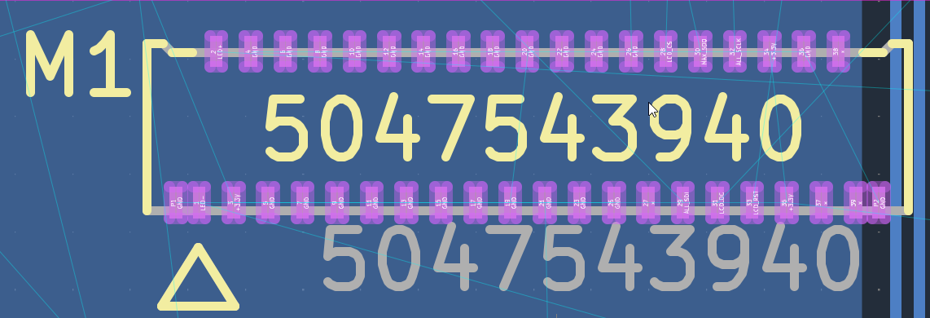
zzz_documentation/pcb_schematics/molex3940.png
