brbeardm/PelletPirate/zzz_documentation/pcb_schematics/RTD_shunt.png

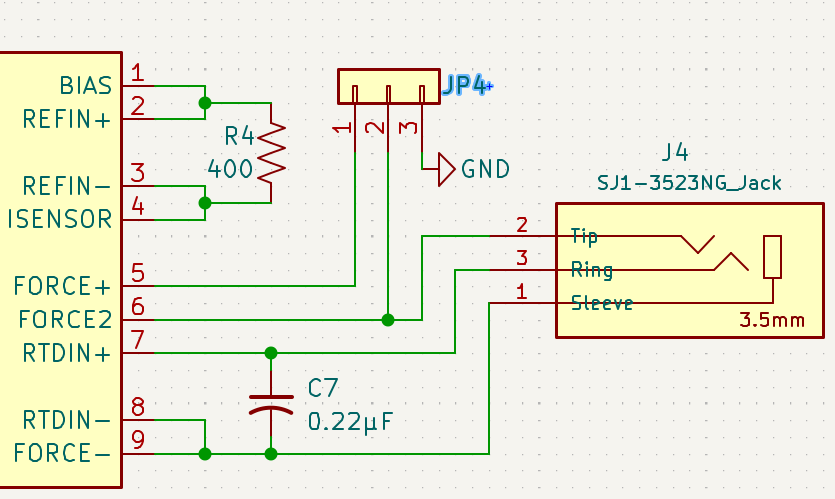
zzz_documentation/pcb_schematics/RTD_shunt.png
