brbeardm/PelletPirate/zzz_documentation/pcb_schematics/TPS562201DDCR.png

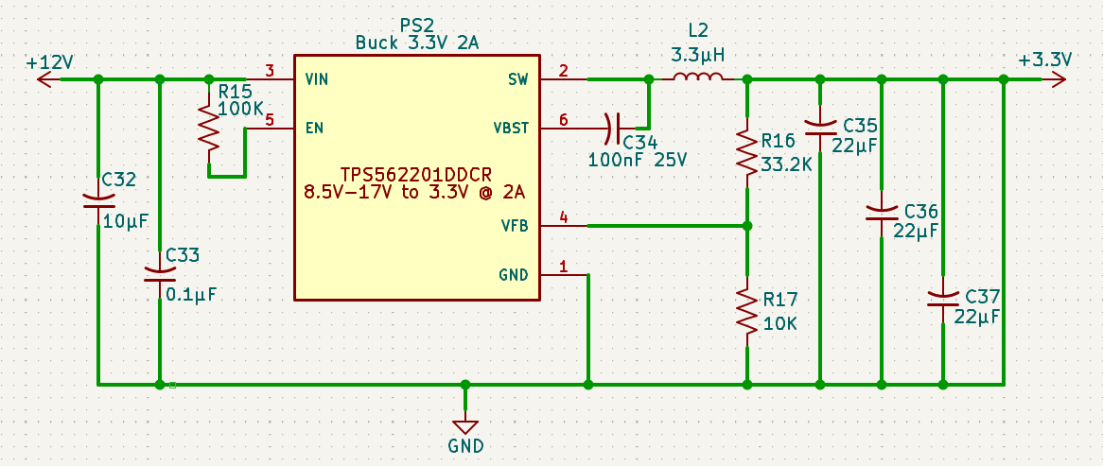
zzz_documentation/pcb_schematics/TPS562201DDCR.png
