brbeardm/PelletPirate/KiCad/PelletPirate-rev2026-00/AC side circuit and components.docx

MOV1 C15

14D561K 470pF/250V

┌─┤├──┐ ┌─┤├──┐

│ │ │ │

AC (L) ─── F1 ──────┤ ├─── LF1 ──┬───┤ ├─── 1 AC(L) +Vo 6 ───┬── L1 ──┬─────┬── +5V

300V/2A │ │ UU9.8 │ │ │ │ │ │ 2.2uH │ │

│ │ 30mH │ │ │ │ │ │ +++ ─┬─

├─┤├──┤ +++ ├─┤├──┤ │ AC-DC │ │ │ │ TVS1

│ C14 │ │ │ │ C16 │ │ │ │ C19 │ │ SMBJ

│0.1uF│ │ │ │470pF│┌── 3 +V(CAP) │ │ 470uF │ │ 7.0A

│/310V│ +++ │/250V││ │ │ │ /25V +++ ─┴─

│ │ C17 │ │ │└── 4 -V(CAP) -Vo 5 ───┴───────┴───┬──┴─── GND

│ │ 15uF/ │ │ │ │ │ │

AC (N) ─────────────┤ ├──450V────┴───┤ ├─── 2 AC(N) │ +++

│ │ │ │ │ │ │ │ C20

└─────┘ └──┬──┘ └─────────────────┘ │ │ 470uF

│ +++ /10V

┤├ C18 │

1000pF/400V │

│

═╧═

Earth

GND

F1 MOV1 C14 LF1 C15 C16

AC(L) ───────┤├─────┬─────┤├─────┤├────── pin1 ── pin3 ────┬────┤├────┘│

│ │ │

│ (both across L-N) │ ═╧═ Earth

│ │ │

AC(N) ──────────────┴──────────────────── pin2 ── pin4 ────┬────┤├────┘

a │ C18

│

┌─────────────────────────── │─────────────────┐

│ │ │

│ U1 (PBO-5F-5) │ │

│ │ │

│ pin 1 AC(L) ◄────────────┘ │

│ pin 2 AC(N) ◄────────────┘ │

│ │

│ pin 3 +V(CAP) ──┬── │

│ C17 15uF/450V │

│ pin 4 -V(CAP) ──┴── │

│ │

│ pin 6 +Vo ──┬── L1 ──┬───────┬──── +5V │

│ │ 2.2uH │ │ │

│ C20 C19 TVS1 │

│ 470uF/10V 470uF/25V SMBJ7.0A │

│ │ │ │ │

│ pin 5 -Vo ──┴────────┴───────┴──── GND │

│ │

└──────────────────────────────────────────────┘

Signal flow summary

AC(L) → F1 → MOV1/C14 (across L-N) → LF1 → C15/C16/C18 (Y-caps to earth) → U1 pin 1

AC(N) → ──── MOV1/C14 (across L-N) → LF1 → C15/C16/C18 (Y-caps to earth) → U1 pin 2

U1 pin 3/4 → C17 (input bypass cap)

U1 pin 6 (+Vo) → L1 → C19/C20/TVS1 (all across +5V to GND) → +5V

U1 pin 5 (-Vo) → ──── C19/C20/TVS1 (all across +5V to GND) → GND

┌─────┬────────┬─────────┬──────────────────────────┬─────────────────────────────────────────┐

│ Ref │ Value │ Voltage │ Type │ Purpose │

├─────┼────────┼─────────┼──────────────────────────┼─────────────────────────────────────────┤

│ C14 │ 0.1uF │ 310V │ X2 safety cap │ Differential EMC filtering (across L-N) │

├─────┼────────┼─────────┼──────────────────────────┼─────────────────────────────────────────┤

│ C15 │ 470pF │ 250V │ Y1/Y2 safety cap │ AC-side Y-cap to earth (L side) │

├─────┼────────┼─────────┼──────────────────────────┼─────────────────────────────────────────┤

│ C16 │ 470pF │ 250V │ Y1/Y2 safety cap │ AC-side Y-cap to earth (N side) │

├─────┼────────┼─────────┼──────────────────────────┼─────────────────────────────────────────┤

│ C17 │ 15uF │ 450V │ Electrolytic │ Input bypass on pins 3-4 │

├─────┼────────┼─────────┼──────────────────────────┼─────────────────────────────────────────┤

│ C18 │ 1000pF │ 400V │ Y1/Y2 safety cap │ DC-side Y-cap to earth │

├─────┼────────┼─────────┼──────────────────────────┼─────────────────────────────────────────┤

│ C19 │ 470uF │ 25V │ Solid-state electrolytic │ Bulk output filtering │

├─────┼────────┼─────────┼──────────────────────────┼─────────────────────────────────────────┤

│ C20 │ 470uF │ 10V │ Electrolytic │ Secondary output filtering │

└─────┴────────┴─────────┴──────────────────────────┴─────────────────────────────────────────┘

Other Components

┌──────┬─────────────────┬──────────────────────────────────────────┐

│ Ref │ Value / Part │ Purpose │

├──────┼─────────────────┼──────────────────────────────────────────┤

│ F1 │ 300V / 2A fuse │ AC input protection │

├──────┼─────────────────┼──────────────────────────────────────────┤

│ MOV1 │ 14D561K │ Metal oxide varistor — surge suppression │

├──────┼─────────────────┼──────────────────────────────────────────┤

│ LF1 │ UU9.8, 30mH min │ Common-mode choke — EMC filtering │

├──────┼─────────────────┼──────────────────────────────────────────┤

│ L1 │ 2.2uH │ Output inductor │

├──────┼─────────────────┼──────────────────────────────────────────┤

│ TVS1 │ SMBJ7.0A │ TVS diode — output overvoltage clamp │

├──────┼─────────────────┼──────────────────────────────────────────┤

│ U1 │ Bel PBO-5F-5 │ AC-DC power supply module │

└──────┴─────────────────┴──────────────────────────────────────────┘

Make the Kemet symbol and footprint

The general approach — it's just 4 through-hole pads:

1. Open Footprint Editor

2. File > New Footprint

3. Name it CMC_KEMET_SSRH7H_18x14.5mm

4. Add 4 through-hole pads at the positions from the datasheet

- Hole size: likely ~0.8-1.0mm

- Pad size: ~1.6-1.8mm

5. Draw the component outline on F.SilkS (18.0 x 14.5mm rectangle)

6. Add ${REFERENCE} on F.Fab

7. Add courtyard on F.CrtYd with ~0.25mm margin around the body

8. Save

If you download the datasheet and either share the path or paste the pin dimensions, I can give you the exact pad coordinates.

※ recap: Designing the AC input and power supply circuit for the PelletPirate outdoor pellet grill controller board using a Bel PBO-5F-5. Currently need the KEMET SSRH7HS-M05324 common-mode choke datasheet to

build its KiCad footprint.
