brbeardm/PelletPirate/KiCad/FPC_for_PCB_to_LCD/PCB_to_LCD_FPC_BOM.csv

Designator | Quantity | Manufacturer | MPN | Description | DigiKey
J1 | 1 | Hirose Electric | FH26W-39S-0.3SHW(60) | 39-position 0.3 mm pitch bottom-contact ZIF FPC connector | H125803CT-ND
