brbeardm/PelletPirate/KiCad/PelletPirate_V4/PCBWay_BOM_Response.xlsx

PCBWay Bom Quotation, Product No.:T-1N17W181746A
Item # | *Designator | *Qty | Manufacturer | *Mfg Part # | Description / Value | *Package/Footprint | Category | Your Instructions / Notes | *Unit Price(5 units) | *Total | *Delivery Time | Customer Reply | PCBWay Update
1 | C4 | 1 | KEMET | R46KF310000M1M | 0.1 µF Film Capacitor 275V 560V Polypropylene (PP), Metallized Radial『 』0.1µF 275V X2 | Capacitor_THT:C_Rect_L13.0mm_W6.0mm_P10.00mm_FKS3_FKP3_MKS4 | PS1 | https://www.digikey.com/en/products/detail/kemet/R46KF310000M1M/5177298 | $1.290 | $6.450 | 7-10 Workdays
2 | C5,C6 | 2 | VISHAY | VY2471K29Y5SS63V7 | 470 pF ±10% 440VAC Ceramic Capacitor Y5S Radial, Disc『 』470pF 440V X1Y2 | Capacitors:C_Disc_D7.5mm_W5.0mm_P7.50mm_3mmPinOffset | PS1 | https://www.digikey.com/en/products/detail/vishay-beyschlag-draloric-bc-components/VY2471K29Y5SS63V7/1983391 | $0.589 | $5.890 | 7-10 Workdays
3 | C7 | 1 | Rubycon | 450BXG15MEFC10X20 | 15 µF 450 V Aluminum Electrolytic Capacitors Radial, Can 10000 Hrs @ 105°C『 』15µF 450V | Capacitor_THT:CP_Radial_D10.0mm_P5.00mm | PS1 | https://www.digikey.com/en/products/detail/rubycon/450BXG15MEFC10X20/23330777 | $2.657 | $13.285 | 7-10 Workdays
4 | C8,C10,C38 | 3 | KEMET | C1206C106K3RACTU | 10 µF ±10% 25V Ceramic Capacitor X7R 1206 (3216 Metric)『 』10µF 25V | Capacitor_SMD:C_1206_3216Metric | PS2, PS3, ESP | https://www.digikey.com/en/products/detail/kemet/C1206C106K3RACTU/3317648 | $0.980 | $14.700
5 | C9,C17,C21,C22,C23,C24,C25,C26,C27,C28,C29,C30,C31,C32,C33,C34,C35,C39,C40,C41 | 20 | KEMET | C0402C104K3RACTU | 0.1 µF ±10% 25V Ceramic Capacitor X7R 0402 (1005 Metric)『 』0.1µF 25V | Capacitor_SMD:C_0402_1005Metric | ESP,MAX, PS3, ESP | https://www.digikey.com/en/products/detail/kemet/C0402C104K3RACTU/6697176 | $0.142 | $14.200
6 | C11,C14 | 2 | KEMET | C0805C104K5RACTU | 0.1 µF ±10% 50V Ceramic Capacitor X7R 0805 (2012 Metric)『 』0.1µF 50V | Capacitor_SMD:C_0805_2012Metric | PS2 | https://www.digikey.com/en/products/detail/kemet/C0805C104K5RACTU/411169 | $0.158 | $1.580
7 | C12 | 1 | VISHAY | VY2102M29Y5US63V7 | 1000 pF ±20% 440VAC Ceramic Capacitor Y5U (E) Radial, Disc『 』1000pF 440V Y5U | Capacitors:C_Disc_D7.5mm_W5.0mm_P7.50mm_3mmPinOffset | PS1 | https://www.digikey.com/en/products/detail/vishay-beyschlag-draloric-bc-components/VY2102M29Y5US63V7/1983393 | $0.945 | $4.725
8 | C13 | 1 | KEMET | A750MS477M1EAAE015 | 470 µF 25 V Aluminum - Polymer Capacitors Radial, Can 15mOhm 2000 Hrs @ 105°C『 』470µF 25V | Capacitor_THT:CP_Radial_D10.0mm_P5.00mm | PS1 | https://www.digikey.com/en/products/detail/kemet/A750MS477M1EAAE015/6196448 | $1.837 | $9.185 | 7-10 Workdays
9 | C15 | 1 | KYOCERA AVX | RPF0811221M035K | 220 µF 35 V Aluminum - Polymer Capacitors Radial, Can 44mOhm 5000 Hrs @ 105°C『 』220µF 35V | Capacitor_THT:CP_Radial_D8.0mm_P3.50mm | PS1 | https://www.digikey.com/en/products/detail/kyocera-avx/RPF0811221M035K/20096675 | $1.525 | $7.625 | 7-10 Workdays
10 | C16 | 1 | KEMET | C0805C105K5RACTU | 1 µF ±10% 50V Ceramic Capacitor X7R 0805 (2012 Metric)『 』1µF 50V | Capacitor_SMD:C_0805_2012Metric | PS3 | https://www.digikey.com/en/products/detail/kemet/C0805C105K5RACTU/3317615 | $0.504 | $2.520
11 | C18,C19,C20 | 3 | MURATA | GRM31CZ71C226ME15L | 22 µF ±20% 16V Ceramic Capacitor X7R 1206 (3216 Metric)『 』22µF 16V | Capacitor_SMD:C_1206_3216Metric | PS2 | https://www.digikey.com/en/products/detail/murata-electronics/GRM31CZ71C226ME15L/13904808 | $1.260 | $18.900
12 | C36 | 1 | KEMET | C0805C224K5RACTU | 0.22 µF ±10% 50V Ceramic Capacitor X7R 0805 (2012 Metric)『 』0.22µF 50V | Capacitor_SMD:C_0805_2012Metric | PS3 | https://www.digikey.com/en/products/detail/kemet/C0805C224K5RACTU/754753 | $0.294 | $1.470
13 | C37 | 1 | KEMET | C0805C105K3RACTU | 1 µF ±10% 25V Ceramic Capacitor X7R 0805 (2012 Metric)『 』1µF 25V | Capacitor_SMD:C_0805_2012Metric | ESP | https://www.digikey.com/en/products/detail/kemet/C0805C105K3RACTU/2211765 | $0.378 | $1.890
14 | C42 | 1 | Samsung | CL05B102KB5NNNC | 1000 pF ±10% 50V Ceramic Capacitor X7R 0402 (1005 Metric)『 』1000pF 50V | Capacitor_SMD:C_0402_1005Metric | GRILL | https://www.digikey.com/en/products/detail/samsung-electro-mechanics/CL05B102KB5NNNC/3886690 | $0.126 | $0.630
15 | D1 | 1 | Littelfuse | SMBJ20A | TVS Diode, 600W, 20V, -65 to 150 Operating Temp, Surface Mount, SMBJ Series | Littelfuse SMBJ20A『 』SMBJ20A | SMBJ20A_PelletPirate:DIOM5436X261N_PelletPirate | PS1 | https://www.digikey.com/en/products/detail/littelfuse-inc/SMBJ20A/285988 | $0.145 | $0.725
16 | D2 | 1 | STMicroelectronics | STPS0540Z | Diode Schottky 40 V 500mA Surface Mount SOD-123『 』STPS0540Z | STPS0540Z_Schotty Diode LED:Schotty_Diode_Flyman | PS3 | https://www.digikey.com/en/products/detail/stmicroelectronics/STPS0540Z/1039586 | $0.193 | $0.965
17 | ESP1 | 1 | Espressif Systems | ESP32-S3-WROOM-1U-N16R8 | Bluetooth, WiFi 802.11b/g/n, Bluetooth v5.0 Transceiver Module 2.4GHz Antenna Not Included, U.FL Surface Mount『 』ESP32-S3-WROOM-1U-N16R8-flyman | Expressif_S3_N16R8_Chip_N1U:ESP32-S3-WROOM-1U-flyman | ESP | https://www.digikey.com/en/products/detail/espressif-systems/ESP32-S3-WROOM-1U-N16R8/16162641 | $6.038 | $30.190
18 | FPC1 | 1 | Hirose Electric Co Ltd | FH26W-39S-0.3SHW(60) | 39 Position FPC Connector Contacts, Bottom 0.012 (0.30mm) Surface Mount, Right Angle『 』FH26W-39S-0.3SHW_60_ | FPC_Connector_HiRose:HRS_FH26W-39S-0.3SHW_60_ | LCD | https://www.digikey.com/en/products/detail/hirose-electric-co-ltd/FH26W-39S-0-3SHW-60/5132503 | $0.483 | $2.415
19 | J1,J2,J3,J4,J5 | 5 | Same Sky | SJ1-3523NG | 3.5 mm, Stereo, Right Angle, Through Hole, Isolated Ground, 3 Conductors, 0 Internal Switches, Audio Jack Connector『 』SJ1-3523NG_Jack_PP | 3.5mm_Jacks:CUI_SJ1-3523NG_PelletPirate | MAX | https://www.digikey.com/en/products/detail/same-sky-formerly-cui-devices/SJ1-3523NG/738692 | $1.142 | $28.550 | 7-10 Workdays
20 | J6 | 1 | Hirose Electric Co Ltd | DF13-4P-1.25DSA(25) | Connector Header Through Hole 4 position 0.049 (1.25mm)『 』Conn_01x04 | Connector_Hirose:Hirose_DF13-04P-1.25DSA_1x04_P1.25mm_Vertical | ENCODER | https://www.digikey.com/en/products/detail/hirose-electric-co-ltd/DF13-4P-1-25DSA-25/15997347 | $1.220 | $6.100 | 7-10 Workdays
21 | J7 | 1 | Sullins | PPTC041LFBN-RC | Generic connector, single row, 01x04, script generated『 』Conn_01x04_Socket | Connector_PinSocket_2.54mm:PinSocket_1x04_P2.54mm_Vertical | TESTING | https://www.digikey.com/en/products/detail/sullins-connector-solutions/PPTC041LFBN-RC/810144 | $0.787 | $3.935 | 7-10 Workdays
22 | J8 | 1 | GCT | USB4105-GF-A | USB-C (USB TYPE-C) USB 2.0 Receptacle Connector 24 (16+8 Dummy) Position Surface Mount, Right Angle; Through Hole『 』USB4105-GF-A_fly | USB_try2:GCT_USB4105-GF-A_flyman | ESP | https://www.digikey.com/en/products/detail/gct/USB4105-GF-A/11198441 | $1.328 | $6.640
23 | J9 | 1 | Molex | 0436500215 | Connector Header Through Hole 2 position 0.118 (3.00mm)『 』Conn_01x02 | Connector_Molex:Molex_Micro-Fit_3.0_43650-0215_1x02_P3.00mm_Vertical | GRILL | https://www.digikey.com/en/products/detail/molex/0436500215/283461 | $1.087 | $5.435
24 | L1 | 1 | Murata | LQH3NPH2R2MMEL | Inductor with Inductance 2.2uH Tol.+/-20% Package 1212 (3030)『 』2.2µH | 2.2uH_Murata_1212_footprint:IND_LQH3NPH2R2MMEL | PS1 | https://www.digikey.com/en/products/detail/murata-electronics/LQH3NPH2R2MMEL/12476579 | $0.970 | $4.850
25 | L2 | 1 | Murata | LQH43PN3R3M26L | Inductor with Inductance: 3.3uH Tol. +/-20%, Package: 1812 (4532)『 』3.3µH | 3.3uH_Inductor_Murata:IND_LQH43PN3R3M26L | PS2 | https://www.digikey.com/en/products/detail/murata-electronics/LQH43PN3R3M26L/4359202 | $0.391 | $1.955
26 | L3 | 1 | Bourns | SRR4028-100Y | 10 µH Shielded Drum Core, Wirewound Inductor 1.19 A 110mOhm Max 1919 (4848 Metric)『 』SRR4028-100Y | SRR4028-100Y_Inductor_Flyman:SRR4028_Flyman | PS3 | https://www.digikey.com/en/products/detail/bourns-inc/SRR4028-100Y/1970246 | $0.806 | $4.030
27 | LED1 | 1 | LiteOn | LTST-C191KGKT | Green 571nm LED Indication - Discrete 2V 0603 (1608 Metric)『 』LTST-C191KGKT_flyman | LED_SMD:LED_0603_1608Metric | ESP | https://www.digikey.com/en/products/detail/liteon/LTST-C191KGKT/386835 | $0.081 | $0.405
28 | LF1 | 1 | KEMET | SSRH7H-M05408 | Generic common-mode choke, ferrite core, 1243 pin order『 』SSRH7H-M05408 | Kemet:Kemet_Choke_SSRH7H_M05408 | PS1 | https://www.digikey.com/en/products/detail/kemet/SSRH7H-M05408/8509242 | $2.778 | $13.890 | 7-10 Workdays
29 | MAX1,MAX2,MAX3,MAX4,MAX5 | 5 | ANALOG DEVICES | MAX31865ATP+ | Temp Monitoring System (Sensor) External Sensor SPI Output 20-TQFN (5x5)『 』MAX31865xTP | Package_DFN_QFN:TQFN-20-1EP_5x5mm_P0.65mm_EP3.25x3.25mm | MAX | https://www.digikey.com/en/products/detail/analog-devices-inc-maxim-integrated/MAX31865ATP/3681476 | $4.782 | $119.550
30 | MOC1,MOC2 | 2 | ONSEMI | MOC3063M | Optoisolator Triac Output 4170Vrms 1 Channel 6-DIP『 』MOC3063M | MOC3063M-PP2:MOC3063M-PP2 | GRILL | https://www.digikey.com/en/products/detail/onsemi/MOC3063M/281237 | $0.886 | $8.860
31 | MOC3 | 1 | ONSEMI | MOC3053M | Optoisolator Triac Output 4170Vrms 1 Channel 6-DIP『 』MOC3053M | MOC3053M_Opto_FanPulse:DIP762W46P254L851H508Q6 | GRILL | https://www.digikey.com/en/products/detail/onsemi/MOC3053M/9764702 | $2.063 | $10.315 | 7-10 Workdays
32 | MOV1 | 1 | BOURNS | MOV-14D561K | 560 V 4.5 kA Varistor 1 Circuit Through Hole Disc 14mm『 』PP_14D561K | Varistors_PelletPirate:MOV-14D561K-Varistor-2 | PS1 | https://www.digikey.com/en/products/detail/bourns-inc/MOV-14D561K/2798251 | $0.695 | $3.475 | 7-10 Workdays
33 | PS1 | 1 | Bel Fuse | PBO-5F-12 | Open Frame AC DC Converters 1 Output 12V 420mA 85 ~ 305 VAC, 70 ~ 430 VDC Input『 』PBO-5F-12 | NewPBO-5F-12-try:CONV_PBO-5F-12_AUDIT | PS1 | https://www.digikey.com/en/products/detail/bel-power-solutions/PBO-5F-12/28717413 | $8.215 | $41.075 | 7-10 Workdays
34 | PS2 | 1 | Texas Instruments | TPS562201DDCR | 4.5 V to 17 V input, 2 A output, synchronous step-down converter in Eco-mode『 』Buck 3.3V 2A | Buck_3.3V:SOT95P280X110-6N | PS2 | https://www.digikey.com/en/products/detail/texas-instruments/TPS562201DDCR/5808210 | $0.121 | $0.605
35 | PS3 | 1 | Texas Instruments | TPS61165DBVR | LED Driver IC 1 Output DC DC Regulator Step-Up (Boost) PWM Dimming 1.2A (Switch) SOT-23-6『 』TPS61165DBVR | LED_Driver:SOT95P280X145-6N | PS3 | https://www.digikey.com/en/products/detail/texas-instruments/TPS61165DBVR/2340764 | $0.918 | $4.590
36 | R4,R5,R6 | 3 | PANASONIC | ERJ-UP6F1800V | 180 Ohms ±1% 0.5W, 1/2W Chip Resistor 0805 (2012 Metric) Anti-Sulfur, Automotive AEC-Q200, Pulse Withstanding Thick Film『 』180Ω | Resistor_SMD:R_0805_2012Metric | GRILL | https://www.digikey.com/en/products/detail/panasonic-industry/ERJ-UP6F1800V/8134828 | $0.162 | $2.430
37 | R7,R8,R9 | 3 | PANASONIC | ERJ-UP6F1800V | 180 Ohms ±1% 0.5W, 1/2W Chip Resistor 0805 (2012 Metric) Anti-Sulfur, Automotive AEC-Q200, Pulse Withstanding Thick Film『 』180Ω | Resistor_SMD:R_0805_2012Metric | GRILL | https://www.digikey.com/en/products/detail/panasonic-industry/ERJ-UP6F1800V/8134828 | $0.162 | $2.430
38 | R15 | 1 | YAGEO | RC0603FR-07100KL | 100 kOhms ±1% 0.1W, 1/10W Chip Resistor 0603 (1608 Metric) Moisture Resistant Thick Film『 』100KΩ | Resistor_SMD:R_0603_1608Metric | GRILL | https://www.digikey.com/en/products/detail/yageo/RC0603FR-07100KL/726889 | $0.053 | $0.265
39 | R16,R20,R30,R31,R32,R33,R34,R35,R36,R40,R43 | 11 | YAGEO | RC0402FR-0710KL | 10 kOhms ±1% 0.063W, 1/16W Chip Resistor 0402 (1005 Metric) Moisture Resistant Thick Film『 』10KΩ | Resistor_SMD:R_0402_1005Metric | ESP,GRILL | https://www.digikey.com/en/products/detail/yageo/RC0402FR-0710KL/726523 | $0.010 | $0.550
40 | R17 | 1 | YAGEO | RC1206FR-074R99L | 4.99 Ohms ±1% 0.25W, 1/4W Chip Resistor 1206 (3216 Metric) Moisture Resistant Thick Film『 』4.99Ω 1% | Resistor_SMD:R_1206_3216Metric | GRILL | https://www.digikey.com/en/products/detail/yageo/RC1206FR-074R99L/728895 | $0.105 | $0.525
41 | R18 | 1 | YAGEO | RC0402FR-07100RL | 100 Ohms ±1% 0.063W, 1/16W Chip Resistor 0402 (1005 Metric) Moisture Resistant Thick Film『 』100Ω | Resistor_SMD:R_0402_1005Metric | ESP | https://www.digikey.com/en/products/result?keywords=RC0402FR-07100RL | $0.032 | $0.160
42 | R19 | 1 | YAGEO | RC0805FR-0733K2L | 33.2 kOhms ±1% 0.125W, 1/8W Chip Resistor 0805 (2012 Metric) Moisture Resistant Thick Film『 』33.2KΩ | Resistor_SMD:R_0805_2012Metric | PS2 | https://www.digikey.com/en/products/detail/yageo/RC0805FR-0733K2L/727865 | $0.074 | $0.370
43 | R21,R22,R23,R24,R25 | 5 | YAGEO | RT1206BRD07400RL | 400 Ohms ±0.1% 0.25W, 1/4W Chip Resistor 1206 (3216 Metric) Thin Film『 』400Ω | Resistor_SMD:R_1206_3216Metric | GRILL | https://www.digikey.com/en/products/detail/yageo/RT1206BRD07400RL/5936956 | $0.147 | $3.675
44 | R26,R27,R28 | 3 | VISHAY | CRCW1206360RFKEA | 360 Ohms ±1% 0.25W, 1/4W Chip Resistor 1206 (3216 Metric) Automotive AEC-Q200 Thick Film『 』360Ω 1/4W | Resistor_SMD:R_1206_3216Metric | GRILL | https://www.digikey.com/en/products/detail/vishay-dale/CRCW1206360RFKEA/1176592 | $0.108 | $1.620
45 | R37,R38 | 2 | Stackpole Electronics | RMCF0603FT5K10 | 5.1 kOhms ±1% 0.1W, 1/10W Chip Resistor 0603 (1608 Metric) Automotive AEC-Q200 Thick Film『 』5.1KΩ | Resistor_SMD:R_0603_1608Metric | ESP | https://www.digikey.com/en/products/detail/stackpole-electronics-inc/RMCF0603FT5K10/1760908 | $0.032 | $0.320
46 | R39 | 1 | Stackpole Electronics | RMCF0603FT1K00 | 1 kOhms ±1% 0.1W, 1/10W Chip Resistor 0603 (1608 Metric) Automotive AEC-Q200 Thick Film『 』1KΩ | Resistor_SMD:R_0603_1608Metric | ESP | https://www.digikey.com/en/products/detail/stackpole-electronics-inc/RMCF0603FT1K00/1761077 | $0.053 | $0.265
47 | R41,R42 | 2 | Panasonic | ERJ-P08J153V | Panasonic ERJ-P08J153V — 15kΩ 5% 2/3W 1206 anti-surge『 』15KΩ | Resistor_SMD:R_1206_3216Metric | GRILL | https://www.digikey.com/en/products/detail/panasonic-industry/ERJ-P08J153V/525339 | $0.208 | $2.080
48 | S1,S2 | 2 | C&K Components | KMR221G LFS | Switch;Tactile;SPST-NO;OFF-MOM;Top Actuated;1.90mm;2N;0.05A;32VDC;Gull Wing | C&K KMR221G LFS『 』KMR221GLFS | KMR221GLFS_SMD_boot_reset_switch:SW_KMR221GLFS | ESP | https://www.digikey.com/en/products/detail/c-k/KMR221G-LFS/550472 | $0.886 | $8.860
49 | T1,T2,T3 | 3 | STMicroelectronics | BTA12-600BWRG | 12A RMS, 600V Off-State Voltage, 50mA Sensitivity, Snubberless, Insulated, Triac, TO-220『 』BTA12-600BWRG | Package_TO_SOT_THT:TO-220-3_Vertical | GRILL | https://www.digikey.com/en/products/detail/stmicroelectronics/BTA12-600BWRG/654429 | $0.751 | $11.265
50 | U1 | 1 | STMicroelectronics | USBLC6-2SC6 | 17V Clamp 5A (8/20µs) Ipp Tvs Diode Surface Mount SOT-23-6『 』USBLC6-2SC6 | USBC6-2SC6:SOT95P280X145-6N | ESP | https://www.digikey.com/en/products/detail/stmicroelectronics/USBLC6-2SC6/1040559 | $0.362 | $1.810
51 | U3 | 1 | ON Semiconductor | H11AA1M | Optoisolator Transistor with Base Output 4170Vrms 1 Channel 6-DIP『 』H11AA1M | Package_DIP:DIP-6_W7.62mm | GRILL | https://www.digikey.com/en/products/detail/onsemi/H11AA1M/1053602 | $0.966 | $4.830
 |  |  |  |  |  |  |  |  | Component Cost | $443.06
 |  |  |  |  |  |  |  |  | Assembly Cost | $29.00
 |  |  |  |  |  |  |  |  | PCB Cost | $216.81
 |  |  |  |  |  |  |  |  | V2 Member 2% off | -$4.92
 |  |  |  |  |  |  |  |  | All Total 5 Units | $683.95
