brbeardm/PelletPirate/3D-printer-stencils/files/soldermask.stl

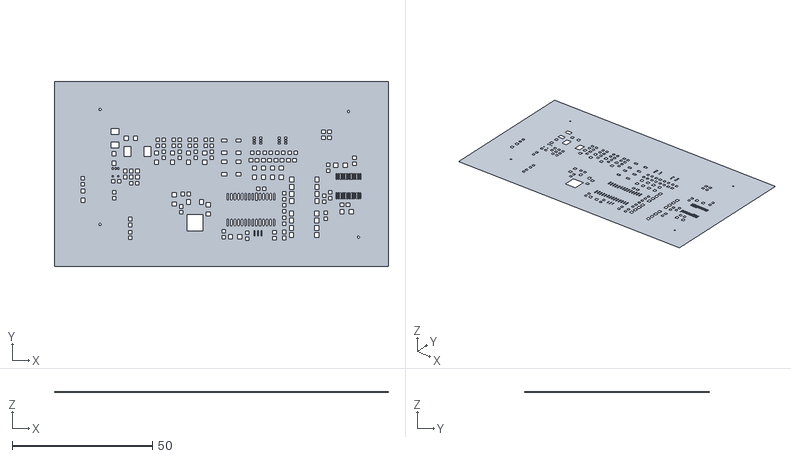
[picture p103: CAD file, 2026-05-22]
3D-printer-stencils/files/soldermask.stl
118.9 x 66.0 x 0.2
