brbeardm/PelletPirate/KiCad/ESP_Breadboard/B3F-1000/B3F-1000.step

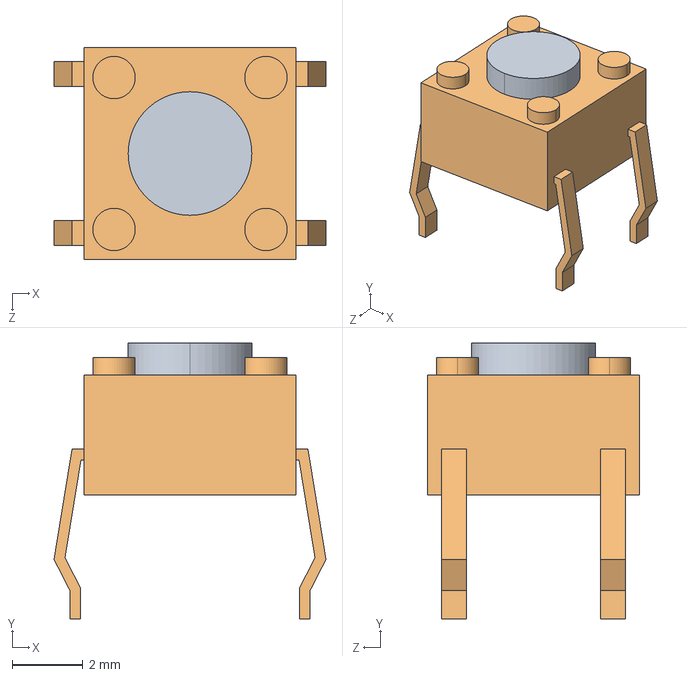
[picture p104: CAD file, 2026-08-30]
KiCad/ESP_Breadboard/B3F-1000/B3F-1000.step
7.70 x 7.80 x 6.00 mm
B3F_1000_BUTTON
B3F_1000_BASE
