brbeardm/PelletPirate/KiCad/ESP_Breadboard/Capacitors/R46KF310000M1M.step

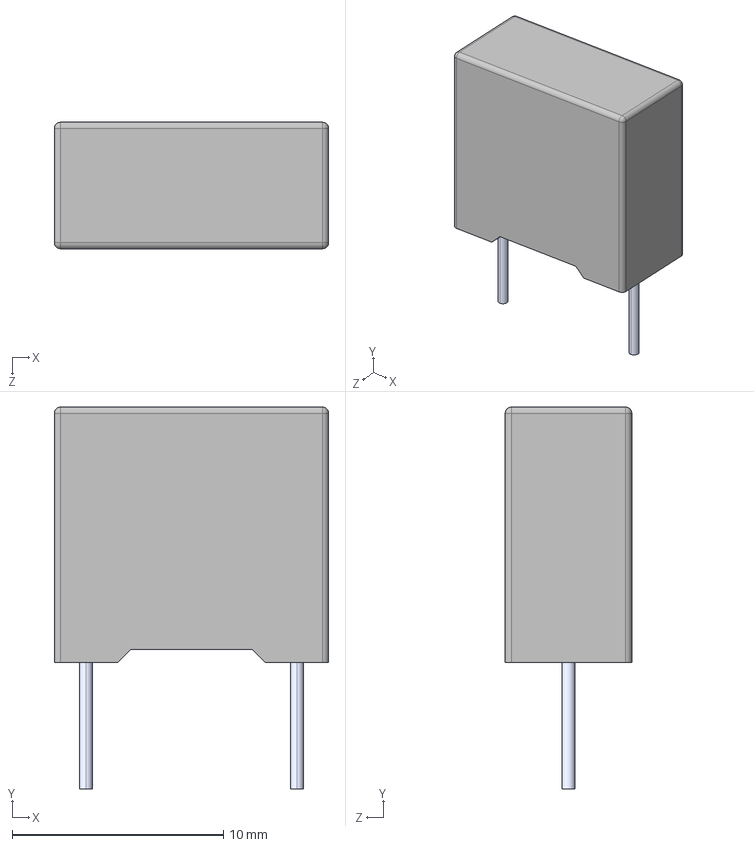
[picture p105: CAD file, 2026-05-22]
KiCad/ESP_Breadboard/Capacitors/R46KF310000M1M.step
13.0 x 18.1 x 6.00 mm
