brbeardm/PelletPirate/KiCad/ESP_Breadboard/ESP32-DevKitC-32E_PelletPirate/ESP32-DEVKITC-32E.step

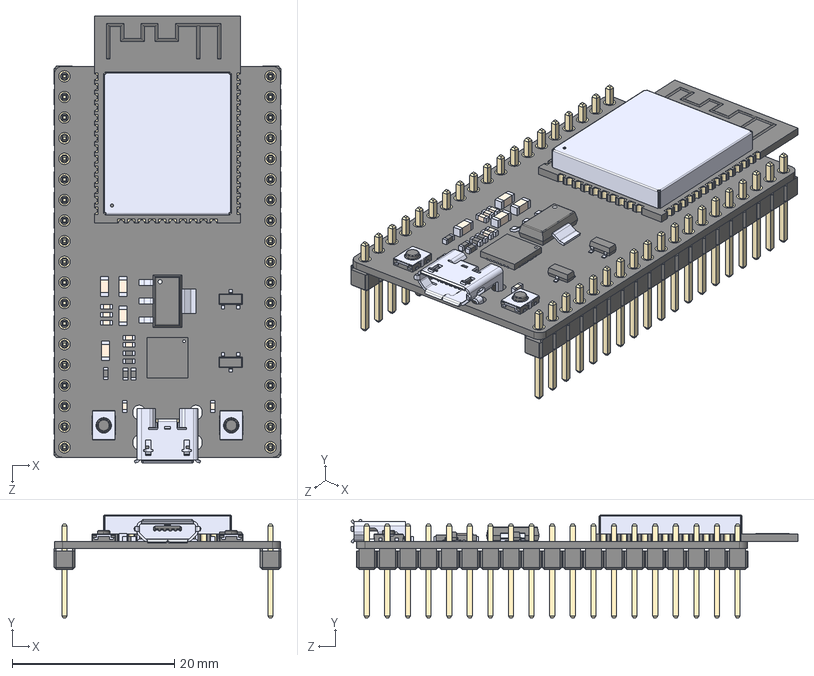
[picture p106: CAD file, 2026-05-22]
KiCad/ESP_Breadboard/ESP32-DevKitC-32E_PelletPirate/ESP32-DEVKITC-32E.step
27.9 x 12.7 x 55.1 mm
board
header x 2
ESP32-WROOM-32D
micro usb
button x 2
CP2102N-A01-GQFN28
AMS1117-3.3
SS8050-G
components^DEVKIT V1 ESP32-WROOM-32
