brbeardm/PelletPirate/KiCad/ESP_Breadboard/ESP32-S3-WROOM-1U-N16R8/ESP32-S3-WROOM-1U-N16R8.step

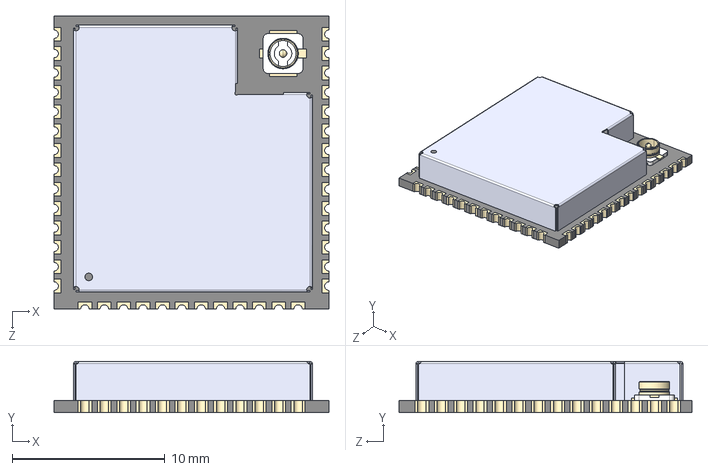
[picture p107: CAD file, 2026-08-24]
KiCad/ESP_Breadboard/ESP32-S3-WROOM-1U-N16R8/ESP32-S3-WROOM-1U-N16R8.step
18.0 x 3.35 x 19.2 mm
