brbeardm/PelletPirate/KiCad/ESP_Breadboard/LED_light/LTST-C191KGKT.step

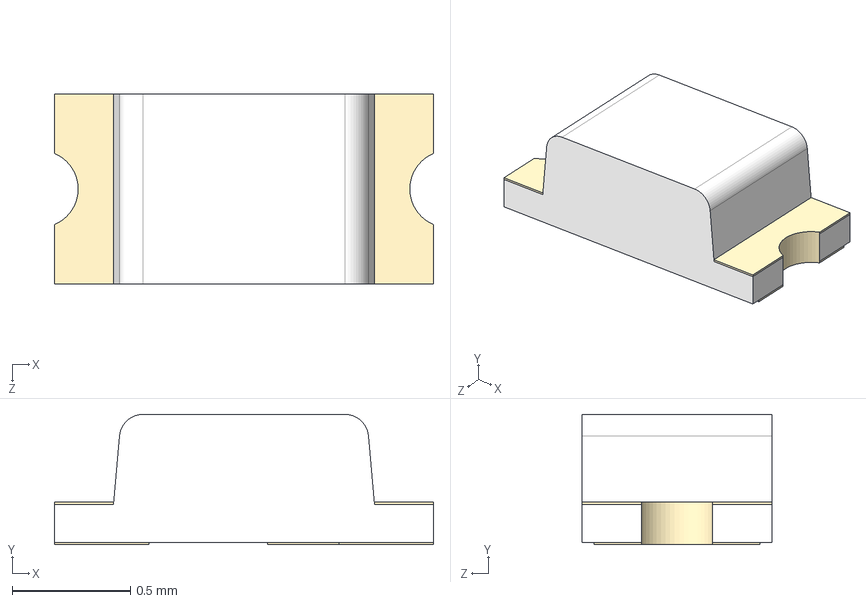
[picture p108: CAD file, 2026-08-24]
KiCad/ESP_Breadboard/LED_light/LTST-C191KGKT.step
1.60 x 0.55 x 0.8 mm
