brbeardm/PelletPirate/KiCad/ESP_Breadboard/RC0805FR-Sense-Resistor-LED/RC0805FR-072R49L.step

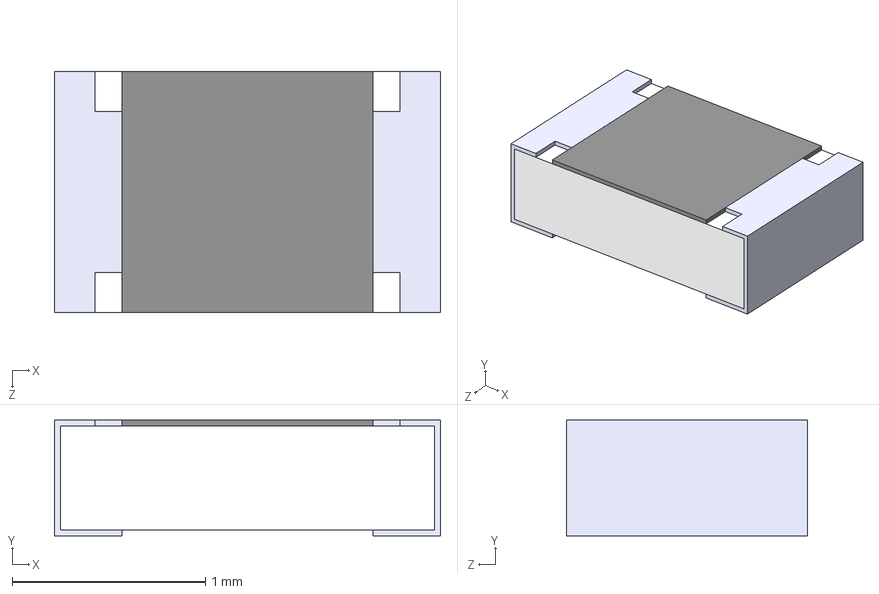
[picture p109: CAD file, 2026-05-22]
KiCad/ESP_Breadboard/RC0805FR-Sense-Resistor-LED/RC0805FR-072R49L.step
2.00 x 0.6 x 1.25 mm
