brbeardm/PelletPirate/KiCad/ESP_Breadboard/USB_Socket/USB4105-GF-A.step

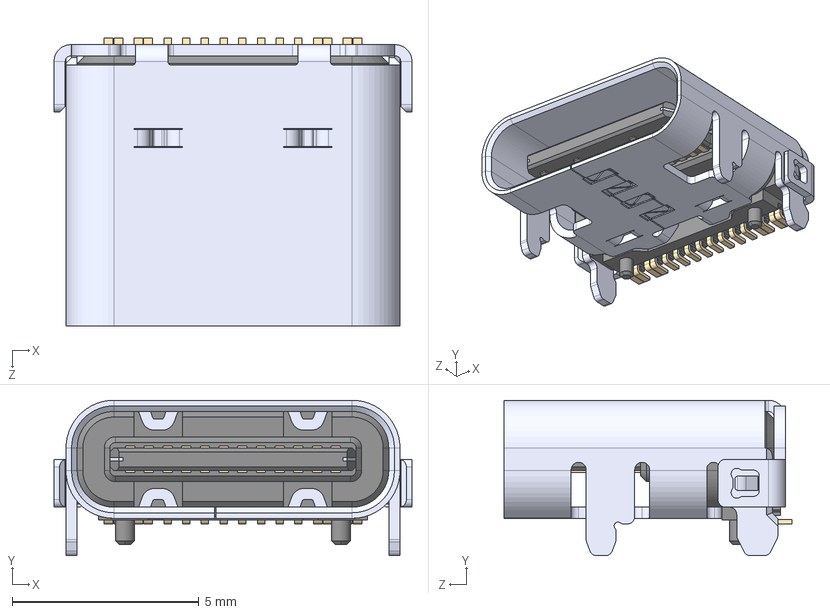
[picture p110: CAD file, 2026-08-24]
KiCad/ESP_Breadboard/USB_Socket/USB4105-GF-A.step
9.58 x 4.16 x 7.71 mm
