brbeardm/PelletPirate/KiCad/ESP_Breadboard/USBC6-2SC6/USBLC6-2SC6.step

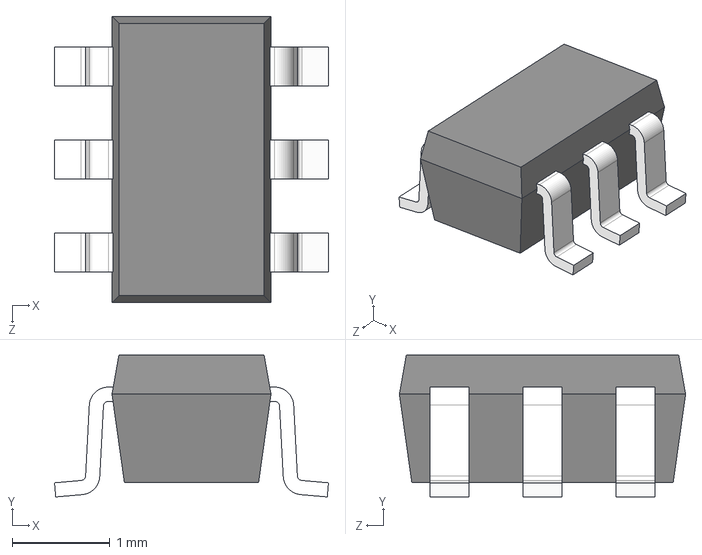
[picture p111: CAD file, 2026-08-24]
KiCad/ESP_Breadboard/USBC6-2SC6/USBLC6-2SC6.step
2.80 x 1.45 x 2.92 mm
