brbeardm/PelletPirate/KiCad/FPC_for_PCB_to_LCD_RevH/FPC_Connector_HiRose/FH26W-39S-0.3SHW_60_.step

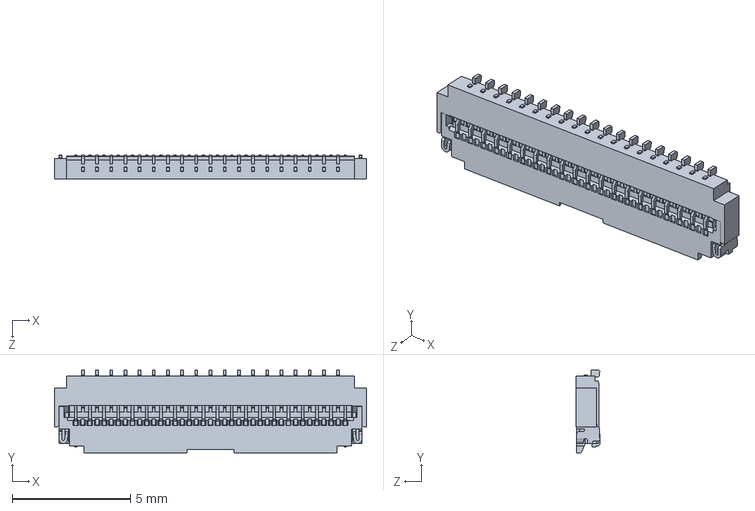
[picture p112: CAD file, 2026-05-22]
KiCad/FPC_for_PCB_to_LCD_RevH/FPC_Connector_HiRose/FH26W-39S-0.3SHW_60_.step
13.2 x 3.50 x 1.00 mm
