brbeardm/PelletPirate/KiCad/FPC_for_PCB_to_LCD_RevH/FPCWay_REV_H_Package/PCB_to_LCD_FPC_REV_H_GoldenFinger.dxf

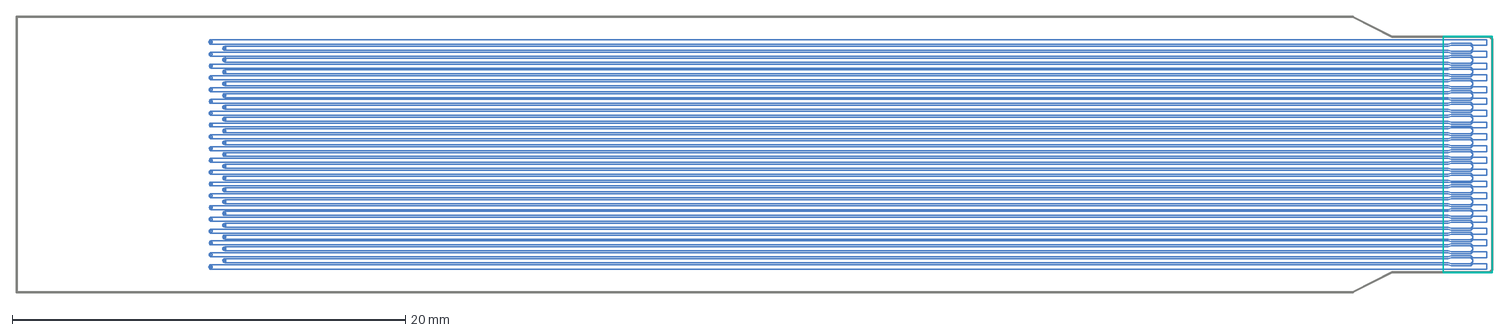
[picture p113: CAD file, 2026-08-30]
KiCad/FPC_for_PCB_to_LCD_RevH/FPCWay_REV_H_Package/PCB_to_LCD_FPC_REV_H_GoldenFinger.dxf
75.1 x 14.0 mm
