brbeardm/PelletPirate/KiCad/PelletPirate_V4/2.2uH_Murata_1212_footprint/LQH3NPH2R2MMEL.step

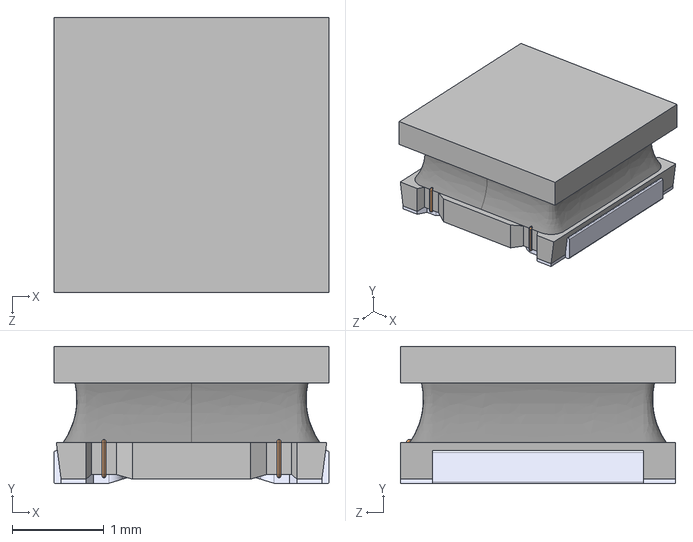
[picture p114: CAD file, 2026-05-22]
KiCad/PelletPirate_V4/2.2uH_Murata_1212_footprint/LQH3NPH2R2MMEL.step
3.00 x 1.50 x 3.00 mm
