brbeardm/PelletPirate/KiCad/PelletPirate_V4/3.3uH_Inductor_Murata/LQH43PN3R3M26L.step

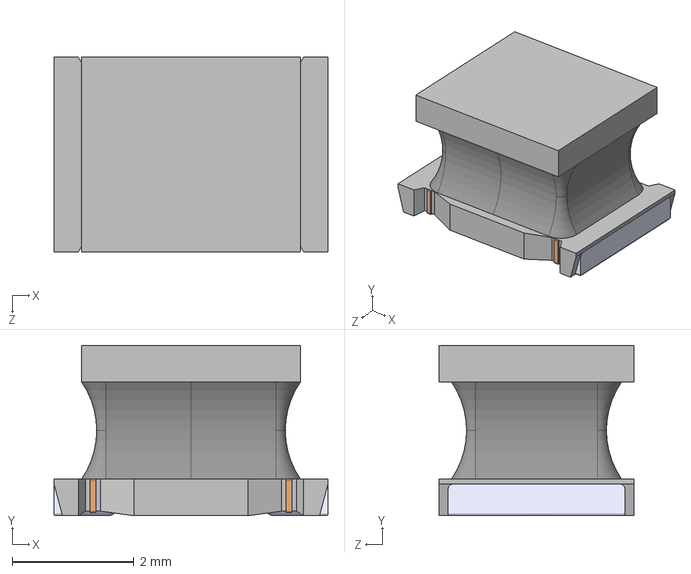
[picture p115: CAD file, 2026-05-22]
KiCad/PelletPirate_V4/3.3uH_Inductor_Murata/LQH43PN3R3M26L.step
4.50 x 2.80 x 3.20 mm
