brbeardm/PelletPirate/KiCad/PelletPirate_V4/3.5mm_Jacks/Same_Sky_SJ1-3523NG.step

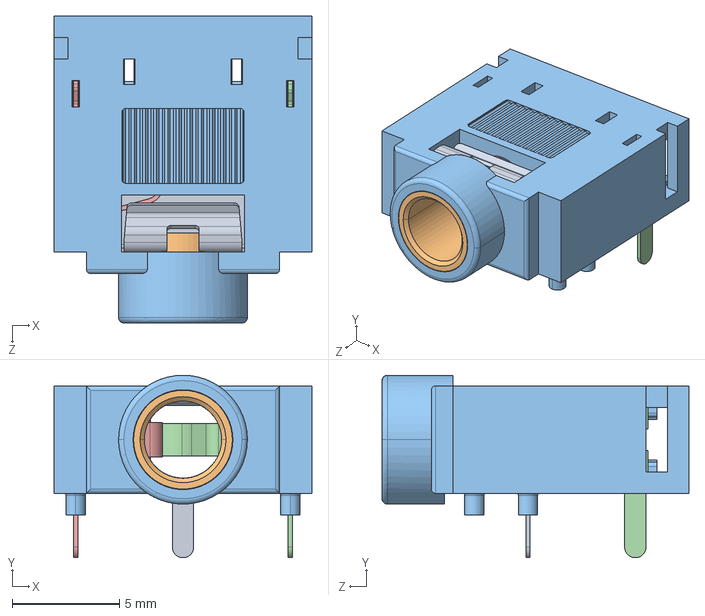
[picture p116: CAD file, 2026-08-30]
KiCad/PelletPirate_V4/3.5mm_Jacks/Same_Sky_SJ1-3523NG.step
12.0 x 8.50 x 14.3 mm
