brbeardm/PelletPirate/KiCad/PelletPirate_V4/H11AA1M_Opto_FanPulse/H11AA1M.step

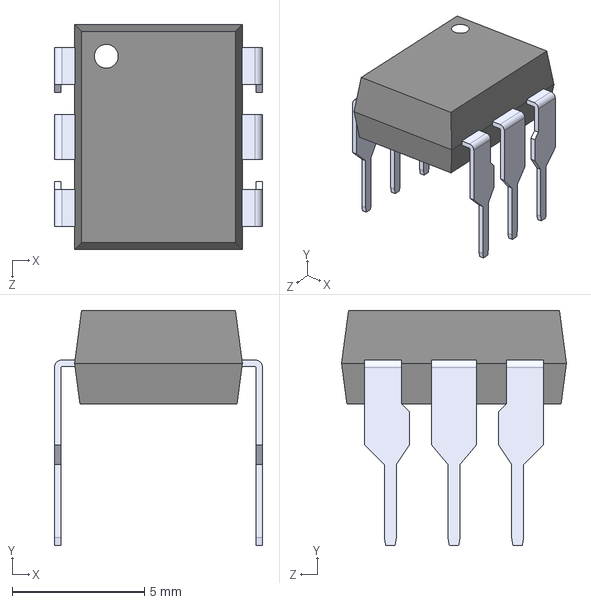
[picture p117: CAD file, 2026-05-22]
KiCad/PelletPirate_V4/H11AA1M_Opto_FanPulse/H11AA1M.step
7.87 x 8.89 x 8.51 mm
