brbeardm/PelletPirate/KiCad/PelletPirate_V4/KMR221GLFS_SMD_boot_reset_switch/KMR221GLFS.step

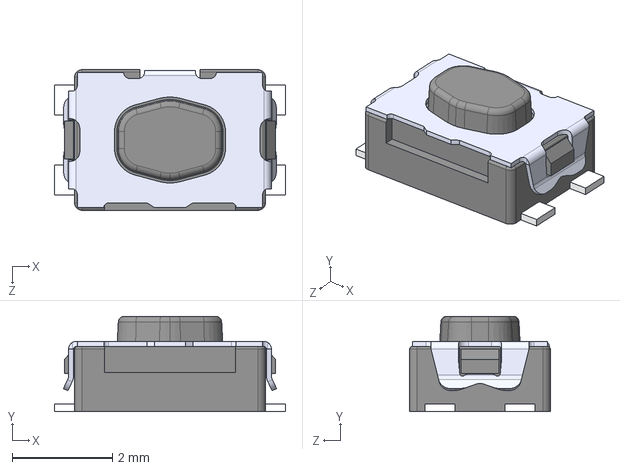
[picture p118: CAD file, 2026-08-24]
KiCad/PelletPirate_V4/KMR221GLFS_SMD_boot_reset_switch/KMR221GLFS.step
4.60 x 1.90 x 2.80 mm
