brbeardm/PelletPirate/KiCad/PelletPirate_V4/NewPBO-5F-12-try/PBO-5F-12.step

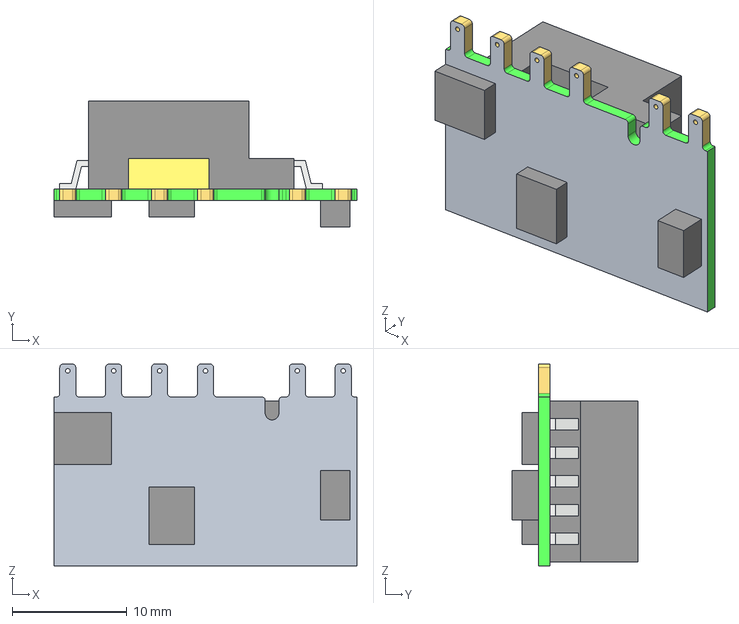
[picture p119: CAD file, 2026-05-22]
KiCad/PelletPirate_V4/NewPBO-5F-12-try/PBO-5F-12.step
26.4 x 11.0 x 17.6 mm
