brbeardm/PelletPirate/KiCad/PelletPirate_V4/SMBJ20A_PelletPirate/SMBJ20A_PelletPirate.step

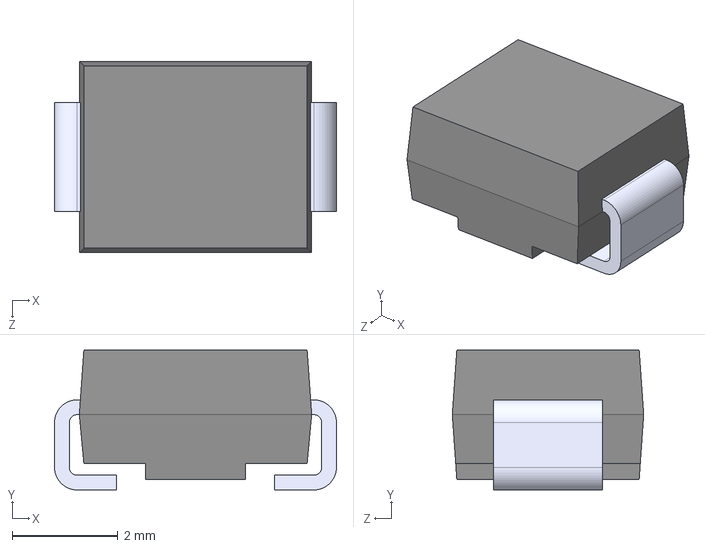
[picture p120: CAD file, 2026-05-22]
KiCad/PelletPirate_V4/SMBJ20A_PelletPirate/SMBJ20A_PelletPirate.step
5.34 x 2.65 x 3.62 mm
