brbeardm/PelletPirate/KiCad/PelletPirate_V4/SRR4028-100Y_Inductor/IND_BOURNS_SRR4028.step

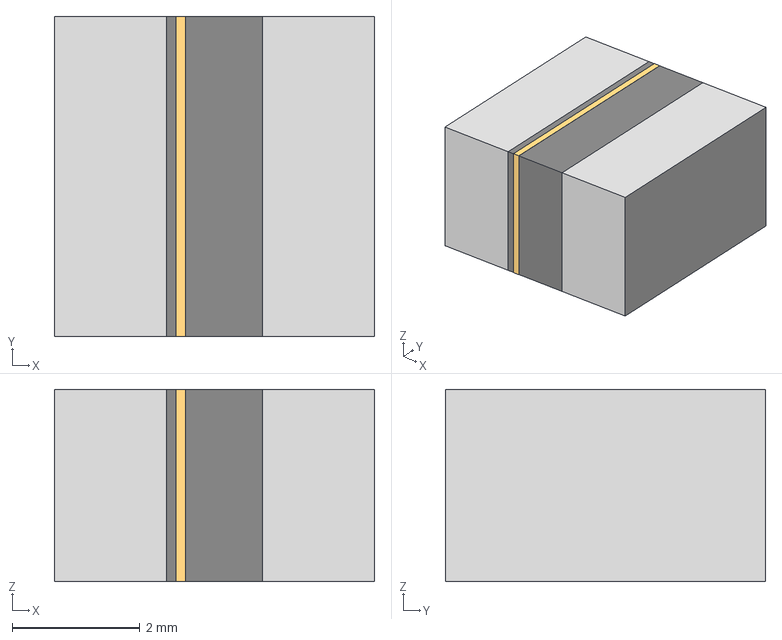
[picture p121: CAD file, 2026-08-30]
KiCad/PelletPirate_V4/SRR4028-100Y_Inductor/IND_BOURNS_SRR4028.step
5.00 x 5.01 x 3.00 mm
