brbeardm/PelletPirate/KiCad/PelletPirate_V4/STPS0540Z_Schotty Diode LED/STPS0540Z.step

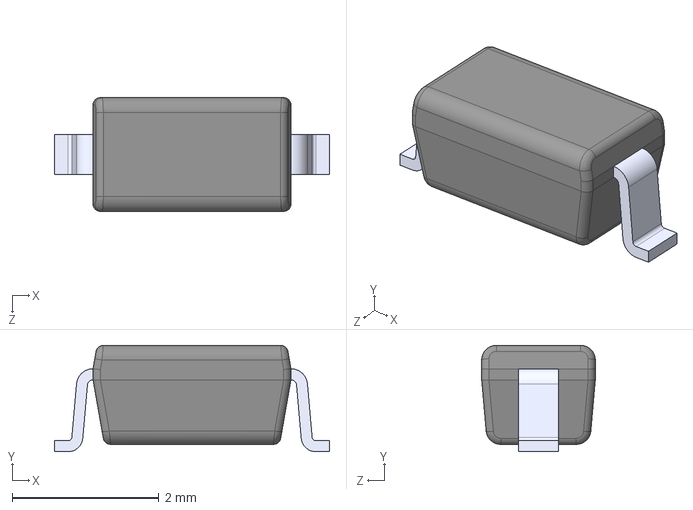
[picture p122: CAD file, 2026-05-22]
KiCad/PelletPirate_V4/STPS0540Z_Schotty Diode LED/STPS0540Z.step
3.75 x 1.45 x 1.55 mm
