brbeardm/PelletPirate/KiCad/pelletpirate_V5/HiRose_Encoder_Jack/DF13-4P-1.25DSA(25).STEP

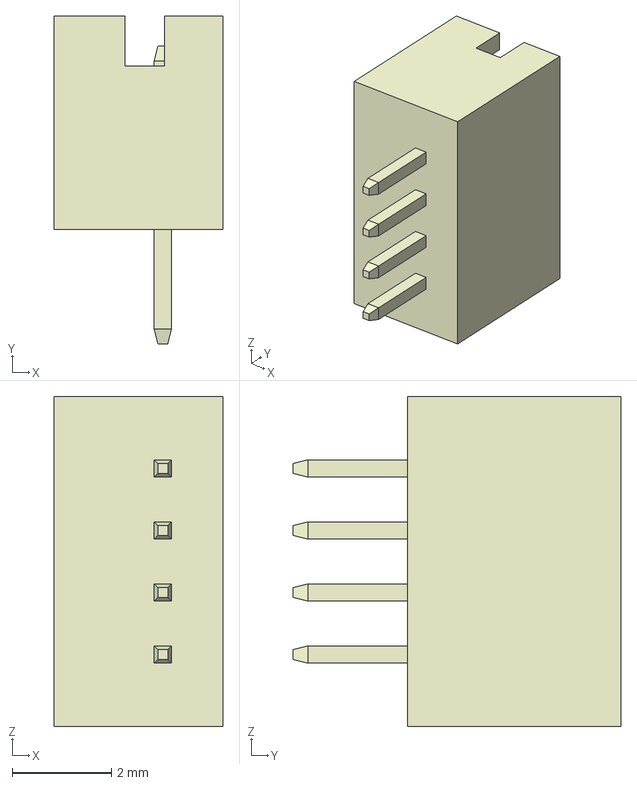
[picture p123: CAD file, 2026-08-28]
KiCad/pelletpirate_V5/HiRose_Encoder_Jack/DF13-4P-1.25DSA(25).STEP
3.40 x 6.60 x 6.65 mm
