brbeardm/PelletPirate/KiCad/pelletpirate_V5/Inductors/srr4028.stp

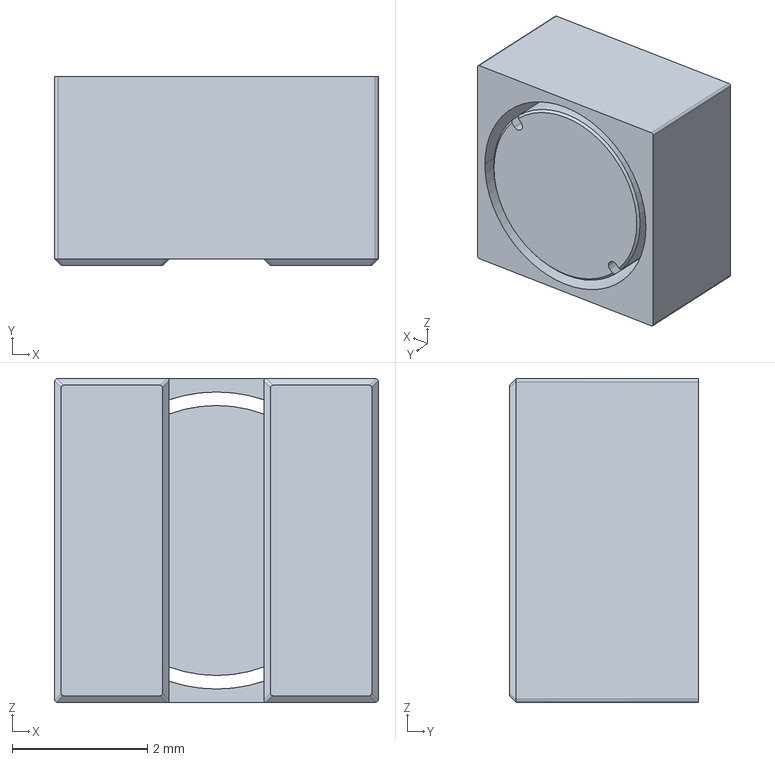
[picture p124: CAD file, 2026-08-28]
KiCad/pelletpirate_V5/Inductors/srr4028.stp
4.80 x 2.80 x 4.80 mm
