brbeardm/PelletPirate/KiCad/pelletpirate_V5/Schurter_Fuse_Holder/31-8201.stp

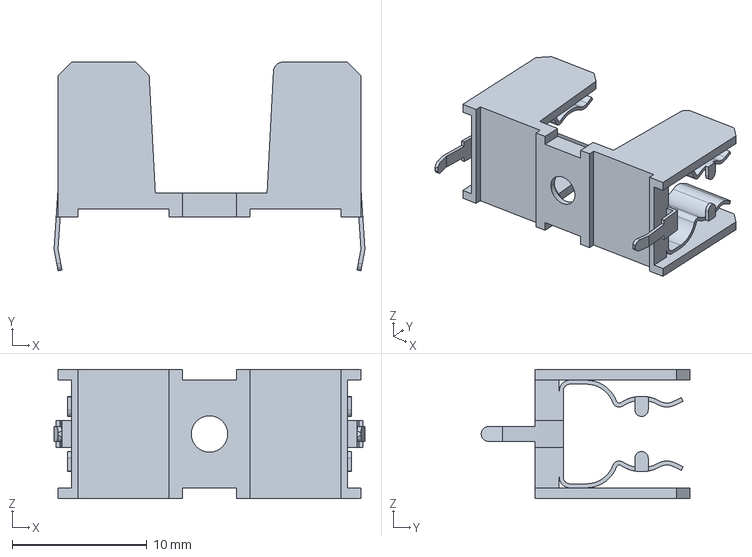
[picture p125: CAD file, 2026-08-28]
KiCad/pelletpirate_V5/Schurter_Fuse_Holder/31-8201.stp
23.1 x 15.5 x 9.60 mm
