brbeardm/PelletPirate/KiCad/pelletpirate_V5v1/Ferrite_Bead/BLM21PG221SN1D.step

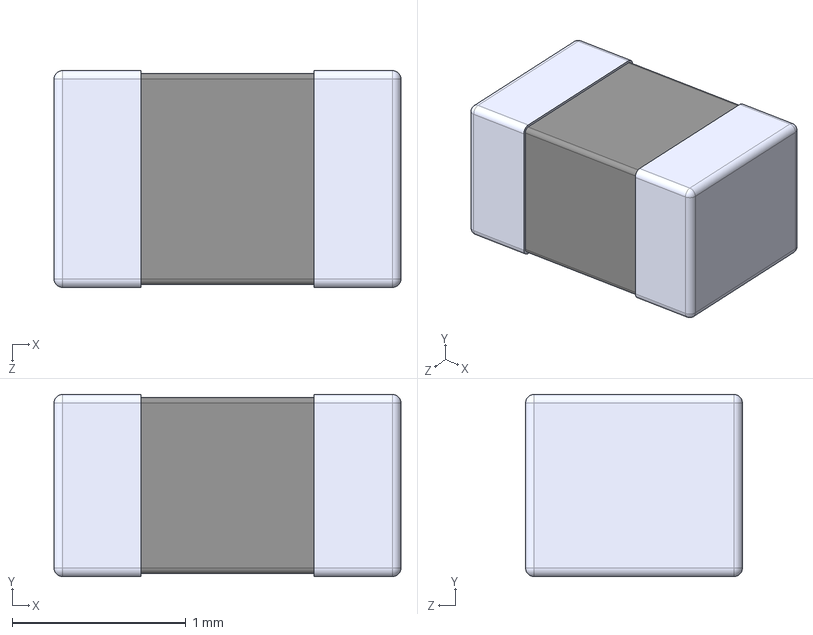
[picture p126: CAD file, 2026-08-30]
KiCad/pelletpirate_V5v1/Ferrite_Bead/BLM21PG221SN1D.step
2.00 x 1.05 x 1.25 mm
