brbeardm/PelletPirate/KiCad/pelletpirate_V5v1/Ferrite_Bead_12V/IND_BLM31PG391SN1L_MUR.step

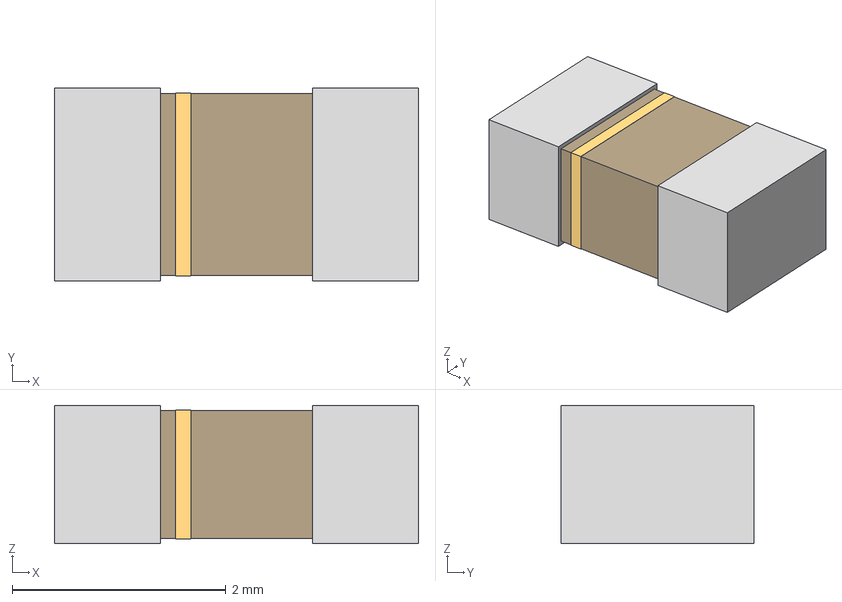
[picture p127: CAD file, 2026-08-30]
KiCad/pelletpirate_V5v1/Ferrite_Bead_12V/IND_BLM31PG391SN1L_MUR.step
3.40 x 1.80 x 1.29 mm
