brbeardm/PelletPirate/KiCad/pelletpirate_V5v1/Ferrite_Bead_12V_Flyman/BLM31PG601SN1L_flyman.step

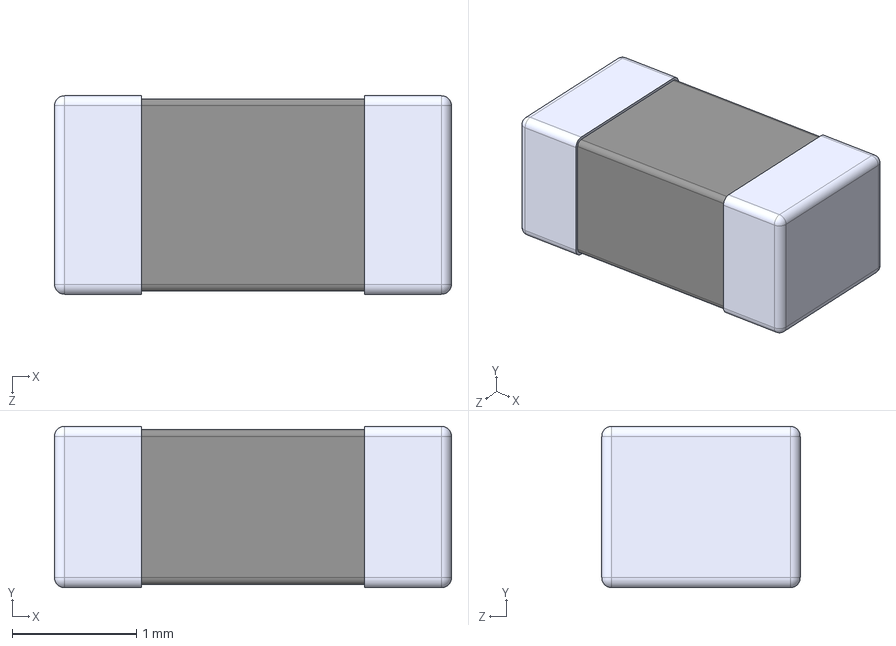
[picture p128: CAD file, 2026-08-30]
KiCad/pelletpirate_V5v1/Ferrite_Bead_12V_Flyman/BLM31PG601SN1L_flyman.step
3.20 x 1.30 x 1.60 mm
