brbeardm/PelletPirate/KiCad/pelletpirate_V5v1/USB_try2/usb4145-03-0170-c.stp

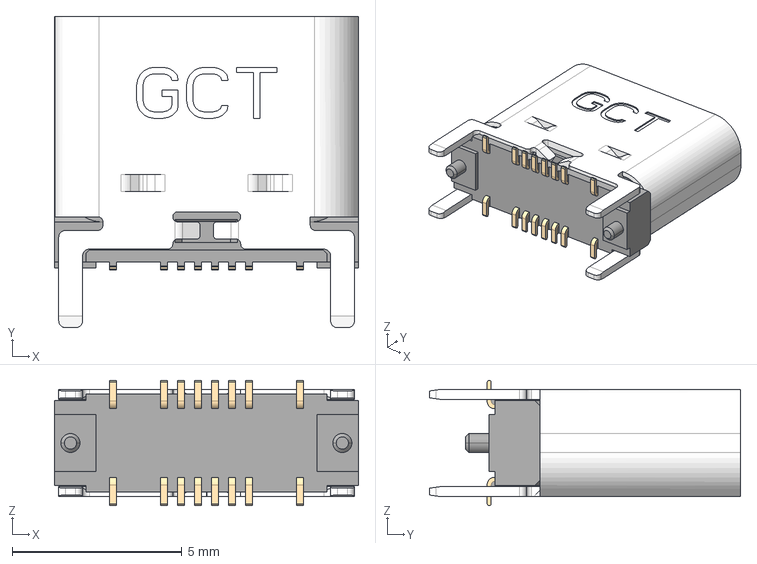
[picture p129: CAD file, 2026-08-27]
KiCad/pelletpirate_V5v1/USB_try2/usb4145-03-0170-c.stp
8.95 x 9.16 x 3.69 mm
