brbeardm/PelletPirate/KiCad/PelletPirate_V4/3.5mm_Jacks/SJ1-3523NG.step

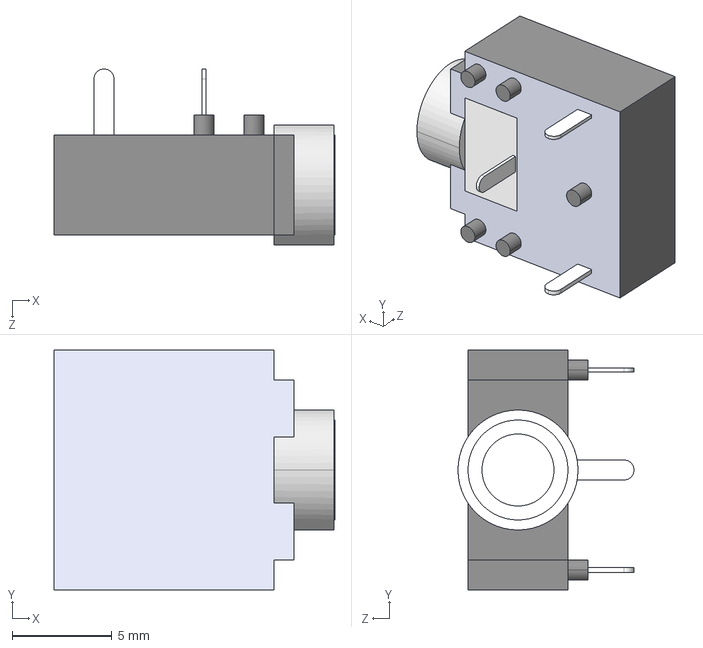
[picture p130: CAD file, 2026-05-22]
KiCad/PelletPirate_V4/3.5mm_Jacks/SJ1-3523NG.step
14.0 x 12.0 x 8.80 mm
