brbeardm/PelletPirate/KiCad/PelletPirate_V4/USB_try2/USB4105-GF-A--3DModel-STEP-510211.STEP

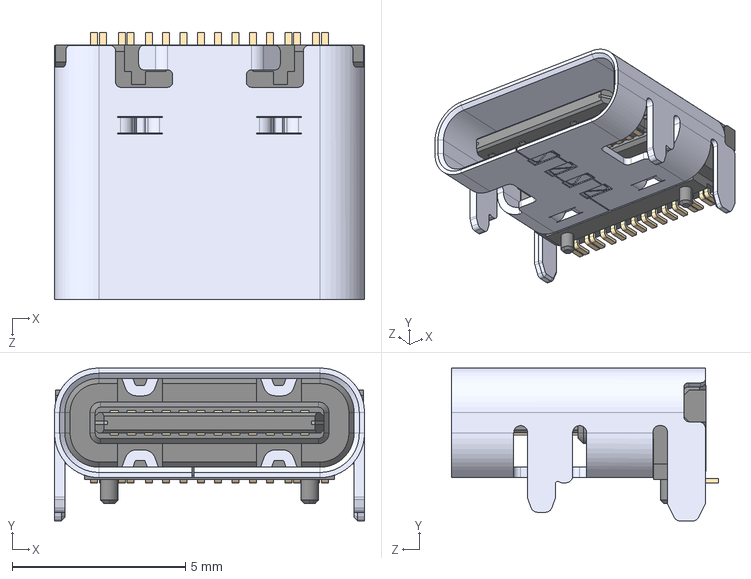
[picture p131: CAD file, 2026-08-24]
KiCad/PelletPirate_V4/USB_try2/USB4105-GF-A--3DModel-STEP-510211.STEP
8.94 x 4.41 x 7.71 mm
