brbeardm/PelletPirate/KiCad/pelletpirate_V5v1/USB_try2/usb4145-03-0070-c.stp

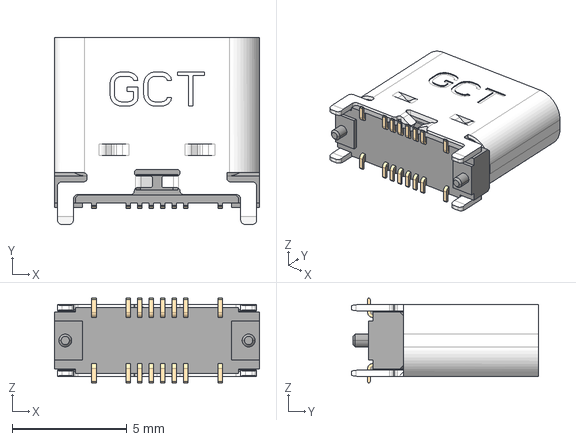
[picture p132: CAD file, 2026-08-26]
KiCad/pelletpirate_V5v1/USB_try2/usb4145-03-0070-c.stp
8.95 x 8.16 x 3.69 mm
