brbeardm/PelletPirate/(list of files, cad)

Other CAD files:
KiCad/ESP_Breadboard/LED_Driver/TPS61165DBVR.step
KiCad/FPC_for_PCB_to_LCD_RevG/FPCWay_REV_H_Package/PCB_to_LCD_FPC_REV_H_GoldenFinger.dxf
KiCad/PelletPirate_V3/3.3uH_Inductor/WE-HCI_7040.step
KiCad/PelletPirate_V3/Bourns_Encoder/PEC11R-4215F-S0024.step
KiCad/PelletPirate_V3/Buck_3.3V/TPS562201DDCR.step
KiCad/PelletPirate_V3/HiRose/FH26-39S-0.3SHW_05_.step
KiCad/PelletPirate_V3/LED_Driver/TPS61165DBVR.step
KiCad/PelletPirate_V3/NCP3065 LED Boost Driver/NCP3065DR2G.step
KiCad/PelletPirate_V4/Buck_3.3V/TPS562201DDCR.step
KiCad/PelletPirate_V4/LED_Driver/TPS61165DBVR.step
KiCad/PelletPirate_V4/MAX_31865ATP+/MAX31865ATP+.STEP
KiCad/PelletPirate_V4/archived_symbols_footprints_not_used/3.3uH_Inductor/WE-HCI_7040.step
KiCad/PelletPirate_V4/archived_symbols_footprints_not_used/Bourns_Encoder/PEC11R-4215F-S0024.step
KiCad/PelletPirate_V4/archived_symbols_footprints_not_used/HiRose/FH26-39S-0.3SHW_05_.step
KiCad/PelletPirate_V4/archived_symbols_footprints_not_used/NCP3065 LED Boost Driver/NCP3065DR2G.step
KiCad/pelletpirate_V5v1/SameSky_Screw_Terminal/TB002-500-02BE.step
