brbeardm/PelletPirate/KiCad/FPC_for_PCB_to_LCD_RevC/README_MANUFACTURING.txt

DO NOT RELEASE TO FABRICATION UNTIL FPCWAY DFM CONFIRMS:
- J1 exact FH26W-39S-0.3SHW(60) land pattern and bottom-contact orientation.
- Male tongue per Hirose recommended FPC: F=12.0 mm, C=11.4 mm, B=10.8 mm, 39 x 0.30 mm.
- Finished male mating thickness 0.20 +/-0.03 mm.
- Contact side and physical Pin-1 orientation at BOTH ends.
- Electrical continuity intent J1-1 -> male-1 ... J1-39 -> male-39.
- 100% continuity and shorts test after assembly.
