brbeardm/PelletPirate/KiCad/FPC_for_PCB_to_LCD_RevF/README_MANUFACTURING.txt

FPCWAY ENGINEERING REVIEW REQUIRED
1. Functional orientation is mandatory: J1 connector body on Side A/front; exposed male mating contacts on Side B/back at opposite end.
2. Please advise whether this can be manufactured as 1-layer flex while preserving that functional orientation. If not, quote as 2-layer flex.
3. If 2-layer: approve/adjust 39-via transition in stiffened connector region; supplier may optimize via size/spacing.
4. Male tongue must mate with FH26W-39S-0.3SHW family: 39 positions, 0.30-mm pitch, F=12.0 mm, C=11.4 mm, B=10.8 mm, finished t=0.20 +/-0.03 mm.
5. Verify J1 exact footprint and bottom-contact orientation against Hirose current drawing.
6. Verify physical Pin 1 at J1 maps electrically to Pin 1 at male tongue; same for all 39 pins.
7. 100% continuity + shorts test after assembly.
8. Main body 14 mm; symmetric taper to 12 mm mating tongue.
9. Proposed SUS/PI stiffeners to be finalized by FPCWay DFM.
