brbeardm/PelletPirate/3D-printer-stencils/images/soldermask.jpg

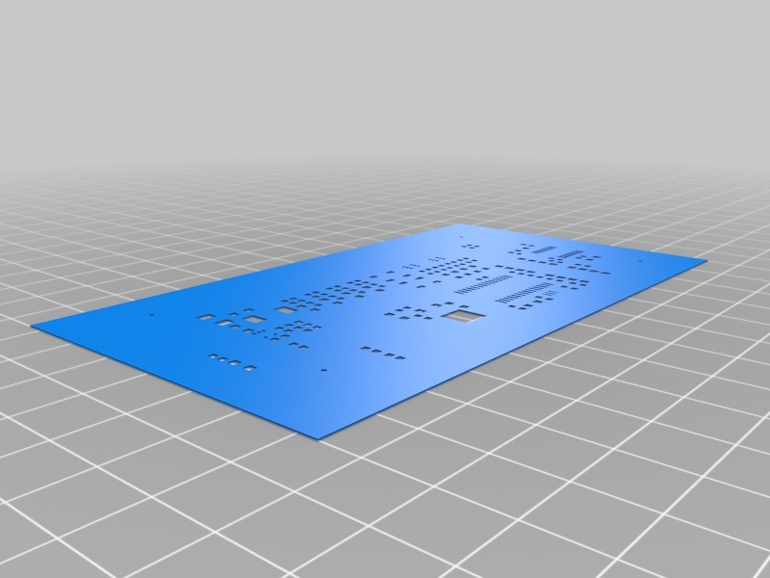
3D-printer-stencils/images/soldermask.jpg
