brbeardm/PelletPirate/KiCad/FPC_for_PCB_to_LCD_RevH/_dxf_verify.png

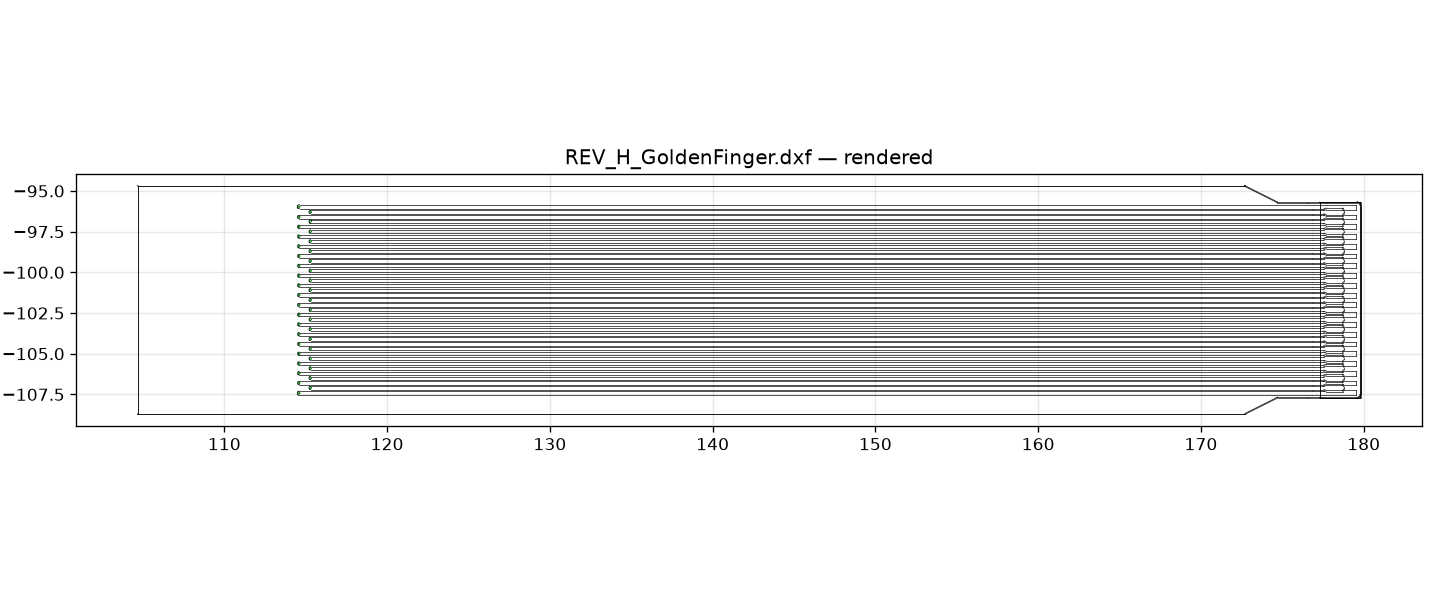
KiCad/FPC_for_PCB_to_LCD_RevH/_dxf_verify.png
