brbeardm/PelletPirate/rainbow_hunt/captures/bench_pickup_calibration.png

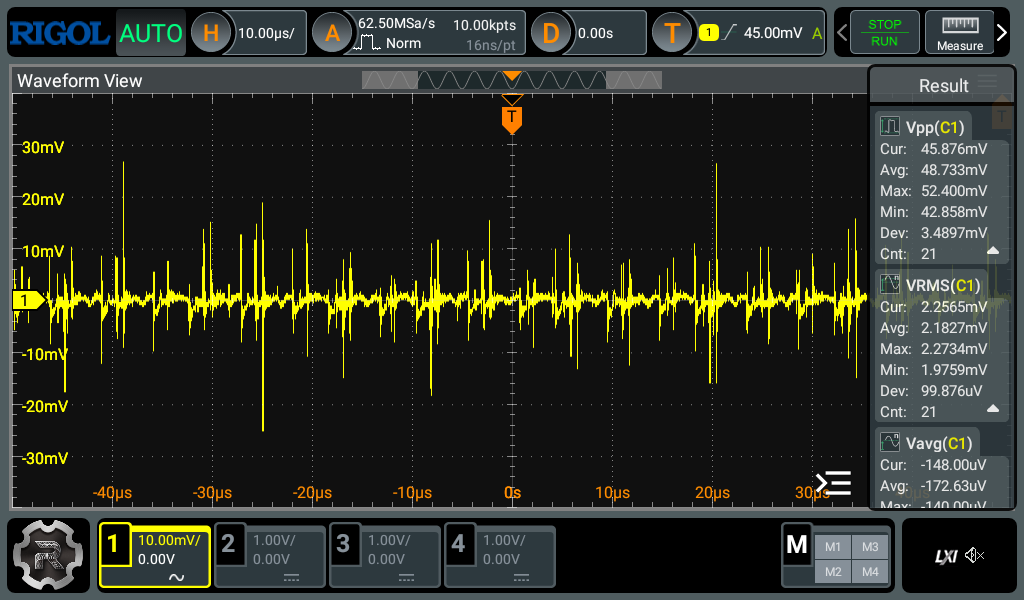
rainbow_hunt/captures/bench_pickup_calibration.png
