brbeardm/PelletPirate/rainbow_hunt/captures/sclk_tap_verify.png

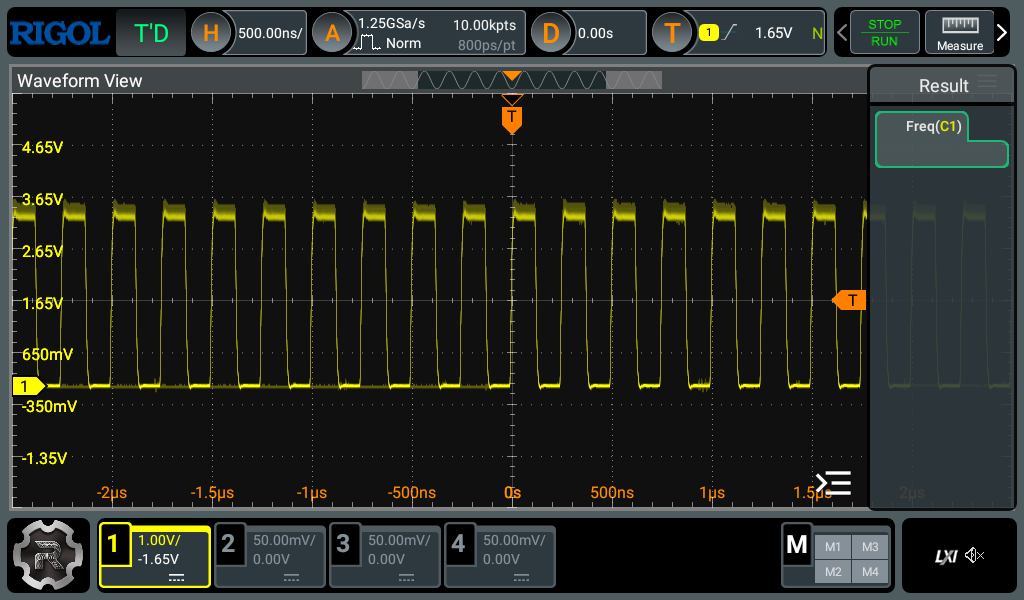
rainbow_hunt/captures/sclk_tap_verify.png
