brbeardm/PelletPirate/rainbow_hunt/captures/smoke_test.png

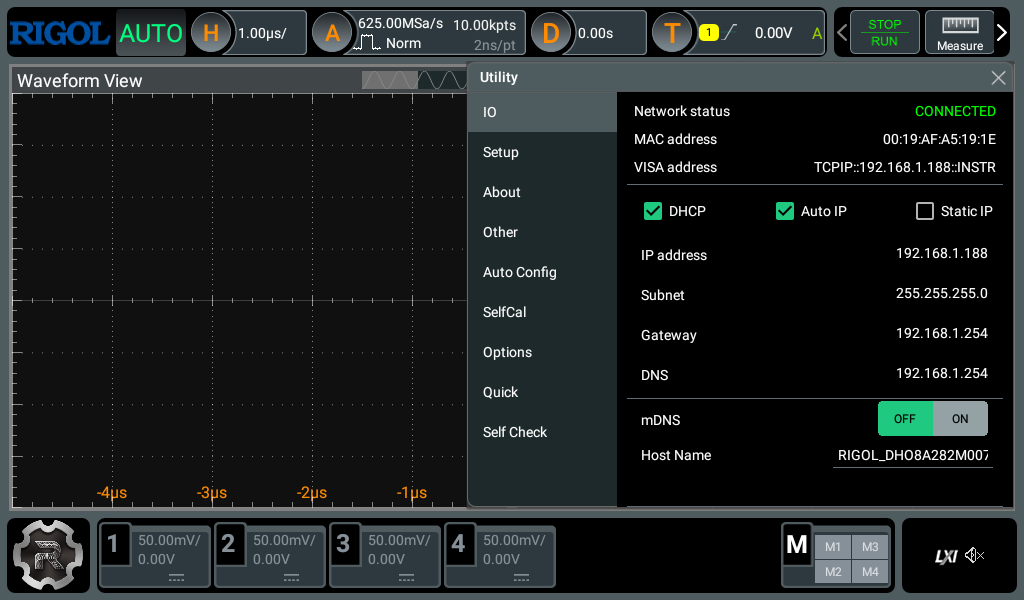
rainbow_hunt/captures/smoke_test.png
