brbeardm/PelletPirate/KiCad/PelletPirate_V4/PCBWay/PelletPirate_V4_Assembly_Bottom.pdf

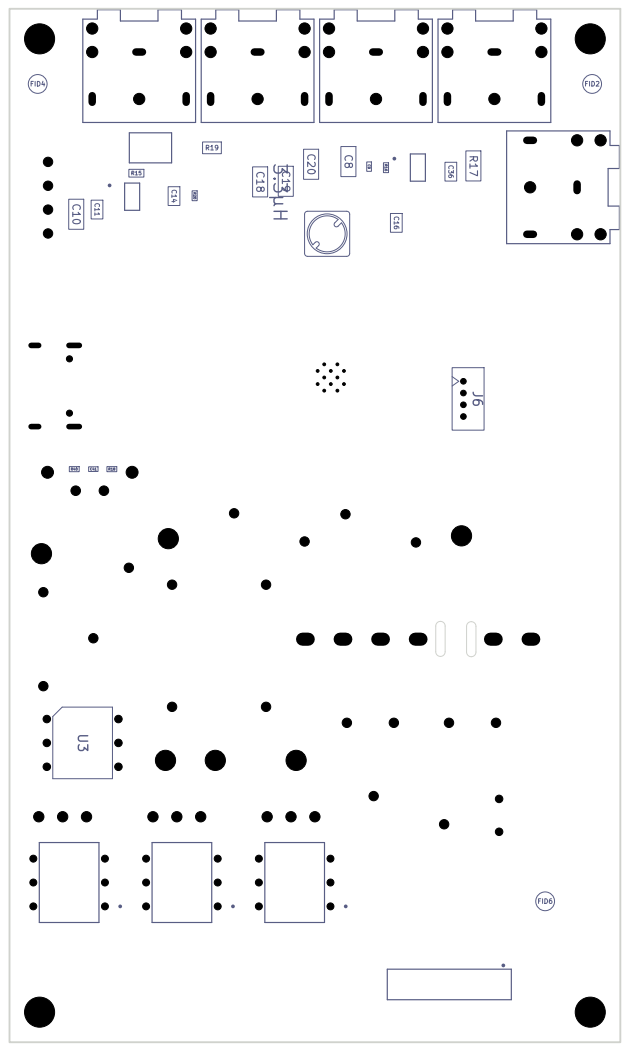
[picture p143: page 1]
