brbeardm/PelletPirate/KiCad/PelletPirate_V4/PCBWay/PelletPirate_V4_Assembly_Top.pdf

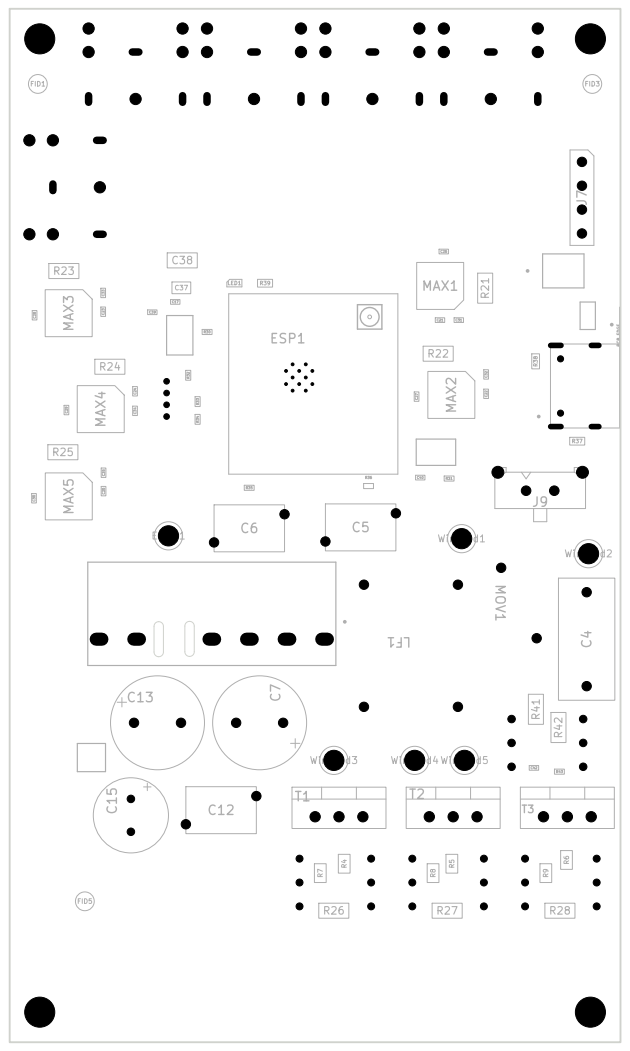
[picture p144: page 1]
