brbeardm/PelletPirate/KiCad/PelletPirate_V3/PelletPirateSchematic.pdf

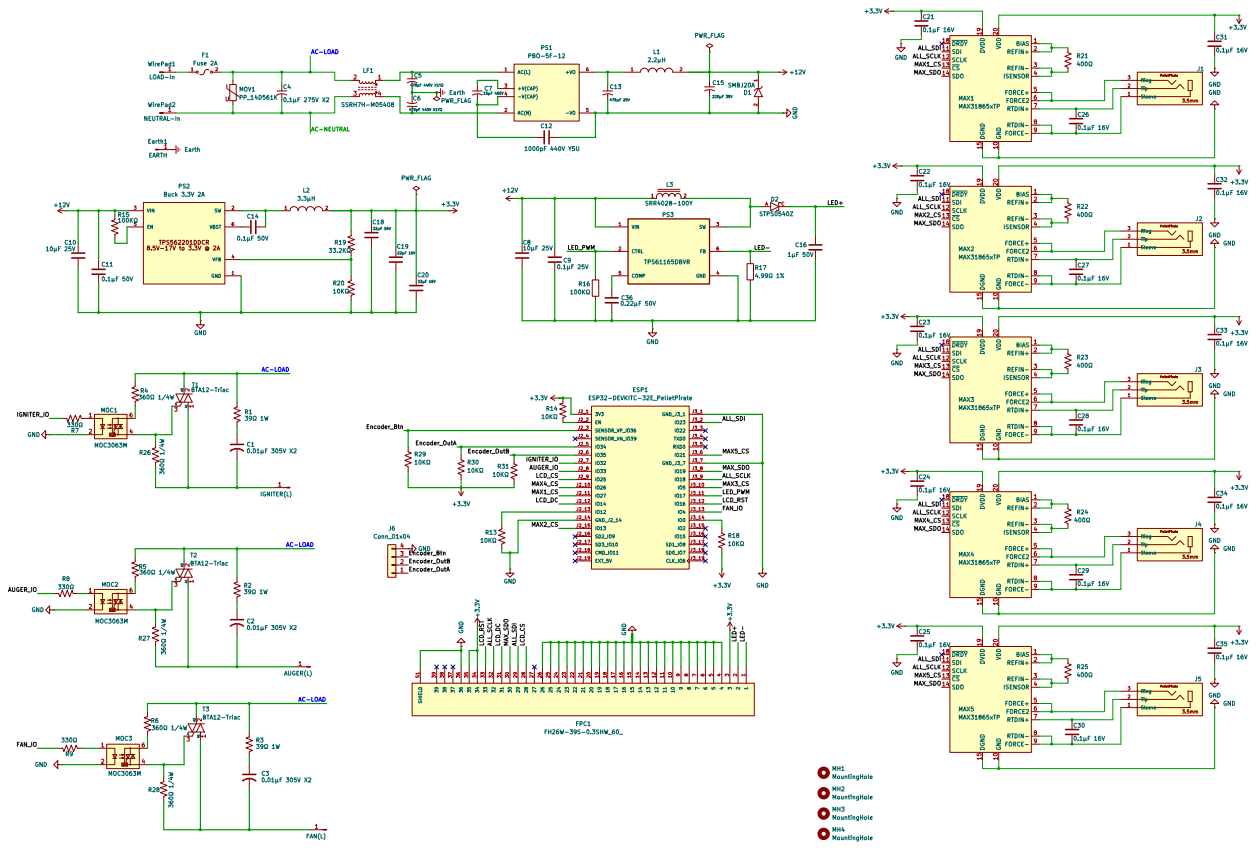
[picture p145: page 1]
