brbeardm/PelletPirate/pelletpirate_ESP/components/hx8357d/boot_splash.c

// Boot splash — draws text directly to the HX8357D framebuffer
// No LVGL dependency. Uses a minimal built-in 8x16 bitmap font.
// Called immediately after hx8357d_init() for instant visual feedback.

#include "hx8357d.h"
#include <string.h>

// Minimal 8x16 bitmap font — just the characters we need
// Each character is 16 bytes (16 rows of 8 pixels, MSB = leftmost pixel)
static const uint8_t font_8x16[][16] = {
    // Space (32)
    [0] = {0x00,0x00,0x00,0x00,0x00,0x00,0x00,0x00,0x00,0x00,0x00,0x00,0x00,0x00,0x00,0x00},
    // '.' (1)
    [1] = {0x00,0x00,0x00,0x00,0x00,0x00,0x00,0x00,0x00,0x00,0x00,0x18,0x18,0x00,0x00,0x00},
    // 'P' (2)
    [2] = {0x00,0x00,0xFC,0x66,0x66,0x66,0x7C,0x60,0x60,0x60,0x60,0xF0,0x00,0x00,0x00,0x00},
    // 'e' (3)
    [3] = {0x00,0x00,0x00,0x00,0x00,0x3C,0x66,0x66,0x7E,0x60,0x66,0x3C,0x00,0x00,0x00,0x00},
    // 'l' (4)
    [4] = {0x00,0x00,0x38,0x18,0x18,0x18,0x18,0x18,0x18,0x18,0x18,0x3C,0x00,0x00,0x00,0x00},
    // 't' (5)
    [5] = {0x00,0x00,0x00,0x08,0x18,0x3E,0x18,0x18,0x18,0x18,0x1A,0x0C,0x00,0x00,0x00,0x00},
    // 'i' (6)
    [6] = {0x00,0x00,0x00,0x18,0x18,0x00,0x38,0x18,0x18,0x18,0x18,0x3C,0x00,0x00,0x00,0x00},
    // 'r' (7)
    [7] = {0x00,0x00,0x00,0x00,0x00,0x6C,0x76,0x60,0x60,0x60,0x60,0xF0,0x00,0x00,0x00,0x00},
    // 'a' (8)
    [8] = {0x00,0x00,0x00,0x00,0x00,0x3C,0x06,0x3E,0x66,0x66,0x66,0x3B,0x00,0x00,0x00,0x00},
    // 'o' (9)
    [9] = {0x00,0x00,0x00,0x00,0x00,0x3C,0x66,0x66,0x66,0x66,0x66,0x3C,0x00,0x00,0x00,0x00},
    // 'd' (10)
    [10]= {0x00,0x00,0x06,0x06,0x06,0x3E,0x66,0x66,0x66,0x66,0x66,0x3B,0x00,0x00,0x00,0x00},
    // 'n' (11)
    [11]= {0x00,0x00,0x00,0x00,0x00,0x6C,0x76,0x66,0x66,0x66,0x66,0x66,0x00,0x00,0x00,0x00},
    // 'g' (12)
    [12]= {0x00,0x00,0x00,0x00,0x00,0x3B,0x66,0x66,0x66,0x3E,0x06,0x66,0x3C,0x00,0x00,0x00},
    // 'L' (13)
    [13]= {0x00,0x00,0xF0,0x60,0x60,0x60,0x60,0x60,0x60,0x62,0x66,0xFE,0x00,0x00,0x00,0x00},
    // 'B' (14)
    [14]= {0x00,0x00,0xFC,0x66,0x66,0x66,0x7C,0x66,0x66,0x66,0x66,0xFC,0x00,0x00,0x00,0x00},
    // 'V' (15)
    [15]= {0x00,0x00,0xC3,0xC3,0xC3,0x66,0x66,0x66,0x3C,0x3C,0x18,0x18,0x00,0x00,0x00,0x00},
    // '2' (16)
    [16]= {0x00,0x00,0x3C,0x66,0x66,0x06,0x0C,0x18,0x30,0x60,0x66,0x7E,0x00,0x00,0x00,0x00},
};

// Character lookup table: maps ASCII to font index
static int char_to_idx(char c) {
    switch(c) {
        case ' ': return 0;
        case '.': return 1;
        case 'P': return 2;
        case 'e': return 3;
        case 'l': return 4;
        case 't': return 5;
        case 'i': return 6;
        case 'r': return 7;
        case 'a': return 8;
        case 'o': return 9;
        case 'd': return 10;
        case 'n': return 11;
        case 'g': return 12;
        case 'L': return 13;
        case 'B': return 14;
        case 'V': return 15;
        case '2': return 16;
        default:  return 0;
    }
}

// Draw a single character at pixel position (x, y) with scale factor
static void draw_char(char c, int x, int y, int scale, uint16_t fg_color, uint16_t bg_color)
{
    int idx = char_to_idx(c);
    const uint8_t *glyph = font_8x16[idx];

    for (int row = 0; row < 16; row++) {
        for (int col = 0; col < 8; col++) {
            uint16_t color = (glyph[row] & (0x80 >> col)) ? fg_color : bg_color;
            if (scale == 1) {
                hx8357d_fill_rect(x + col, y + row, 1, 1, color);
            } else {
                hx8357d_fill_rect(x + col * scale, y + row * scale, scale, scale, color);
            }
        }
    }
}

// Draw a string at pixel position (x, y) with scale factor
static void draw_string(const char *str, int x, int y, int scale, uint16_t fg_color, uint16_t bg_color)
{
    int cx = x;
    for (int i = 0; str[i]; i++) {
        draw_char(str[i], cx, y, scale, fg_color, bg_color);
        cx += 8 * scale;
    }
}

void hx8357d_boot_splash(void)
{
    // Black background
    hx8357d_fill_screen(0x0000);

    // "PelletPirate" centered, scale 2 (16x32 per char)
    // 12 chars × 16px = 192px wide, centered in 320px → x=64
    uint16_t orange = HX8357D_RGB565(255, 107, 53);  // PelletPirate orange
    draw_string("PelletPirate", 64, 180, 2, orange, 0x0000);

    // "V2" below it
    draw_string("V2", 144, 220, 2, 0xFFFF, 0x0000);

    // "Loading..." at bottom
    draw_string("Loading...", 100, 300, 2, 0x8410, 0x0000);  // gray text
}
