brbeardm/PelletPirate/(commit log)

2026-05-22 PelletPirate V2 ESP32 — initial commit
    Complete project state as of 2026-05-21:
    - ESP-IDF project with LVGL v9.5 UI framework
    - HX8357D LCD driver (320x480 SPI, working on breadboard)
    - Boot splash with PelletPirate logo animation
    - Main menu with 7 items and rotary encoder navigation
    - COOK screen with grill temp, probe bars, status icons
    - PID controller and MAX31865 RTD driver ported from Particle
    - Encoder driver with quadrature decode
    - Grill state data model
    - Original Particle Photon firmware (PelletPirateC++_WB)
    - KiCad V2 PCB schematics and layouts
    - BOM and 3D printer stencil files
    [.kicad_sch, ESP32-DEVKITC-32E.step, FFC_FPC_to_DIP_BOM.csv, FH26-39S-0.3SHW_05_.step, FH26W-39S-0.3SHW_60_.step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]
2026-05-24 Menu system rebuild matching mockups
    - Main menu: 6 items + Cook Dashboard, in-place target temp digit editing
    - START NOW/STOP NOW dynamic label based on ignite state
    - Cook Mode grayed out when in Off/Ignite
    - Set Probes wizard: tabs → target → meat type → alarm → alarm type
    Two-column layout, probe info display, OFF alarm option
    - Cook Dashboard: nav/adjust modes, ±5°F target, probe rows with alarm info
    - Ignite: two-step confirmation, instant stop from main menu
    - Encoder: detent scaling (÷2), button debounce, direct polling flag
    - Fixed LVGL theme padding (lv_obj_remove_style_all on all screens)
    - Updated grill_state: SUPER_SMOKE, REIGNITE modes, alarm_temp/alarm_type
    Co-A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
    [PelletPirate_V2.kicad_sch]
2026-05-24 Probe 3-level nav, color fix, font/focus polish
    - Fixed colors: MADCTL 0xC0 (no BGR), panel natively BGR
    - Probe menu: 3-level scroll (L1: probes+Main, L2: Target/Alarm/Save, L3: digit/list editing)
    - Inverted digit boxes: active digit orange bg/black text
    - Target=0 skips meat/alarm (probe disabled), Alarm=OFF skips alarm type
    - Save grayed in L1, solid orange when active after workflow
    - Fixed float formatting: snprintf+lv_label_set_text (LVGL %f broken on ESP32)
    - Cook Mode font bumped to montserrat_20 on all pages
    - Focus style: solid orange bg + white text on Main/Save buttons
    - Disabled LVGL default theme to remove blue cursor artifact
    - Dashboard: nav/adjust two-mode encoder with visu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
    [hx8357d.c, main.c, ui.c, ui_cook_mode.c, ui_dashboard.c, ui_ignite.c, ui_main_menu.c, ui_set_probes.c]
2026-05-25 Dashboard ET/EST, NVS persistence, menu polish
    - Cook Dashboard: ET/EST progress bars with rolling average estimation
    Green bar = elapsed, gray = remaining, black text for contrast
    - NVS persistence: probe configs and grill target survive reboots
    Saves on every Set Target, Set Alarm, and Dashboard ±5° confirm
    - COOK DASHBOARD moved into main menu (item #3), no bottom buttons
    - Color-coded probe info: red = alarm, bold green = goal (no labels)
    - Smaller 150x150 logo: recovered 218KB flash (95% → 76%)
    - Splash: "PelletPirate" title + logo + tagline + loading bar
    - Fixed memory leak: ui_load_screen() deletes old screen
    - Fixed encoder lockup: force reset on main menu entry
    - Fixed color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
    [grill_state.c, grill_state.h, logo_img.c, ui.c, ui.h, ui_cook_mode.c, ui_dashboard.c]
2026-07-14 IO17 backlight CTRL low at boot + IO2 heartbeat LED
    TPS61165 CTRL (IO17) driven low as the first statements of app_main so
    the backlight boost can never self-enable during boot (board 1 floated
    to ~38V open-load without this). IO2 toggled at 1 Hz by a periodic
    esp_timer as a bench alive-indicator. Includes hardware bring-up
    context notes from V2 board diagnostics.
2026-07-14 TPS61165 backlight on via LEDC + Settings brightness control
    New backlight component drives the TPS61165 CTRL pin (IO17) with LEDC
    PWM at 25 kHz (within the required 5-100 kHz dimming band). Backlight
    turns on after LCD init at the NVS-saved level (default 100%). Turning
    on from off holds CTRL low >2.5 ms first so an OVP-latched device
    restarts cleanly.
    Settings menu is no longer a stub: BRIGHTNESS row adjusts 10-100% in
    10% steps with live dimming, click to save to NVS.
    [backlight.c, backlight.h, main.c, ui_main_menu.c, ui_settings.c]
2026-07-14 Encoder quadrature decode via PCNT hardware counter
    Software polling (10ms, then 5ms) dropped quadrature states — a quick
    detent click completes all 4 edges in under 10ms, causing missed and
    doubled menu steps. PCNT counts every edge in hardware in full x4
    quadrature mode with a 1us glitch filter; Gray-code counting nets
    contact bounce to zero. STEPS_PER_DETENT corrected 2 -> 4 (one full
    cycle per detent; the old value matched a miswired A/B/C harness).
    encoder_get_diff() hands out whole detents and banks the remainder.
    Button remains on a 10ms polling task. Public API unchanged.
    [encoder.c]
2026-07-14 MAX31865 5-channel RTD driver, ported from Photon firmware
    Register logic and Callendar-Van Dusen PT100 math ported unchanged
    from PelletPirateC++_WB/src/MAX31865.cpp. ESP-IDF specifics: all five
    chips share one CS-less SPI device (mode 3, 2 MHz) on the LCD bus
    since ESP32 allows only 3 devices per host; CS pins driven manually
    as GPIOs with the bus acquired around each transaction. CS lines are
    parked high before the LCD first clocks the bus. Fixed a latent bug
    from the Photon original (low fault threshold LSB was never written).
    Sensor task reads all 5 channels every 2s into grill_state and logs.
    Channel map verified on board 2: J1=grill, J2-J5=probes 1-4, all
    five analog paths validated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
    [main.c, max31865.c, max31865.h]
2026-07-14 Actuator component: fan/auger/igniter control ported from Photon
    Control logic ported from PelletPirateC++_WB main.cpp keeping the
    field-proven behavior: auger burst cycling (cycle*u on / cycle*(1-u)
    off), START 15s/45s with auto-transition to COOK at 115F, SMOKE
    P-setting duty, COOK PID (PB=60 Ti=180 Td=45, 20s cycle, u in
    [0.15,1.0]), igniter auto-assist below 115F, 20-min igniter safety
    timeout forcing SHUTDOWN, and the shutdown burn-off rules (auger off,
    fan on 15 min, then OFF).
    Enhancements: fan burst modulation in COOK when within +/-10F of
    target (30s period, duty tied to PID output, 50% floor — zero-cross
    MOC3063 means slow burst, not kHz PWM); hard fan interlock whenever
    auger o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
    [actuator.cpp, actuator.h, main.c]
2026-07-14 Anti-surge start stagger: fan t+0, auger t+2s, igniter t+4s
    On any cold start out of OFF, auger and igniter are held back 2s and
    4s respectively so the three inrush events never stack: motor inrush
    lasts ~0.5-1s, so 2s stages let each load finish its inrush before
    the next switches on. Igniter (resistive, largest steady draw) goes
    last. Steady-state cycling is unaffected. Zero-cross triacs already
    handle sub-cycle timing, so stages are seconds, not milliseconds.
2026-07-15 Custom partition table: 1.5MB app + 2.4MB LittleFS; WiFi dashboard spec
    Factory app partition grown 1MB -> 1.5MB to fit the upcoming WiFi/HTTP
    stack (~450KB); storage partition carved for future cook logging. NVS
    offset/size unchanged so saved settings survive the reflash. Firmware
    now uses 52% of the app partition.
    wifi-dashboard-spec.md: amended local WiFi dashboard implementation
    spec — plain ESP32 target, budgets against the 1.5MB partition, alarm
    engine as prerequisite, NVS WiFi provisioning with Settings IP display
    as mDNS fallback, per-build heap reporting, explicit no-auth deferral.
    [partitions.csv]
2026-07-15 Alarm engine: probe alarms + grill temp-drop, LCD banner with hold-to-ack
    Alarm state machine lives in grill_state (single source of truth for
    LCD and the upcoming web dashboard). Probe alarms fire at the
    configured alarm temp (never on faulted 0.0F readings) and re-arm 5F
    below threshold after acknowledge. Grill temp-drop alarm arms only
    after the grill reaches the target band in a holding mode (ported from
    the Photon tempMonitorOn logic, so it cannot fire during warm-up) and
    fires 30F below target. Blinking red banner overlays lv_layer_top()
    above every screen; holding the encoder button ~1.2s acknowledges.
    Evaluated after each RTD refresh. Bench-verified: probe 4 alarm fired,
    silenced, an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
2026-07-15 WiFi dashboard slice 1 + LVGL float-format fixes
    New webui component: WiFi station (Kconfig credentials, real values in
    gitignored sdkconfig), event-driven connect with retry-forever, HTTP
    server started on got-IP. GET / serves the embedded dark-theme page
    (1.3KB, 2s polling); GET /api/status returns grill temp, target, mode,
    RSSI from grill_state. Boot is LCD-first; WiFi failure never blocks
    the grill. Verified on hardware: page live on phone and PC.
    Also fixed five latent f-degree-F displays: lv_label_set_text_fmt has
    no float support (known LVGL gotcha), replaced with snprintf in main
    menu, cook mode, set target, and set probes screens.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
    [main.c, ui_cook_mode.c, ui_main_menu.c, ui_set_probes.c, ui_set_target.c]
2026-07-15 WebSocket live updates + phone-side grill target control
    /ws endpoint (CONFIG_HTTPD_WS_SUPPORT) with a 4-client registry and a
    1Hz push task broadcasting the shared status JSON; dead clients are
    dropped on send failure. Free heap logged every 60s per the spec
    discipline. Page connects the socket with 3s auto-reconnect and a
    polling fallback, shows a live/reconnecting indicator.
    POST /api/grill-target takes the plain value, clamps to the LCD
    editor range (100-499F), writes grill_state under the mutex and
    persists via the same NVS path as the LCD. Page target row is now
    [-5] value [+5] with large touch buttons, optimistic update and 600ms
    debounce. Verified on hardware: API round-trip, range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
2026-07-15 Web probe display + probe target controls; clamp bogus RTD readings
    Status JSON gains a per-probe array (enabled, temp, target, food).
    POST /api/probe-target takes probe-index and target; target 0 mirrors
    the LCD wizard disable semantics (clears food and alarm), nonzero
    re-enables with prior settings, all NVS-persisted. Page renders a 2x2
    probe card grid with -5/+5/OFF controls per probe, optimistic updates
    with per-probe debounce. MAX31865 driver now clamps implausible
    conversions (unplugged probe reading raw code 0 without fault flag
    computed to -409.9F) to the 0.0F fault convention.
2026-07-15 Full-function web dashboard: modes, probe wizard, alarms, mDNS, WiFi screen
    Mode control (POST /api/mode) with LCD-identical guards; chips always
    visible and dimmed when unavailable, START/STOP contextual, confirm
    dialogs on start and shutdown. Full probe editor matching the LCD Set
    Probes wizard (target, meat type, alarm temp, alarm action — same
    lists) via POST /api/probe-config, pipe-delimited, LCD clear
    semantics, NVS-persisted. Alarm bar with tap-to-ack (POST
    /api/alarm-ack). Status JSON adds actuator flags, ET, per-probe EST,
    alarm temp/type, alarm text. Actuator pills, ET clock, richer probe
    cards. mDNS pelletpirate.local; Settings LCD screen gains a WI-FI
    section (status, RSSI, IP,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
2026-07-15 Cook audit logging: LittleFS CSV per cook, events + samples, web download
    New cooklog component on the 2.44MB storage partition. One CSV per
    cook (opens leaving Off, closes on return; oldest cooks rotate out).
    Sample rows every 30s/10s with grill/probes/target/PID duty/actuator
    states/RSSI; event rows logged immediately with full state snapshot
    and source attribution (lcd/web/auto) for target changes, mode
    changes, probe configs, igniter/fan transitions, alarms and acks.
    Pre-cook setup events buffer in RAM and flush when the cook starts.
    Auger toggles deliberately not evented (duty visible in samples).
    Every row flushed for power-loss safety. SNTP wall-clock via new
    Kconfig timezone (default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
2026-07-15 Cook profiles + dashboard probe navigation; SET PROBES menu item retired
    Profiles: snapshots of grill target + all probe configs as key=value
    files on LittleFS, auto-named date + first meat (no text entry),
    newest-first. New COOK PROFILES main-menu screen (position 5, replaces
    SET PROBES): SAVE CURRENT COOK + tap-to-load list. Matching web
    section with save button and confirm-on-load; endpoints
    /api/profiles, /api/profile-save, /api/profile-load. Loads apply to
    grill_state, persist to NVS, and log source-attributed events.
    Dashboard: encoder focus now walks TARGET, probes 1-4, Main; clicking
    a probe row opens Set Probes directly at that probe (new
    ui_set_probes_create_for), and all exits re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
    [ui_dashboard.c, ui_main_menu.c, ui_profiles.c]
2026-07-15 Profile delete: LCD hold-to-arm + web X buttons + /api/profile-delete
    LCD: hold a profile row to arm (row turns red DELETE?), click confirms,
    scrolling away cancels. Rows switched to SHORT_CLICKED since LVGL fires
    CLICKED on long-press release, which would self-confirm.
    [ui_profiles.c]
2026-07-15 UI fix: invert accent text to black on the orange focus bar
    Settings BRIGHTNESS/COOK LOG values and the profiles SAVE CURRENT COOK
    row were orange-on-orange (invisible) when highlighted.
    [ui_profiles.c, ui_settings.c]
2026-07-15 Fix crash on LCD profile delete: defer screen rebuild via lv_async_call
    Rebuilding the screen inside SHORT_CLICKED freed the button mid-release;
    LVGL then sent the trailing CLICKED to freed memory (group already
    emptied, so obj_delete_core skipped the indev reset). Save only survived
    because CLICKED is the last event in the chain; load had the same bug.
    [ui_profiles.c]
2026-07-15 Web: live profile-list sync via pv revision counter + in-page confirm modal
    Browser confirm() replaced with themed modal (delete/load/ignite/shutdown).
    Profile saves/deletes from either LCD or web bump profiles_revision(),
    pushed in the 1Hz status JSON so every open page re-fetches the list.
2026-07-15 LCD WiFi setup: scan, pick network, encoder keyboard password entry
    New Settings > WI-FI SETUP screen. Scan runs in a worker task; password
    via lv_keyboard (styled manually - the app is themeless, so the widget
    rendered invisible/unhighlighted stock). Credentials persist in NVS and
    override the Kconfig defaults. Group edit mode now cleared centrally in
    ui_load_screen - it leaked out of the keyboard and froze row navigation.
    [ui.c, ui_settings.c, ui_wifi.c]
2026-07-15 Web WiFi setup: SoftAP fallback, change-network UI, tap-to-type temps
    - 25s after boot without WiFi -> open AP PelletPirate-Setup at
    192.168.4.1; auto-stops 8s after joining a real network; LCD Settings
    advertises it. STA retry loop paused around scans so unprovisioned
    boards can still scan.
    - Dashboard WI-FI section: current SSID/RSSI, scan + password form,
    POST /api/wifi-set applies creds 750ms after replying.
    - Scan records moved to heap + httpd stack 8k (4k default overflowed in
    the scan handler and rebooted the board).
    - Probe TARGET/ALARM and grill target: tap the number to type an exact
    temp (numeric keypad), same clamps as the LCD.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
    [grill_state.h, ui_settings.c]
2026-07-15 Hardening: RTD fault safety, task watchdog, median filter, no silent fails
    - Grill RTD fault (0.0F) in an active mode: igniter inhibited, PID held
    (a fault reading winds output to max), 30s grace then forced SHUTDOWN
    burn-off + GRILL SENSOR FAULT alarm banner + auto cook-log event.
    - actuator_task and temp_task subscribed to the task watchdog (10s,
    panic=reboot -> boot GPIO holds return all triac outputs LOW).
    - 3-sample median filter on all RTD channels; fault transitions on
    in-use channels logged to the cook CSV (RTD grill FAULT / OK).
    - MAX31865: SPI errors now propagate (logged once per episode, read as
    fault); D0 LSB fault bit is cleared like FAULT_STATUS so it can't latch.
    -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
    [actuator.cpp, grill_state.c, grill_state.h, main.c, max31865.c, max31865.h, ui_dashboard.c]
2026-07-15 Graphs: LCD chart screen + web live graph + cook-log CSV charting
    - grill_state: rolling 1h graph ring (grill/target/4 probes, 30s samples,
    runs continuously), fed from temp_task.
    - LCD GRAPHS menu item (was a stub): lv_chart, autoscaled Y, right-aligned
    window, colored per-probe legend, click to exit. Styled manually
    (themeless app).
    - Web: GET /api/graph + always-on last-hour canvas chart on the dashboard
    (30s refresh); GRAPH button on each cook log renders the full cook CSV
    client-side in an overlay. Shared vanilla-canvas renderer, zero deps.
    - httpd max_uri_handlers 20 (16 registered).
2026-07-15 Graph legend/goals + white grill line; Stop Ignite confirmation both UIs
    - Web legend (GRILL/TARGET/P1:name -> goal); dashed goal lines per probe
    color with right-edge temp label; cook-log charts recover names+goals
    from PROBE cfg events in the CSV.
    - Target recorded in the graph ring even when Off (trend of target
    changes tells the cook-management story); GRILL = thick white line,
    TARGET = orange - same color grammar as the dashboard readouts.
    - LCD legend shows goal in text (P1 Brisket 203deg); no dashed lines on
    the 320px panel.
    - Stop Ignite now confirms: LCD routes to the ignite screen (red STOP
    variant, Main focused as safe default); web uses the themed modal.
    Co-Authored-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
2026-07-17 OTA + power-outage hardening: durable logs, hot restart, auto-resume, flame-out
    Post-first-cook fixes (power outages exposed most of these):
    - cooklog: fsync every row — fflush alone never committed to LittleFS,
    so every outage left 0-byte/missing cook files; write failures now log
    - OTA via web: /update upload page + POST /api/ota (?force=1 mid-cook),
    new partition table 2x1536K ota slots + 896K storage (NVS offset kept,
    settings/WiFi creds survive), bootloader rollback with 60s mark-valid
    - Hot restart: 115F Start lockout removed; button becomes Resume Cook,
    actuator promotes START->COOK immediately (igniter still inhibited hot)
    - Power-loss auto-resume: actuator persists mode+ta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
    [partitions.csv]
2026-07-18 Context: add firmware backlog (9 items, post-OTA batch)
    LCD idle dim, LCD actuator status, temp-drop alarm review, encoder
    alarm-ack bleed-through bug, 2s fan burst cycle, probe/jack assignment
    setting, log continuation across power-loss resume, cook-start timestamp
    on both UIs, green goal-reached alert vs red action alarm.
2026-07-18 Context: backlog item 10 — reached_band honest on target change (approved fix)
2026-07-18 Context: backlog item 11 — ack disables probe action alarm (one-shot)
2026-07-18 Context: backlog item 12 — EST review + Next Goal ET display
2026-07-18 Context: backlog items 13-15 — starvation warning, push notifications, V3 hopper switch
2026-07-18 Context: backlog item 16 — bounded-P hybrid smoke mode
2026-07-18 Context: backlog item 17 — cook profile engine (driver+passengers) with factory profiles
2026-07-18 Context: backlog item 18 — probe alarms stand down outside cooking modes
2026-07-18 Backlog items 1-14, 16-18: alarms, continuity, UI, push, profile engine
    Alarm engine overhaul: one-shot probe action alarms (ALARM_DONE) + green
    goal-reached alerts on both UIs; reached_band recomputed on target change
    (no more spurious temp-drop on a raise) + 60s dwell + auto-clear on
    recovery; probe alarms stand down outside cooking modes; pellet
    starvation early warning (auger pegged + temp diving -> CHECK PELLETS).
    Cook continuity: wall-clock cook start persisted (survives power loss,
    shown on LCD + web); log file continues across power-loss resume (append
    + POWER LOSS row, rotation spares the active file); ET restored from
    wall clock.
    UI: LCD idle dim to 25% after 5 min (encoder wakes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
2026-07-18 Settings: GRILL PROBE JACK P1-P5 (product language, not PCB refs)
2026-07-18 Add USER_MANUAL.md — complete V2 controller user documentation
    19 sections: safety, quick start, probe wiring/PT100 guidance, controls,
    mode reference (incl. smoke-band semantics), dashboards, alarm reference
    (green/red, one-shot vs re-arm), cook programs + factory profiles +
    authoring format, profiles, logs, verbose settings reference, ntfy
    setup, WiFi, OTA updates, safety systems, power-outage behavior,
    troubleshooting (drawn from real incidents), full specs table.
2026-07-19 Add printable PDF of the user manual (Letter, 23 pages)
2026-08-21 Checkpoint: V4/S3 firmware port (boardpins dual-target layer)
    Snapshot of the V4 port interrupted by the 2026-08-21 PC freeze during
    its first build. All 15 files verified intact post-crash (no NUL bytes,
    complete content, written 1:53-1:55 PM before the build launched).
    - New boardpins component: single source of truth for GPIO maps,
    esp32 = V2 DevKitC, esp32s3 = V4 (netlist-verified 2026-08-21)
    - encoder/actuator/backlight/main switched to BOARD_* pin macros
    - sdkconfig.defaults split: common + per-target (esp32 / esp32s3)
    - partitions_s3.csv: 16MB table, 2x 3MB OTA slots + 9.9MB LittleFS
    - S3: octal PSRAM enabled, console on native USB-Serial-JTAG
    Not yet built successfully on either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
    [partitions_s3.csv]
2026-08-21 V4 bring-up day 1: enclosure orientation, SPI fixes, plug-and-show probes
    Board 1 verified end-to-end 2026-08-21: boots on native USB (COM10),
    all 5 RTD jacks probe-tested (J1=CS4, J2=CS12, J3=CS21, J4=CS47,
    J5=CS48), stable readings with LVGL live.
    - LCD flipped 180 for the V4 enclosure via per-board BOARD_LCD_MADCTL
    (V4=0x00, V2=0xC0 unchanged)
    - Jack CS map is now front-panel-ordered BOARD_JACK_Pn_CS: V4 panel
    labels run opposite the PCB refs (P1=J5 ... P5=J1); V2 unchanged
    - max31865: settle the shared SPI bus in mode 3 BEFORE asserting the
    manual CS. Coming from LCD traffic (mode 0) the clock idle-level flip
    landed inside the CS window and misframed transfers: config readback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
    [boardpins.h, grill_state.c, grill_state.h, hx8357d.c, main.c, max31865.c, ui_dashboard.c]
2026-08-23 V2 boards adopt V4 enclosure orientation: LCD 180 flip + reversed jack map
    LCD MADCTL 0xC0 -> 0x00 and front-panel jack order reversed to match the
    V4-style enclosure: P1=J5/CS21, P2=J4/CS26, P3=J3/CS5, P4=J2/CS13,
    P5=J1/CS27 (was P1=J1 ... P5=J5).
    OTA'd to all three V2 boards 2026-08-23 (board 2 = .178, board 3 = .179,
    board 1 = .185, resurrected). Jack remap live-verified on boards 1 and 3:
    probe in J5 read P5 pre-update, reads grill/P1 post-update. This build
    also carries the ae085f0 shared fixes to V2: MAX31865 mode-3 settle
    before CS, init retry, plug-and-show probes.
    [boardpins.h]
2026-08-23 Manual rev 1.1: probe jack order changeover + plug-and-show probes
    Documents the 4a09097 panel-vs-PCB jack numbering (P1=J5 ... P5=J1)
    with a service note, and the plug-and-show LCD dashboard behavior.
    PDF regenerated (26pp Letter).
2026-08-24 pelletpirate_V5: project baseline — V2 clone + V4 feature blocks pasted
    V5 = V2 PCBWay 2026-05-08 clone (Save As). Schematic now carries the
    V4 net-new blocks pasted with refs and all supporting passives intact
    (verified by ref-count diff against V4): ESP1 S3 module + strapping/
    decoupling, S1/S2 boot-reset, U1 USBLC6 + J8 USB-C + CC resistors,
    U3 H11AA1 + ZC chain (R41/R42/R43/C42), J9 hopper network, LED1,
    J7 power header, MOC4 = MOC3053M staged for the fan-channel swap.
    Board untouched (still V2 copper + DevKit rails) — pre-Update-PCB
    checkpoint.
    Also: V4 library folders copied in (S3, USB, optos, switches, LED),
    fp-lib-table gains those entries, drops a broken backups entry, and
    hea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
    [Copy of T-1N4W181746A-6.23-answers 2026-06-23.xlsx, ESP32-DEVKITC-32E.step, ESP32-S3-WROOM-1U-N16R8--3DModel-STEP-56544.STEP, ESP32-S3-WROOM-1U-N16R8.step, FH26-39S-0.3SHW_05_.step, FH26W-39S-0.3SHW_60_.step, H11AA1M.step, KMR221GLFS.step]
2026-08-24 V5 Phase A complete: S3 schematic surgery, ERC clean
    DevKit rails (ESP_J2/ESP_J3) deleted; F1 onboard fuse RETAINED (in
    series with proven AC copper; inline panel fuse is supplementary).
    S3/USB/ZC/hopper blocks stitched to V2 nets by label — SDO line
    standardized to ALL_SDO fleet-wide (was MAX_SDO on V2). Fan channel
    converted by-the-book: true MOC3053M symbol (full MPN/DigiKey fields)
    wired in and re-referenced as MOC3 so Update-PCB maps onto the
    existing AC-island footprint; R9 330->180 ohm with real part fields
    (anti-sulfur pulse-withstanding 0805 per V4 BOM). NC flags verified
    on IO35/36/37 (PSRAM) and unused pads. ERC: 0.
    [PelletPirate_V5.kicad_sch]
2026-08-25 V5 Phase B/C checkpoint: Update-PCB applied, placement in progress
    Board now carries the full V5 netlist: S3/USB/ZC/hopper/switch/LED
    footprints on board, SDO net renamed to ALL_SDO across existing copper
    (tracks preserved), fan channel = MOC3053M with verified Panasonic
    ERJ-UP6F1800V drive resistors, DNP flags cleared, WirePad5 relinked.
    New parts rough-placed; nets locked next, then arrangement and routing.
    FPC1 decision: moving to top-left (side B) pending flex-reach check.
    Hard-won process lessons this session: Update-PCB must run with
    re-link-by-reference CHECKED (UUID matching deletes re-associated
    footprints); preview dialogs can serve stale reports — regenerate
    fresh after schemat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
    [PelletPirate_V5.kicad_pcb, PelletPirate_V5.kicad_sch]
2026-08-25 V5: net classes + custom DRC rules live; routing underway
    Ported V4's 15 net classes with all five dead patterns FIXED (ALL_SCLK,
    ALL_SDO, U3-IN2, PS1-+VO, ESP1-* — were silently unmatched typos in V4)
    plus new memberships for the snubber midpoints. Created
    PelletPirate_V5.kicad_dru: V4's 7 rules incl. the 2.5mm mains-SELV
    barrier (values verified against the 2026-07-28 fab archive), with the
    U3-IN2 name-crutch clauses removed per the file's own TODO. Netclass-
    width routing confirmed working. AC-side placement done; U3 on the
    isolation boundary, ZC RC parts near ESP1.
    [PelletPirate_V5.kicad_pcb, PelletPirate_V5.kicad_sch]
2026-08-26 V5: connector swaps + MAX CS remap; routing in progress
    J8 -> GCT USB4145-03-0070-C vertical USB-C (VBUS_A/B and split data
    pins tied per Type-C practice); J9 -> Same Sky TB002-500-02BE 5.00mm
    screw terminal (TB007 files replaced with correct TB002 set). MAX CS
    lines re-pinned for routing reach: MAX3_CS -> module pad 35 (IO42),
    MAX1_CS on a new IO, MAX2/4/5 shuffled among the existing CS GPIOs —
    final CS-to-jack map to be extracted from netlist at audit and carried
    into boardpins.h as the V5 target delta. 94 DRC violations remain to
    triage.
    [PelletPirate_V5.kicad_pcb, PelletPirate_V5.kicad_sch, TB002-500-02BE.step, usb4145-03-0070-c.stp]
2026-08-27 V5 DRC Clean / ERC Clean
    USB-C corner closed out:
    - USB4145 footprint copper verified against GCT drawing (unproven-source flag retired)
    - Per-pad solder mask expansion zeroed -> real 0.2mm mask dams (10 aperture-bridge DRC cleared)
    - Hidden power-in duplicate pins (A9/A12/B9/B12) converted to hidden passive (shield-pin style); implicit VBUS_A/GND_A global net injection eliminated
    - Net renamed VBUS_A -> /VBUS; USB netclass pattern fixed to /VBUS (silent class dropout repaired)
    - ERC 0/0 verified via kicad-cli at all severities; DRC clean with fresh zone fills
    - Top-half placement plan sketch added (MAX tiles under jacks, ESP south, U3 east, PS3 to FPC backlight end)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
    [PelletPirate_V5.kicad_pcb, PelletPirate_V5.kicad_sch]
2026-08-27 V5 pre-library-localization safety checkpoint
    - Audit remediation complete: corridor items 1-5 + 7 closed (LED/SPI reroute,
    J4 overlays, CS nudges, MAX5_CS old run deleted, ZC_DET+GND test points TP1/TP2,
    parity field sync). ERC 0/0, DRC 0/0, parity 0.
    - New-connector audit: J8 USB4145 + J9 TB002 verified against datasheets;
    finding F1 open (stake variant 0070 -> 0170 swap pending)
    - USB_try2: staged 0170 symbol (hidden-pin-fixed) + footprint + STEP
    - V5_Library_Localization_Plan.md: proposed plan, not yet executed
    [PelletPirate_V5.kicad_pcb, PelletPirate_V5.kicad_sch, usb4145-03-0170-c.stp]
2026-08-27 V5 library localization: project-local symbols + table hygiene
    - NEW project sym-lib-table (21 entries, same nicknames, KIPRJMOD URIs) shadows
    global table -> all 20 schematic nicknames resolve inside V5; design files untouched
    - Copied 5 missing symbol files in (12 were already identical in V5); rescued
    fuse-holder symbol from Downloads; displaced 2 differing V5 copies to archive
    - fp-lib-table: removed 12 dead/retired entries, added missing SameSky_Screw_Terminal
    - Archived to archive_to_delete/library_localization_2026-08-27: DevKit-era libs,
    PBO try2, old PEC16 encoder lib, stray ESP dir, USB4105 leftovers, .bak files
    - Verified post-op: ERC 0 / DRC 0 / parity 0, ESP symbol EPAD fi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
    [ESP32-DEVKITC-32E.step, ESP32-S3-WROOM-1U-N16R8--3DModel-STEP-56544.STEP, ESP32-S3-WROOM-1U-N16R8.step, PBO-5F-12_pp2.step, PelletPirate-2026-05-02-Rev02.kicad_sch, PelletPirate_V2_backup4.kicad_sch, R46KF310000M1M.step, USB4105-GF-A--3DModel-STEP-510211.STEP]
2026-08-27 V5 pre-BOM-fill checkpoint: J8 0170 swap in sch+board, footprint/mask cleanups, BOM fill table
    [PelletPirate_V5.kicad_pcb, PelletPirate_V5.kicad_sch]
2026-08-27 V5 BOM complete: all fields filled, zero gaps
    Scripted field fill (approved by user, KiCad closed, verified via kicad-cli):
    - 28 parts filled with MF/MP/LINK (V4-sourced parts value+footprint matched;
    new parts DigiKey-verified: B32921C3103M000 X2 snubber caps, ERJ-1TYJ390U,
    RC0805FR-07330RL, RC0805FR-07100KL)
    - LINK fills for J1-J5/J9/F1; J4 cache-collision handled (insert into instance)
    - R6 omega normalized to match R9 (BOM line un-split)
    - TP1/TP2 excluded from BOM
    Final: 117 BOM rows, 0 missing MP/MF/LINK, ERC 0
    [PelletPirate_V5.kicad_sch]
2026-08-27 V5 field sync to board complete: ERC 0 / DRC 0 / parity 0
    BOM fields (MF/MP/LINK on 35 parts) synced sch->pcb via Update-PCB.
    Board and schematic fully consistent. BOM: 117 rows, 59 unique MPNs, no gaps.
    [PelletPirate_V5.kicad_pcb]
2026-08-27 V5 PCBWay quote package + boardpins.h delta doc
    - PCBWay/: gerbers.zip (9 layers + drill 279 holes/25 slots + map + job),
    positions.csv (136 parts both sides), BOM.csv (61 lines / 117 components,
    15 NO-SUBSTITUTION safety lines)
    - boardpins_delta.md: V5 firmware pin map — front-panel jack order P1..P5=MAX1..5
    (reversal eliminated in copper), CS deltas vs V4, IO47 freed, bring-up notes
    [PelletPirate_V5-B_Cu.gbl, PelletPirate_V5-B_Mask.gbs, PelletPirate_V5-B_Paste.gbp, PelletPirate_V5-B_Silkscreen.gbo, PelletPirate_V5-Edge_Cuts.gm1, PelletPirate_V5-F_Cu.gtl, PelletPirate_V5-F_Mask.gts, PelletPirate_V5-F_Paste.gtp]
2026-08-27 V5 3D model completeness: all material parts wired to STEP files
    - J8 USB-C, S1/S2 boot switches: models added (were absent)
    - MAX1-5 -> MAX31865ATP+.STEP, J6 -> DF13 vendor STEP, L3 -> srr4028.stp,
    ESP1 -> lib-folder step (dead archived path removed): paths repaired
    - Remaining without models by design: FID/MH/TP; wire pads reference
    a stock model KiCad does not ship (cosmetic)
    117/136 footprints render; DRC 0/0 unchanged
    [PelletPirate_V5.kicad_pcb]
2026-08-27 V5 PCBWay: assembly notes + DNS parts doc; PS1 MF corrected to CUI Inc. in BOM
    [PelletPirate_V5_BOM.csv]
2026-08-28 V5v1: self-contained enhancement clone of V5 (next-run holder)
    - Full project copy, all 5 core files renamed, every internal reference patched
    (pro meta/sheets/BOM path, 189 sch instance-project refs, 130 pcb sheetfile refs, prl)
    - sym/fp-lib-tables 100% KIPRJMOD -> zero references outside the folder
    - Excluded V5-specific: backups, archive, PCBWay order package, session files
    - Verified from new dir: ERC 0 / DRC 0 / parity 0 (self-containment proof)
    - V5v1_ENHANCEMENT_BACKLOG.md: USB VBUS 100nF at U1.5, optional TP2 move,
    silk version bump, placeholder for rainbow-hunt findings
    [31-8201.stp, DF13-4P-1.25DSA(25).STEP, ESP32-S3-WROOM-1U-N16R8.step, FH26W-39S-0.3SHW_60_.step, H11AA1M.step, KMR221GLFS.step, LQH3NPH2R2MMEL.step, LQH43PN3R3M26L.step]
2026-08-28 V5v1: PS1 MF harmonized to CUI Inc. (Bel/CUI dual-brand, same product - not an error fix)
    [PelletPirate_V5v1.kicad_sch]
2026-08-28 Fix C9/R20 package mismatches: 0402 MPNs on 0805 footprints -> 0805 parts
    - PCBWay BOM: C9 -> C0805C104K3RACTU, R20 -> RC0805FR-0710KL (both DK-verified in stock)
    - V5v1 sch fields updated to match copper; backlog notes the 0402 shrink path for V5.1
    - Root cause: V4 value-matching missed footprint check on these 2 of 61 lines
    [PelletPirate_V5_BOM.csv, PelletPirate_V5v1.kicad_sch]
2026-08-28 V5 post-cancel fixes: C9 0402, C43 VBUS ballast, C39/C40 boot pair, R20 0805
    Order cancelled 2026-08-28; V5 is the active design again. Fixes since:
    - C9: footprint corrected to 0402, MPN C0402C104K3RACTU (package now matches part)
    - C43 NEW: 100nF 0402 at U1 pin 5, /VBUS->GND ESD ballast (verified 1.63mm from pin)
    - C39: EN cap 0.1uF -> 1.0uF 25V KEMET C0603C105K3RACTU (0603 X7R) per Espressif
    - C40: IO0 debounce cap rewired +3.3V -> GND (orthodox; linked with C39 change,
    EN delay 10ms >> IO0 rise 1ms, boot-strap race eliminated)
    - R20: MPN corrected to RC0805FR-0710KL, footprint normalized to plain 0805
    Audits passed on this state: ESP32 pin-by-pin (zero notes), MAX1-5 tiles,
    H11AA1/MOC3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
    [PelletPirate_V5.kicad_pcb, PelletPirate_V5.kicad_sch]
2026-08-28 V5 live DigiKey BOM verification: 58/58 MPNs verified, 0 spec mismatches
    47 lines confirmed in stock w/ spec match; 3 live stock flags (RC0402 10k OOS
    sub-allowed, onsemi MOC3063M OOS w/ Lite-On alternative = DECISION NEEDED,
    SJ1-3523NG backorder informational); 8 pages-verified/stock-check-at-order
    incl HIGH WATCH on PBO-5F-12 (DNS, family constrained)
2026-08-28 V5 footprint verification sweep: 137/137 library-faithful, J8 0170 land re-verified vs GCT drawing, all shapes have provenance
    Deep re-verification program complete: reconciliation 0 errors, live-DK 58/58
    0 spec mismatches, footprint sweep 0 defects. Reorder gate = rainbow verdict.
2026-08-28 Rainbow hunt session 1: MECHANISM FOUND - PS1 burst-mode comb on panel rail
    Scope session on V4 board 2 (unmodified): 3.3V rail = 29mVrms bench vs
    110-129mVrms AC (x4.5). Disturbance is line-UNcorrelated (ratio 1.01),
    continuous, spectrally a ~7kHz burst comb of PS1's ~117kHz flyback switching.
    Backlight load sweep flat. Chain: PS1 bursts -> 12V comb -> through PS2 ->
    panel 3.3V -> HX8357D pump upset -> rainbow. Consistent with every prior
    elimination (circuits, polarity, layout all innocent).
    Open: why V2 clean (V2 clip-on session next); dummy-load test; fix = 12V
    LC filter / min-load / panel-rail post-filter for V5.
    Full findings doc + all capture artifacts included.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
    [AC_3V3_100ms_deep.csv, AC_3V3_2ms_trace.csv]
2026-08-28 Rainbow hunt session 2 (V2 comparison): MYSTERY SOLVED
    V2's PS1 ALSO bursts (same ~6kHz comb + ~114kHz flyback) - normal part
    behavior. Differential = downstream attenuation: V2 12V 32mVrms vs V4
    74mVrms; V2 3.3V 49mVrms (clean) vs V4 110-129mVrms (rainbow). Panel
    upset threshold bracketed 50-110mVrms. V2's DevKit added 3.3V bulk+load
    damping that V4's leaner design lost.
    V5 fix plan: 12V LC filter into PS2 + 3.3V bulk + panel-rail post-filter,
    acceptance <30mVrms on AC. Optional board-5 bodge validation first.
2026-08-29 Rainbow CASE CLOSED: marginal panel x V4 comb; bulk-cap bodge insufficient; board 5 retired (PS2 broken)
    Session 3: 100uF bodge on board 2 halved rms (120->58mVrms) but 7/14/21/28kHz comb
    survived and rainbow persisted. Panel census (4 units): only 1 panel rainbows; it is
    clean on bench and clean on V2-AC. V5 fix = ferrite/LC stack, not bulk alone.
    Board 5 disqualified: PS2 regulates 3.3V rail at 4.41V.
2026-08-29 Board 3 survey: same comb (96mVrms), clean LCD with good panel — fleet consistent, panel-dominant
    Also archives the missing valid unbodged V4 deep spectrum (board3_AC_3V3_spectrum.json).
2026-08-29 Board 4 survey: noisiest healthy board (185mVrms, 3.5kHz comb), DC gradient 3.31->4.41 flagged
    Good panel barely flickers at 185mVrms while marginal panel rainbows at 58:
    panel immunity spread >3x, panel variance dominant. PS2 setpoint gradient
    tracks noise rank; DMM cross-check on board 4 queued.
2026-08-29 DMM confirms board 4 rail at 3.50V: D-CAP2 valley-regulation shift unifies DC gradient with noise rank
2026-08-29 Session 4: case reopened — comb-amplitude model dead, symptom = stochastic SPI corruption; PBO-5F cap-load spec violation found+fixed on board 2
    - PBO-5F datasheet: max cap load 470uF (12V model); V2/V4/V5 all at 690uF = 47% over. First concrete spec violation. Board 2 C13->220uF (donor board5 C15), rail now 440uF in spec.
    - Comb correlation killed: clean boots at 7k=4.3/7.0mV vs flaky at 5.0mV.
    - Dummy load +75mA: no resolvable effect. TPS562201 cluster: 100% per datasheet, no changes.
    - Symptom reclassified: orange<->green write-time flips = RGB565 bit-shift = SPI corruption.
    - Next: SPI glitch hunt with soldered SCLK tail. V5 reorder ON HOLD pending concrete resolution.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
2026-08-29 SCLK hunt: AC-only trigger events at SCLK node (26/min AC vs 0 bench); idle line lifted to 956mV on AC; 1x-probe fault-injection proved clock->corruption chain
    Fingerprint elusive: events too rare/boundary-level for stored-sample capture even at 1.25GSa.
    Sentinel = runt trigger 0.99/2.31V, the repeatable AC-vs-bench discriminator.
2026-08-29 RETRACTION: no PBO-5F cap-load violation — board IS the datasheet Fig 2 circuit (C13-L1-C15 = Bel recommended pi-filter)
    User caught Table 1 p5: 12V column specifies 470uF+2.2uH+220uF+SMBJ20A = C13/L1/C15/D1 verbatim.
    470uF max = direct module load only. Board 2 C13 transplant was false-premise; restore 470uF.
    Mitigation reordered: SPI series R + panel-feed filter + GND stitching primary; pi-filter moot.
2026-08-29 Session 5 CASE CLOSED: three-way sentinel verdict — V4-AC 26/min, V4-bench 0, V2-AC 0
    V2 immunity = DevKitC raft (local GND pour + bulk/bypass), confirmed at the victim node
    by direct measurement. V5 prescription: rebuild raft + SPI series R + panel-feed filter.
    Acceptance: sentinel 0/min on AC on first article.
2026-08-30 V5 raft complete: 4 work packages + C48 damping bulk, all audited, ERC/DRC/netclass clean
    WP1: C44/C45 22uF at ESP (raft bulk). WP2: 33R series R at SPI driver pads (R48-51,
    stubs <2.2mm). WP3: FL1 bead + C46/C47 panel island (/3V3_LCD, FPC-only membership).
    WP4: L5 HF bead after Fig-2 network (D1/C15 upstream preserved) + C48 220uF damping
    bulk (resonance 50k->12kHz, Q~1). Netclass patterns added for /3V3_LCD + Net-(C15-Pad1).
    EE-soundness review: resonances quantified, Middlebrook margin 80x, timing budgets clear.
    Acceptance: runt sentinel 0/min on AC at first article.
    [PelletPirate_V5.kicad_pcb, PelletPirate_V5.kicad_sch]
2026-08-30 V5 PCBWay package regenerated: raft revision, 61 lines / 129 components, 19 no-sub lines
    Gerbers+drill (25 slots), positions (148), BOM with FL1/L5/C13/C15+C48 no-sub additions,
    assembly notes updated (J9 orientation, C48 polarity, supersedes cancelled 08-27 upload).
    Old package archived to archive_to_delete/. L5 601 value+footprint+3D model settled.
    J9 flipped: entry faces west edge. Final ERC/DRC 0/0, parity 142/142.
    [PelletPirate_V5-B_Cu.gbl, PelletPirate_V5-B_Mask.gbs, PelletPirate_V5-B_Paste.gbp, PelletPirate_V5-B_Silkscreen.gbo, PelletPirate_V5-Edge_Cuts.gm1, PelletPirate_V5-F_Cu.gtl, PelletPirate_V5-F_Mask.gts, PelletPirate_V5-F_Paste.gtp]
2026-08-30 V5 PCBWay order PLACED 2026-08-30: as-ordered BOM (L5 ferrite DigiKey link added), V5 library assets + backups, cancelled 8/27 order archived
    [31-8201.stp, BLM21PG221SN1D.step, BLM31PG601SN1L_flyman.step, DF13-4P-1.25DSA(25).STEP, IND_BLM31PG391SN1L_MUR.step, MAX31865ATP+.STEP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]
2026-08-30 Bring full design history into git + repo cleanup
    - Add never-tracked KiCad projects: PelletPirate_V3, PelletPirate_V4, ESP_Breadboard (+V2_Quilter), FPC_for_PCB_to_LCD RevC-RevH flex designs
    - Add esp_breadboard_test_fw source (build/ ignored)
    - Remove stale root PNGs/PDFs and old V2 backup zips/libs (moves detected as renames)
    - Ignore >100MB local archives (gen_channels.zip, PelletPirate_V3.zip, BACKUP_ZIPS/) and S3 build artifacts
    [.kicad_sch.kicad_sch, B3F-1000.step, Copy of T-1N4W181746A-6.23-answers 2026-06-23.xlsx, Critical_Dimensions.csv, ESP32-DEVKITC-32E.step, ESP32-S3-WROOM-1U-N16R8--3DModel-STEP-56544.STEP, ESP32-S3-WROOM-1U-N16R8-BigBoy.step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]
2026-08-31 V5v1 re-cloned fresh from as-ordered V5 (supersedes stale 80a9e8e clone)
    V5 = frozen as-sent-to-PCBWay reference; V5v1 = working copy for all future tweaks.
    Core files renamed + all internal refs patched (142 pcb sheetfile, 203 sch project,
    pro meta/sheets/bom-path now local). Excluded: backups, archive_to_delete, PCBWay pkg.
    ENHANCEMENT_BACKLOG carried over. Verified from new dir: ERC 0, DRC 0, unconnected 0.
    [BLM21PG221SN1D.step, BLM31PG601SN1L_flyman.step, IND_BLM31PG391SN1L_MUR.step, PelletPirate_V5v1.kicad_pcb, PelletPirate_V5v1.kicad_sch]
2026-09-03 Scope cross-cal COMPLETE: MHO954 certified as V5 acceptance fixture
    Same-session A/B on V4 board 2 (AC, SCLK tap), 2026-09-02/03:
    - Sentinel: 954=124, 814=127 catches/5min, BOTH loop-saturated (~2.4s
    re-arm ceiling; original 26/min was the same ceiling, not a rate).
    Zero-count acceptance + 0.99/2.31V runt thresholds transfer as-is.
    - Idle-peak: 814=785mV / 954=922mV (RMS floors identical ~12mV);
    954 reads ~1.2x hotter at 500MHz. V5 criterion stays <300mV full-BW
    on the 954 (stricter than 814 original; bad V4 = 3x over threshold).
    - DHO814 evidence chain transferred; free to ship back before 09-28.
    Harness: PP_SCOPE_IP env override (default .188), runt_sentinel.py
    capture-prefix arg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
2026-09-03 V5v1 backlog: SCLK test point (item 6), rainbow placeholder resolved
    SCLK was the most-probed net of the rainbow saga yet has no TP on V5
    (J7 covers 12V/3.3V/GND/LED+; TP1/TP2 cover ZC). V5 first articles:
    screen via J7 rails first, soldered SCLK tail only if needed. Item 4
    placeholder marked resolved (raft rev shipped inside V5 pre-order).
2026-09-23 Sharp GP2Y0E02A ADC2/WiFi coexistence test rig on ESP_Breadboard
    Rewrites the blinky validation FW into the V5 J9/IO14 gamble test:
    20s WiFi-off ADC2_CH3 baseline, then WiFi STA (PS_NONE) + UDP
    heartbeat + HTTP dashboard (live %-full gauge, Set EMPTY/FULL cal,
    median-of-9 + EMA smoothing) while retry-loop sampling counts
    ESP_ERR_TIMEOUT. Bench result 2026-09-22: 4400+ samples, ZERO
    timeouts -- ADC2+WiFi conflict never manifested on IDF v5.3.2/S3.
    WiFi creds follow the pelletpirate_ESP pattern: Kconfig defaults in
    tree, real values only in sdkconfig, which is now untracked and
    gitignored. serial_capture.py added for headless USB-Serial-JTAG
    log capture (DTR asserted, RTS never pulsed).
    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
2026-10-02 V5 board support: front-panel CS map, board-revision Kconfig, build_s5 target
    - boardpins: new PelletPirate-board-selection Kconfig choice (S3 only,
    default V4 so existing build_s3/V4 builds are unchanged)
    - boardpins.h V5 branch per PelletPirate_V5_boardpins_delta.md:
    P1..P5 = J1..J5 = MAX1..5, CS = IO4/48/42/12/21 (enclosure reversal
    eliminated in copper); MADCTL 0xC0 expected-flip (verify at first boot);
    hopper IO14 note updated for GP2Y0E02A analog sensor (R40 DNP)
    - sdkconfig.s5 = sdkconfig.s3 + CONFIG_PELLETPIRATE_BOARD_V5=y; builds
    land in build_s5 (gitignored) alongside build (V2) and build_s3 (V4)
    First-article validated on V5 board 1 (MAC 90:70:69:0d:02:48): flashes
    over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
2026-11-07 V5 fan AC phase control: fanphase component, 3-rung validation complete
    - New components/fanphase (V5-only): H11AA1 ZC reference on IO8 with
    dead-time edge qualification (raw line chatters; measured 120Hz,
    period 8331us +/-10, HIGH pulse ~312us leading true zero by ~156us),
    free-running 1MHz GPTimer fires the MOC3053 on IO10 per half-cycle,
    hold-until-next-ZC for guaranteed latch on the inductive fan load.
    - Power-linear level mapping (inverse conduction integral table);
    phase-linear steps clustered into 3 audible speeds on the bench,
    power-linear gave 6 distinct gradients. Floor 30% power (min stable
    fan speed), ZC-loss failsafe = full on.
    - actuator.cpp V5 branch: fanphase ow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
2026-11-11 V5 WiFi provisioning fixes: internal-heap exhaustion + APSTA beacon drag
    Board 1 setup AP beaconed but the provisioning page never served, and
    phones could not even see the SSID. Two root causes, both found via new
    instrumentation (httpd_start error + internal-heap margin now logged):
    - httpd_start returned ESP_ERR_HTTPD_TASK with only 2.5KB internal heap
    free: on the S3, static data + LVGL DMA draw buffers + WiFi in APSTA
    mode consume the shared DIRAM pool. sdkconfig.s5 now sets
    CONFIG_SPIRAM_TRY_ALLOCATE_WIFI_LWIP=y, moving WiFi/LWIP buffers to
    PSRAM; 44KB internal free with the server running.
    - The unconditional STA reconnect (every ~2.8s) dragged the softAP
    beacon across cha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
2026-11-11 Split KiCad designs into their own repo (brbeardm/PelletPirate-KiCad)
    This repo is now firmware/software/bench-tooling only. The KiCad/ tree
    is untracked and gitignored; the folder stays in place on disk and is
    its own git repo pushed to github.com/brbeardm/PelletPirate-KiCad.
    All pre-split design history remains reachable here.
2026-11-11 Track hopper gauge feature spec; ignore __pycache__
2026-11-11 Pushover push notifications on S3 boards: emergency alarms that wake you
    ntfy arrives as a default-priority ding - useless on iPhone for a 4 AM
    flame-out. Pushover emergency priority re-sirens every 30s until
    acknowledged and bypasses silent mode.
    - pushover_send over HTTPS (esp_http_client + cert bundle), S3-only
    (V2 lacks flash for TLS and stays on ntfy; push_send routes to
    whichever service is configured, Pushover preferred)
    - Priority map: sensor fault / pellet starvation / fire-out = emergency
    (siren, retry 30s, expire 1h); probe & wrap & done & program = high
    (breaks quiet hours); test push = normal
    - Keys in NVS via GET/POST /api/pushover (never in the repo); web UI
    setting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
2026-11-11 Hopper gauge v1: Sharp GP2Y0E02A %-full on LCD + web + Pushover (V5)
    Read-only first-cook version per the hopper feature spec: sense ->
    display -> notify. No state-machine coupling (PELLET HOLD is stage 2);
    worst failure mode is a wrong number on a screen.
    - components/hopper: ADC2_CH3/IO14 sampler ported from the validated
    esp_breadboard_test_fw rig (median-of-9 + EMA burst every 3s, ADC2
    retry armor). Health: <250mV = sensor absent -> pct -1, never alerts.
    Cal: depth-in-inches curve (6-18in, NVS) or two-point capture override.
    V2/V4 compile to stubs; grill_state.hopper_pct stays -1 there.
    - grill_state: hopper_pct / hopper_mv / hopper_alert fields.
    - webui: pel field in status JSO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
