brbeardm/PelletPirate/(notices)

Notices in the files:
KiCad/PelletPirate_V4/archived_symbols_footprints_not_used/PBO-5F-12_PelletPirate/PBO-5F-12.step:
author */ ('License CC BY-ND 4.0'),
